BisocMOrg/Keel/chassis/renders/assets/keel_mask_apertures.png

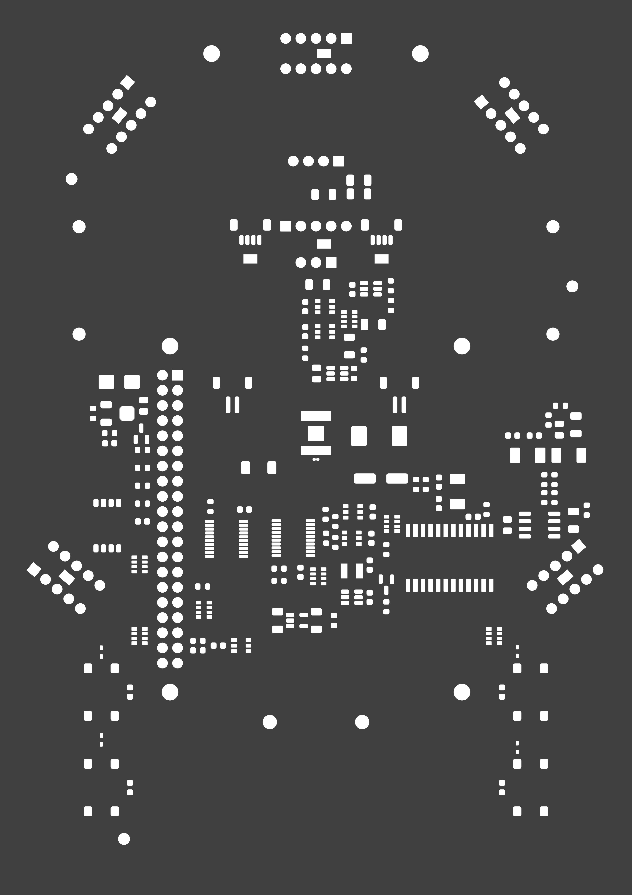
chassis/renders/assets/keel_mask_apertures.png
