BisocMOrg/Keel/chassis/renders/assets/keel_silkscreen_white.png

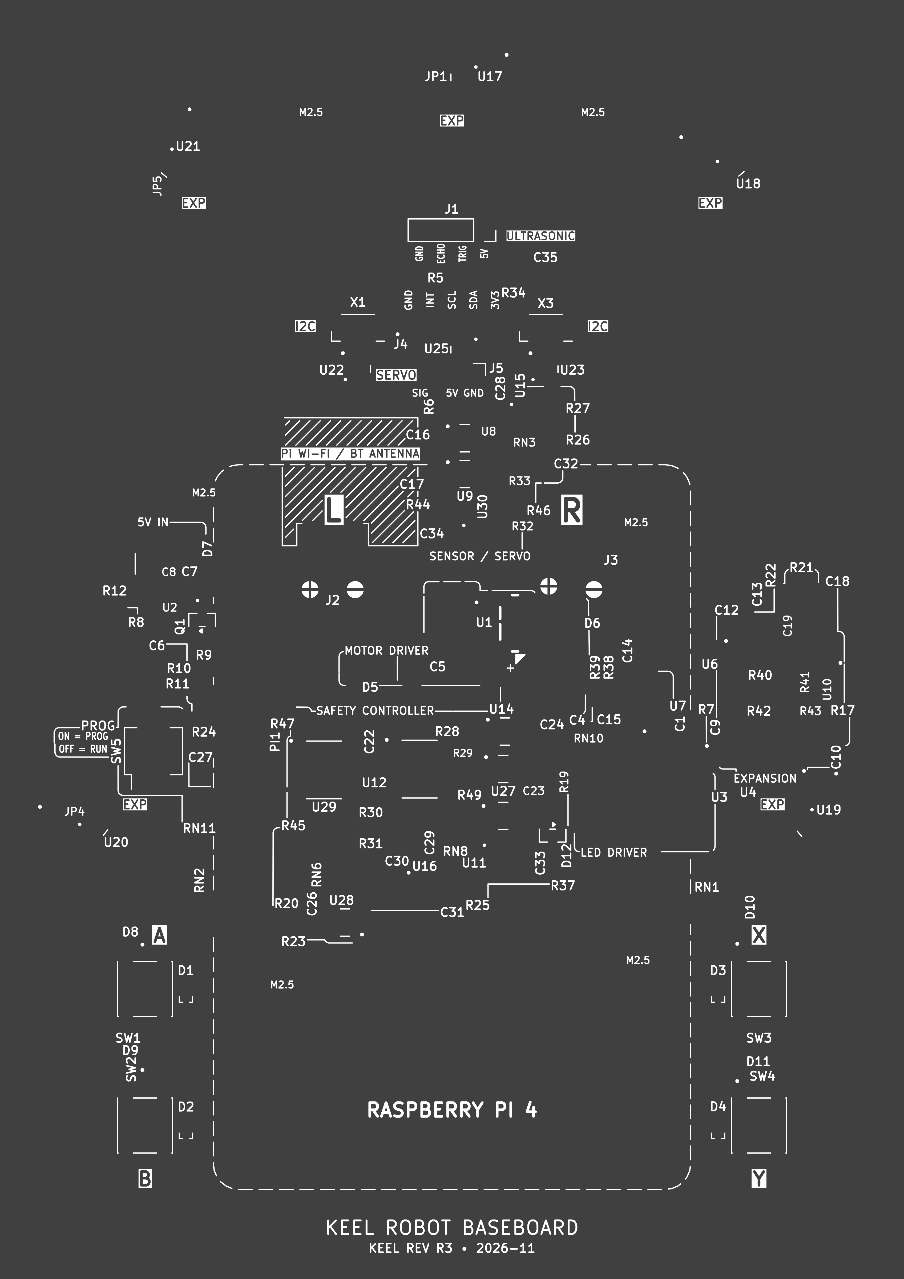
chassis/renders/assets/keel_silkscreen_white.png
