BisocMOrg/Keel/hardware/physical/1_IMG_20261031_002630.jpg

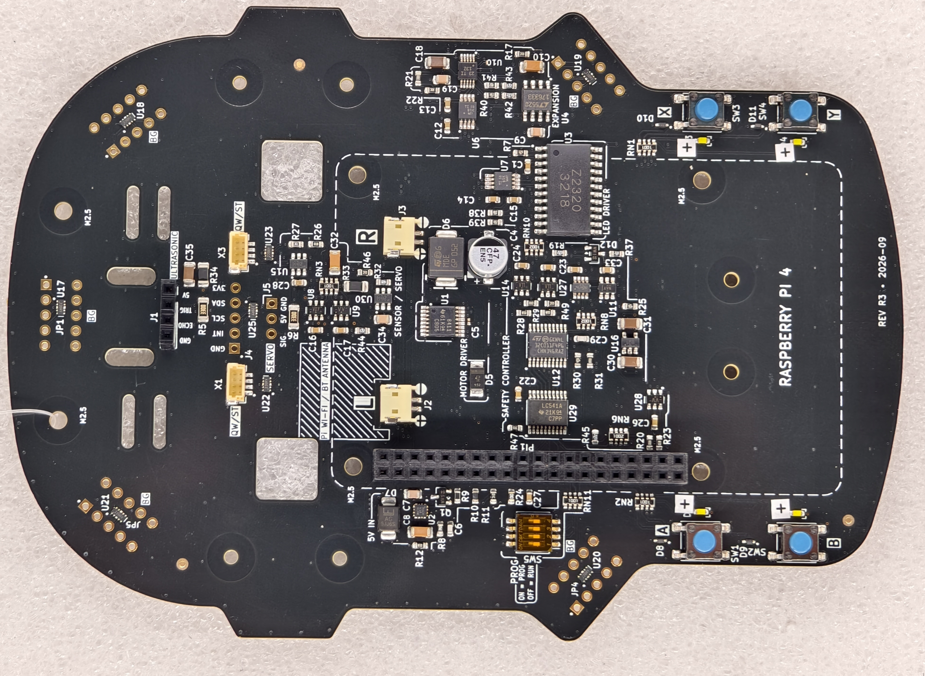
hardware/physical/1_IMG_20261031_002630.jpg
