BisocMOrg/Keel/hardware/physical/2_IMG_20261031_002616.jpg

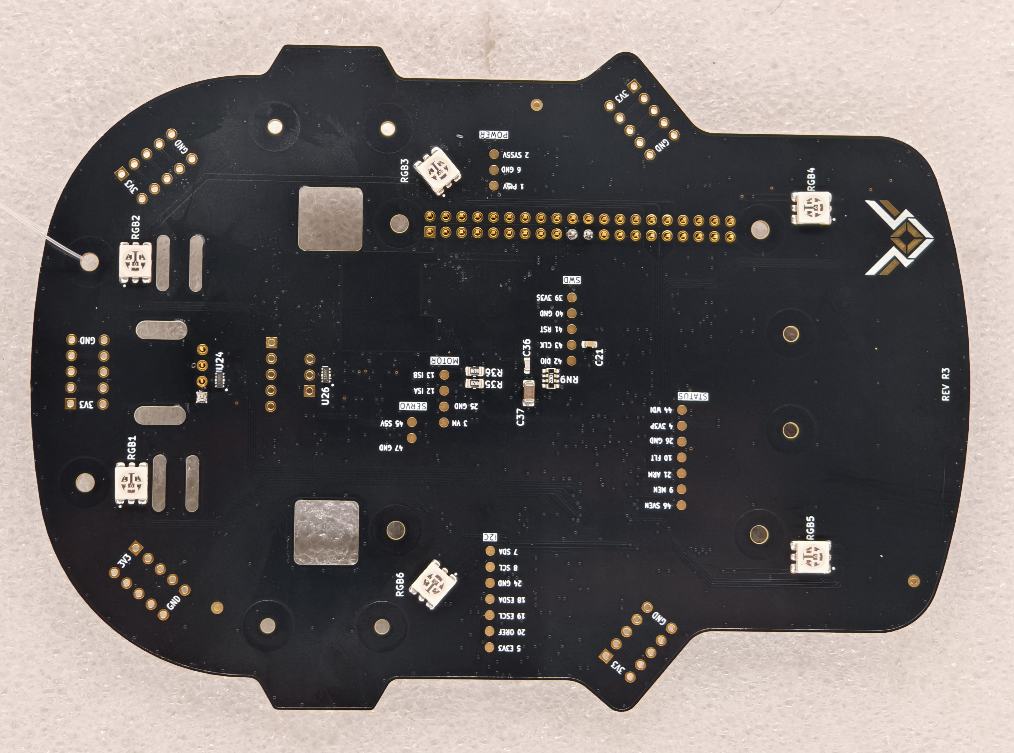
hardware/physical/2_IMG_20261031_002616.jpg
