BisocMOrg/Keel/hardware/renders/Keel_R3_bottom.png

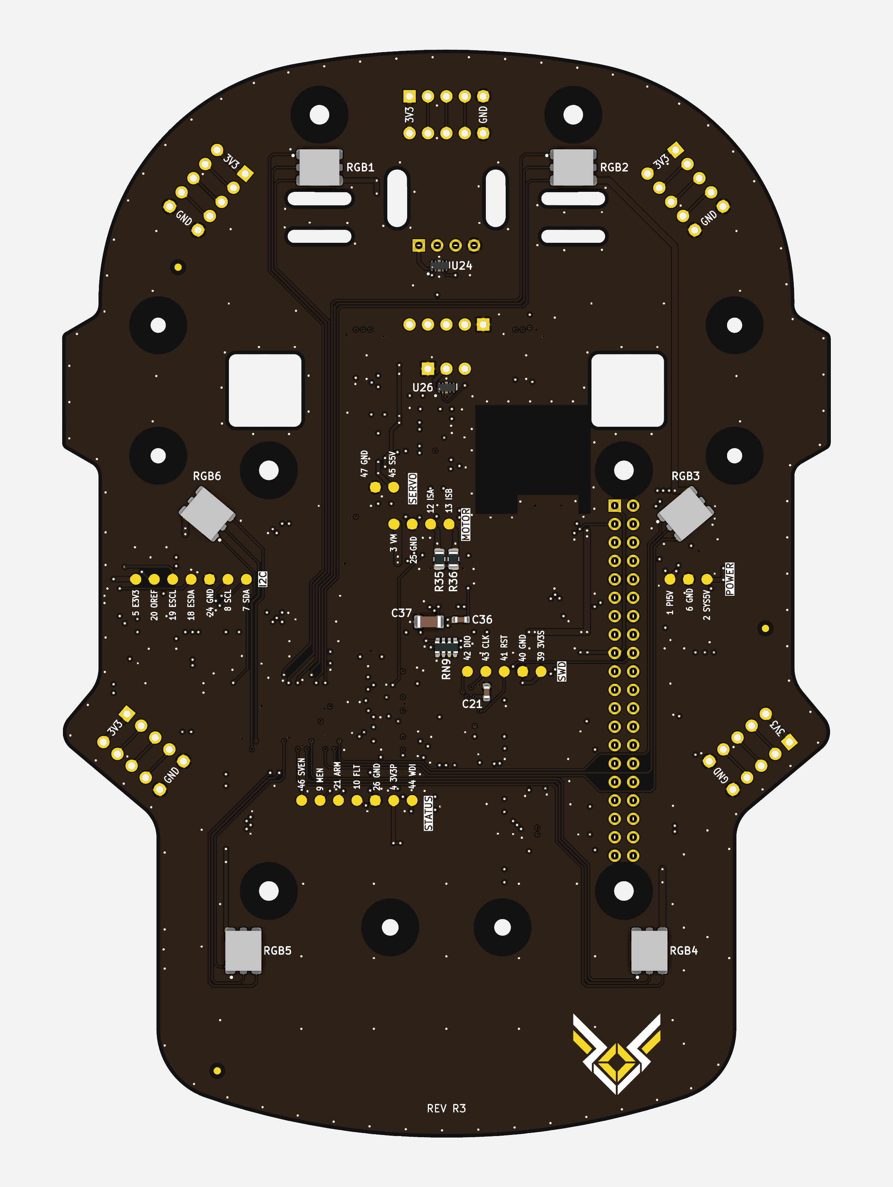
hardware/renders/Keel_R3_bottom.png
