BisocMOrg/Keel/hardware/renders/Keel_R3_three_quarter.png

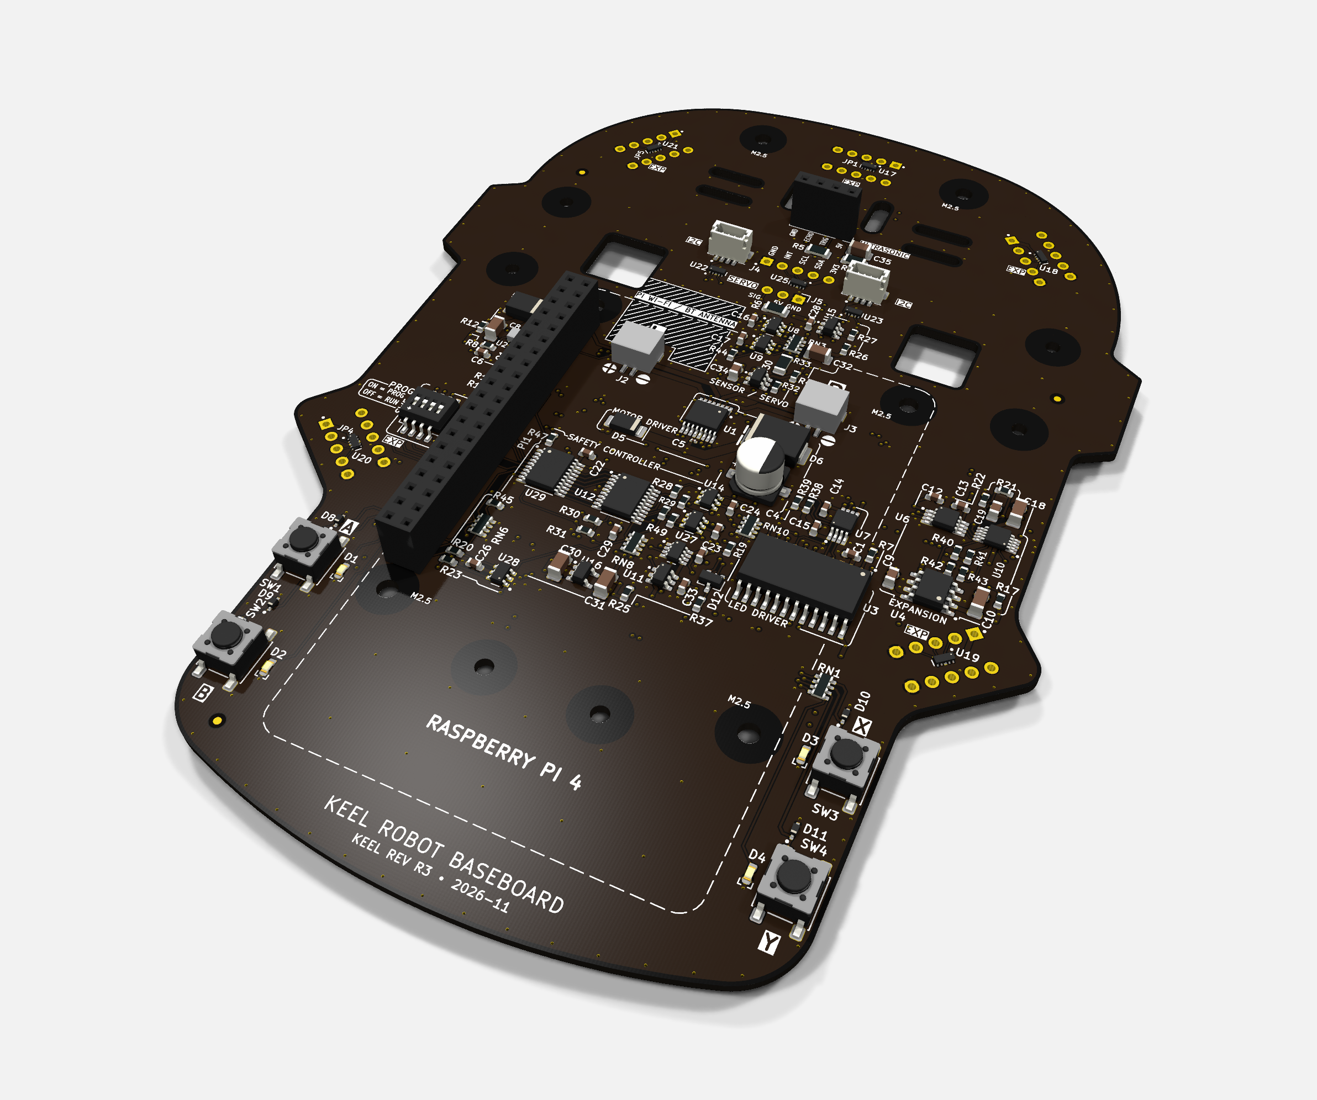
hardware/renders/Keel_R3_three_quarter.png
