BisocMOrg/Keel/hardware/renders/Keel_R3_top.png

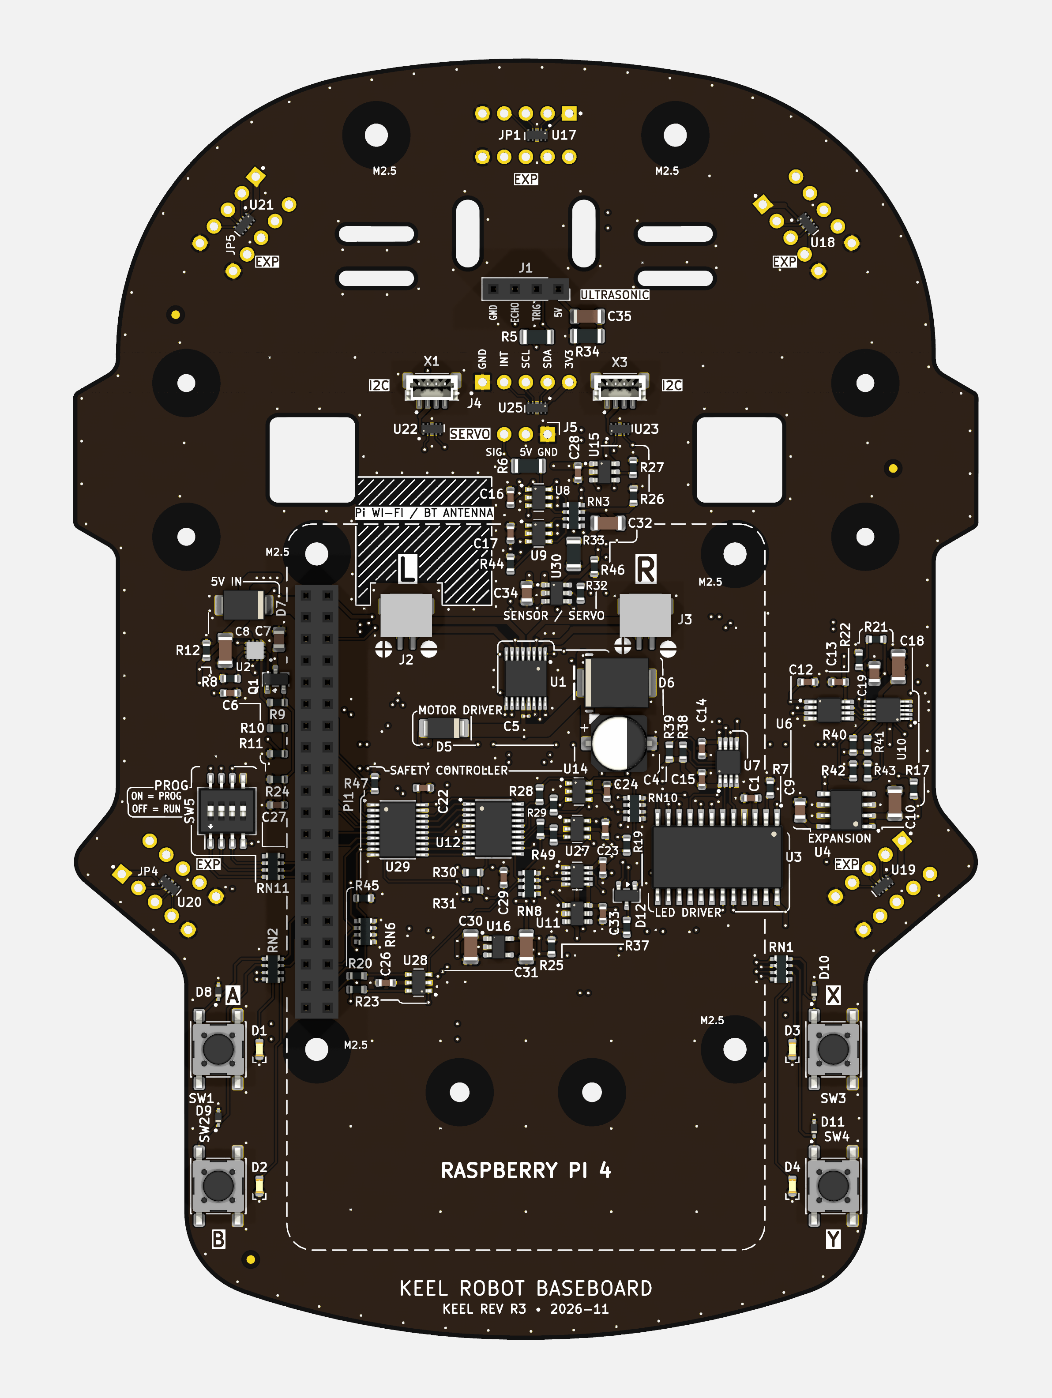
hardware/renders/Keel_R3_top.png
