BisocMOrg/Keel/software/demonstrator/python/mock-camera.jpg

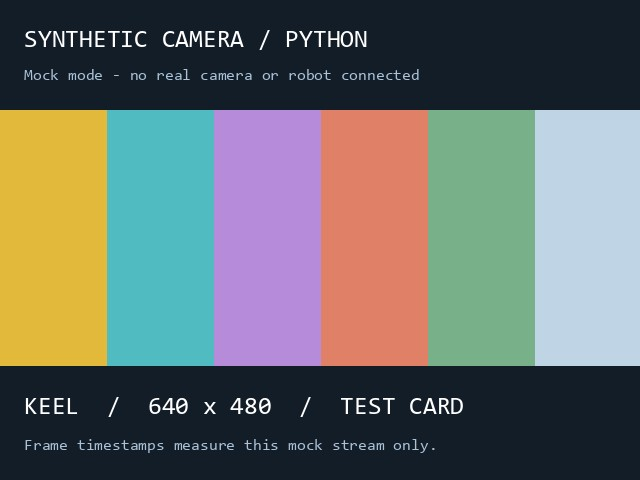
software/demonstrator/python/mock-camera.jpg
