BisocMOrg/Keel/hardware/assembly/Keel_R3_BOM.csv

Item | Qty per board | Designators | Manufacturer | Manufacturer Part Number | Description | Value | Package | Mounting | Side | Approved alternates | Notes | Footprint (CPL)
1 | 1 | PI1 | Samtec | SSW-120-01-G-D | Socket strip, female, 2x20, 2.54 mm pitch, vertical, through-hole, gold, lead style -01 (Raspberry Pi 40-pin) | 2x20 female socket | THT 2x20, 2.54 mm | THT | Top |  | exact part only - no substitution; THT, not in the CPL: hand-solder after reflow, no wave soldering (selective soldering only by prior agreement); seat flush and square; lead style -01 (tail length) required | PinSocket_2x20_P2.54mm_Vertical
2 | 1 | U1 | Texas Instruments | DRV8411PWPR | Dual H-bridge motor driver, 1.65-11 V, current regulation on external sense resistors | DRV8411PWPR | HTSSOP-16 PowerPAD (PWP) | SMD | Top | DRV8833PWPR (TI) - the ONLY accepted alternate; C36/C37 are fitted for it. NOT DRV8411APWPR, NOT any DRV8833 "-HX" clone | exact part only - no substitution (the listed alternate / packaging variant is approved); exposed PowerPAD must be soldered; X-ray first boards | DRV8411A_PWP0016_C01_ExternalVias
3 | 1 | C4 | Panasonic | EEE-FP1C470AP | Aluminium electrolytic capacitor, 47 uF, 16 V, low ESR, SMD (FP series) | 47uF 16V | SMD Al-electrolytic 6.3 x 5.8 mm | SMD | Top |  | POLARIZED: + terminal on pad 1 (VM_MOTOR); 5.8 mm tall | CP_Elec_6.3x5.8
4 | 2 | J2,J3 | JST | S2B-ZR-SM4A-TF(LF)(SN) | Connector header, JST ZH, 2-pos, 1.5 mm pitch, side entry, SMD, tin | JST ZH 2-pin | SMD, 1x02 + 2 MP | SMD | Top |  | engineering BOM code S2B-ZR-SM4A-TF | JST_ZH_S2B-ZR-SM4A-TF_1x02-1MP_P1.50mm_Horizontal
5 | 1 | U3 | Lumissil | IS31FL3218-GRLS2 | 18-channel constant-current LED driver, I2C | IS31FL3218-GRLS2 | SOP-24 | SMD | Top | IS31FL3218-GRLS2-TR (same part, tape and reel) | exact part only - no substitution (the listed alternate / packaging variant is approved) | IS31FL3218_SOP24
6 | 16 | C1,C12,C13,C14,C15,C16,C17,C21,C22,C23,C24,C25,C26,C27,C28,C33 | Murata | GRM188R72A104KA35D | MLCC 100 nF, 100 V, X7R, +/-10% | 100nF 100V X7R | 0603 (1608 metric) | SMD | Both | packaging suffix only (Murata D<->J paper reel, L<->K embossed reel) | top: C1,C12,C13,C14,C15,C16,C17,C22,C23,C24,C25,C26,C27,C28,C33; bottom: C21 | C_0603_1608Metric
7 | 1 | R7 | YAGEO | RC0603FR-0712KL | Thick-film resistor 12 kohm, 1%, 0.1 W | 12k 1% | 0603 (1608 metric) | SMD | Top |  |  | R_0603_1608Metric
8 | 6 | RGB1,RGB2,RGB3,RGB4,RGB5,RGB6 | Inolux | IN-P55TATRGB | RGB LED, top-view, 3 chips (R/G/B), PLCC-6 | RGB LED | PLCC-6 5.0 x 5.5 mm | SMD | Bottom |  | BOTTOM side (top-view LED mounted on B, emits away from the board); pin 1 = silk dot / chamfered corner on sheet 2 of Keel_R3_assembly_drawing.pdf (pad 1 = blue cathode, pads 4-6 common anode); bottom CPL angles are KiCad-native (X not mirrored), so orient by that sheet | LED_Inolux_IN-P55TATRGB_PLCC6_5.0x5.5mm_P1.8mm
9 | 2 | X1,X3 | JST | BM04B-SRSS-TB(LF)(SN) | Connector header, JST SH, 4-pos, 1.0 mm pitch, vertical (top entry), SMD, tin | I2C JST-SH 4P | SMD, 1x04 + 2 MP | SMD | Top |  | engineering BOM code BM04B-SRSS-TB | JST_SH_BM04B-SRSS-TB_1x04-1MP_P1.00mm_Vertical
10 | 1 | J1 | Samtec | SSW-104-01-G-S | Socket strip, female, 1x4, 2.54 mm pitch, vertical, through-hole, gold, lead style -01 (HC-SR04) | 1x4 female socket | THT 1x4, 2.54 mm | THT | Top |  | exact part only - no substitution; THT, not in the CPL: hand-solder after reflow, no wave soldering (selective soldering only by prior agreement); seat flush and square | PinSocket_1x04_P2.54mm_Vertical
11 | 2 | R5,R6 | YAGEO | RC1206FR-07330RL | Thick-film resistor 330 ohm, 1%, 0.25 W | 330R 1% | 1206 (3216 metric) | SMD | Top |  |  | R_1206_3216Metric
12 | 4 | RN1,RN2,RN3,RN11 | YAGEO | YC164-FR-071KL | Resistor array, 4 x 1 kohm, 1%, isolated, convex terminals | 4x 1k 1% | YC164 array 3.2 x 1.6 mm (4x0603) | SMD | Top |  |  | YC164_4x0603
13 | 4 | D1,D2,D3,D4 | Wurth Elektronik | 150060WS75000 | LED, white, 0603, water-clear, max. height 0.5 mm | LED white | 0603 (1608 metric) | SMD | Top |  | POLARITY: the body mark is the ANODE -> PCB pad 2 (LED_x_A), away from the silk cathode bracket; CPL angle already includes +180 deg | LED_0603_1608Metric
14 | 4 | SW1,SW2,SW3,SW4 | C&K | PTS645SM43SMTR92 LFS | Tactile switch, SPST-NO, 6 x 6 mm, 4.3 mm height, SMD gull-wing | Tactile switch | SMD 6 x 6 mm | SMD | Top |  | engineering BOM code PTS645SM43SMTR92 | SW_SPST_PTS645Sx43SMTR92
15 | 1 | C5 | Murata | GRM033R61E104KE14D | MLCC 100 nF, 25 V, X5R, +/-10% | 100nF 25V X5R | 0201 (0603 metric) | SMD | Top | packaging suffix only (Murata D<->J paper reel, L<->K embossed reel) | 0201 placed beside U1 | C_0201_0603Metric
16 | 1 | D5 | Nexperia | PMEG6030ELPX | Schottky rectifier, 60 V, 3 A | PMEG6030ELPX | SOD-128 | SMD | Top |  | engineering BOM code PMEG6030ELP,115; POLARIZED: cathode band on pad 1 (VM_MOTOR) | D_SOD-128
17 | 1 | D6 | STMicroelectronics | SM15T6V8A | TVS diode, UNIDIRECTIONAL, 1500 W, 5.8 V stand-off / 6.8 V breakdown | SM15T6V8A | SMC (DO-214AB) | SMD | Top |  | engineering BOM code SM15T6V8A-TR; UNIDIRECTIONAL (not SM15T6V8CA); cathode band on pad 1 (VM_MOTOR) | D_SMC
18 | 7 | R12,R20,R23,R26,R28,R29,R31 | YAGEO | RC0603FR-071KL | Thick-film resistor 1 kohm, 1%, 0.1 W | 1k 1% | 0603 (1608 metric) | SMD | Top |  |  | R_0603_1608Metric
19 | 1 | U2 | Texas Instruments | TPS259474LRPWR | eFuse / protected load switch, 2.7-23 V, 5.5 A, adjustable UV/OV/ILIM | TPS259474LRPWR | VQFN-HR-10 (RPW) 2 x 2 mm | SMD | Top |  | exact part only - no substitution; leadless VQFN-HR; X-ray first boards | TPS25947_RPW0010A
20 | 1 | U4 | Analog Devices | LT1763IS8-3.3#PBF | LDO regulator, 3.3 V fixed, 500 mA, low noise | LT1763-3.3 | SOIC-8 | SMD | Top | LT1763IS8-3.3#TRPBF (same part, tape and reel) |  | SOIC-8_3.9x4.9mm_P1.27mm
21 | 1 | R8 | YAGEO | RC0603FR-072K21L | Thick-film resistor 2.21 kohm, 1%, 0.1 W | 2.21k 1% | 0603 (1608 metric) | SMD | Top |  |  | R_0603_1608Metric
22 | 1 | R9 | Panasonic | ERA-3ARB3162V | Thin-film resistor 31.6 kohm, 0.1%, 10 ppm/C, 0.1 W | 31.6k 0.1% | 0603 (1608 metric) | SMD | Top |  |  | R_0603_1608Metric
23 | 1 | R10 | Panasonic | ERA-3ARB3091V | Thin-film resistor 3.09 kohm, 0.1%, 10 ppm/C, 0.1 W | 3.09k 0.1% | 0603 (1608 metric) | SMD | Top |  |  | R_0603_1608Metric
24 | 1 | R11 | YAGEO | RT0603BRB0710KL | Thin-film resistor 10 kohm, 0.1%, 10 ppm/C, 0.1 W | 10k 0.1% | 0603 (1608 metric) | SMD | Top |  |  | R_0603_1608Metric
25 | 1 | C6 | Murata | GRM1885C1H472JA01D | MLCC 4.7 nF, 50 V, C0G, +/-5% | 4.7nF 50V C0G | 0603 (1608 metric) | SMD | Top | packaging suffix only (Murata D<->J paper reel, L<->K embossed reel) |  | C_0603_1608Metric
26 | 4 | C7,C9,C19,C34 | Murata | GRM219R71E105KA88D | MLCC 1 uF, 25 V, X7R, +/-10% | 1uF 25V X7R | 0805 (2012 metric) | SMD | Top | packaging suffix only (Murata D<->J paper reel, L<->K embossed reel) |  | C_0805_2012Metric
27 | 3 | C8,C10,C32 | Murata | GRM31CR71E106KA12L | MLCC 10 uF, 25 V, X7R, +/-10% | 10uF 25V X7R | 1206 (3216 metric) | SMD | Top | packaging suffix only (Murata D<->J paper reel, L<->K embossed reel) |  | C_1206_3216Metric
28 | 1 | U11 | Texas Instruments | TPS3808G50DBVT | Voltage supervisor, 4.65 V threshold, adjustable delay | TPS3808G50DBVT | SOT-23-6 | SMD | Top |  | exact part only - no substitution | SOT-23-6
29 | 4 | RN6,RN8,RN9,RN10 | YAGEO | YC164-FR-0710KL | Resistor array, 4 x 10 kohm, 1%, isolated, convex terminals | 4x 10k 1% | YC164 array 3.2 x 1.6 mm (4x0603) | SMD | Both |  | top: RN6,RN8,RN10; bottom: RN9 | YC164_4x0603
30 | 2 | U6,U7 | Texas Instruments | TCA9517ADGKR | Level-translating I2C bus repeater | TCA9517ADGKR | VSSOP-8 (DGK) | SMD | Top |  | exact part only - no substitution | VSSOP-8_3x3mm_P0.65mm
31 | 1 | U8 | Nexperia | 74LVC2G07GV,125 | Dual buffer, open-drain outputs, 5.5 V tolerant | 74LVC2G07GV | SOT457 (SC-74, 6-pin) | SMD | Top | 74LVC2G07GV-Q100H (Nexperia, same pinout). NOT non-Nexperia "74LVC2G07GV" listings |  | Nexperia_SOT457_SC74_1.5x2.9mm_P0.95mm
32 | 2 | U9,U28 | Nexperia | 74LVC2G17GV,125 | Dual non-inverting Schmitt-trigger buffer | 74LVC2G17GV | SOT457 (SC-74, 6-pin) | SMD | Top |  |  | Nexperia_SOT457_SC74_1.5x2.9mm_P0.95mm
33 | 5 | R17,R46,R47,R48,R49 | YAGEO | RC0603FR-0710KL | Thick-film resistor 10 kohm, 1%, 0.1 W | 10k 1% | 0603 (1608 metric) | SMD | Top |  |  | R_0603_1608Metric
34 | 5 | R19,R42,R43,R44,R45 | YAGEO | RC0603FR-0722KL | Thick-film resistor 22 kohm, 1%, 0.1 W | 22k 1% | 0603 (1608 metric) | SMD | Top |  |  | R_0603_1608Metric
35 | 1 | U10 | Texas Instruments | TPD2S703QDGSRQ1 | 2-channel data-line short-to-battery protection with ESD, automotive | TPD2S703-Q1 | VSSOP-10 (DGS), 0.5 mm pitch | SMD | Top |  | exact part only - no substitution; 0.5 mm pitch | MSOP-10_3x3mm_P0.5mm
36 | 5 | C18,C30,C31,C35,C37 | Murata | GRM31CR71H475KA12L | MLCC 4.7 uF, 50 V, X7R, +/-10% | 4.7uF 50V X7R | 1206 (3216 metric) | SMD | Both | packaging suffix only (Murata D<->J paper reel, L<->K embossed reel) | top: C18,C30,C31,C35; bottom: C37 | C_1206_3216Metric
37 | 1 | R21 | YAGEO | RC0603FR-07118KL | Thick-film resistor 118 kohm, 1%, 0.1 W | 118k 1% | 0603 (1608 metric) | SMD | Top |  |  | R_0603_1608Metric
38 | 1 | R22 | YAGEO | RC0603FR-0720KL | Thick-film resistor 20 kohm, 1%, 0.1 W | 20k 1% | 0603 (1608 metric) | SMD | Top |  |  | R_0603_1608Metric
39 | 10 | U17,U18,U19,U20,U21,U22,U23,U24,U25,U26 | Texas Instruments | TPD4E05U06DQAR | 4-channel ESD protection array, low capacitance | TPD4E05U06 | USON-10 (DQA) 2.5 x 1.0 mm, 0.5 mm pitch | SMD | Both |  | exact part only - no substitution; 0.5 mm pitch leadless; ganged mask windows are intentional; X-ray first boards; PIN 1 = the silk DOT end (chamfered corner on the assembly drawing) - the short silk bar at the opposite end is NOT a pin-1 mark; rotated 180 deg it still solders but loses ESD protection, so check pin 1; U17-U21 sit inside the crossed-out (DNP) JP1-JP5 outlines on the assembly drawing - FIT them, only the JP headers are DNP; top: U17,U18,U19,U20,U21,U22,U23,U25; bottom: U24,U26 | TI_DQA0010A_TPD4E05U06_AB_Compatible_CommonMask
40 | 4 | D8,D9,D10,D11 | Texas Instruments | TPD1E05U06DYAR | 1-channel ESD protection diode, low capacitance | TPD1E05U06 | SOD-523 (DYA) | SMD | Top |  | exact part only - no substitution; orientation: pad 1 = IO, pad 2 = GND (TI DYA0002A pin 1) | TI_DYA0002A_TPD1E05U06_SOD523
41 | 1 | U12 | STMicroelectronics | STM32C011F4P6 | MCU, Arm Cortex-M0+, 16 KB flash (supplied BLANK - not programmed) | STM32C011F4P6 | TSSOP-20 | SMD | Top | STM32C011F4P6TR (same part, tape and reel) | exact part only - no substitution (the listed alternate / packaging variant is approved); place BLANK - no programming service; it is programmed in circuit after assembly (hardware/docs/bringup.md) | TSSOP-20_4.4x6.5mm_P0.65mm
42 | 1 | U13 | Texas Instruments | TPS3436CABFDDDFRQ1 | Window watchdog timer, automotive, pinout C, fixed timing code | TPS3436CABFDDDFRQ1 | SOT-23-8 (DDF) | SMD | Top |  | exact part only - no substitution; no alternate (watchdog timing / pinout code is fixed) | TI_DDF0008A_1.6x2.9mm_P0.65mm_CommonMask
43 | 2 | U14,U27 | Nexperia | 74LVC1G11GV,125 | Single 3-input AND gate | 74LVC1G11GV | SOT457 (SC-74, 6-pin) | SMD | Top |  | exact part only - no substitution | Nexperia_SOT457_SC74_1.5x2.9mm_P0.95mm
44 | 2 | U15,U30 | Texas Instruments | TPS2553DBVR-1 | Current-limited power-distribution switch, adjustable limit, active-high enable | TPS2553-1 | SOT-23-6 | SMD | Top |  | exact part only - no substitution | SOT-23-6
45 | 1 | U16 | Texas Instruments | TPS70933DBVT | LDO regulator, 3.3 V fixed, 150 mA, 30 V input, low Iq | TPS70933 | SOT-23-5 | SMD | Top | TPS70933DBVR (TI, same part, larger reel) | exact part only - no substitution (the listed alternate / packaging variant is approved) | SOT-23-5
46 | 1 | R25 | YAGEO | RC0603FR-07470RL | Thick-film resistor 470 ohm, 1%, 0.1 W | 470R 1% | 0603 (1608 metric) | SMD | Top |  |  | R_0603_1608Metric
47 | 1 | R27 | YAGEO | RC0603FR-0752K3L | Thick-film resistor 52.3 kohm, 1%, 0.1 W | 52.3k 1% | 0603 (1608 metric) | SMD | Top |  |  | R_0603_1608Metric
48 | 1 | R30 | YAGEO | RC0603FR-0747KL | Thick-film resistor 47 kohm, 1%, 0.1 W | 47k 1% | 0603 (1608 metric) | SMD | Top |  |  | R_0603_1608Metric
49 | 1 | C29 | Murata | GRM1885C1H102JA01D | MLCC 1 nF, 50 V, C0G, +/-5% | 1nF 50V C0G | 0603 (1608 metric) | SMD | Top | packaging suffix only (Murata D<->J paper reel, L<->K embossed reel) |  | C_0603_1608Metric
50 | 1 | U29 | Texas Instruments | SN74LVC541APWR | Octal buffer/line driver, 3-state, 5.5 V tolerant inputs | SN74LVC541A | TSSOP-20 | SMD | Top | SN74LVC541APWRG4 or SN74LVC541APWRE4 (TI, same part) | exact part only - no substitution (the listed alternate / packaging variant is approved) | TSSOP-20_4.4x6.5mm_P0.65mm
51 | 1 | D7 | Littelfuse | SMBJ6.0CA | TVS diode, BIDIRECTIONAL, 600 W, 6.0 V stand-off | SMBJ6.0CA | SMB (DO-214AA) | SMD | Top |  | bidirectional, no polarity | D_SMB
52 | 1 | Q1 | Nexperia | BSS84AK,215 | P-channel MOSFET, 50 V, small-signal | BSS84AK | SOT-23 | SMD | Top |  |  | SOT-23
53 | 1 | R24 | YAGEO | RC0603FR-07100KL | Thick-film resistor 100 kohm, 1%, 0.1 W | 100k 1% | 0603 (1608 metric) | SMD | Top |  |  | R_0603_1608Metric
54 | 1 | R32 | YAGEO | RC0603FR-07210KL | Thick-film resistor 210 kohm, 1%, 0.1 W | 210k 1% | 0603 (1608 metric) | SMD | Top |  |  | R_0603_1608Metric
55 | 2 | R33,R34 | Vishay | CRCW12062R20FKEAHP | Thick-film resistor 2.2 ohm, 1%, 0.75 W, pulse-proof (HP) | 2.2R 1% | 1206 (3216 metric) | SMD | Top |  |  | R_1206_3216Metric
56 | 2 | R35,R36 | YAGEO | RL0805FR-070R82L | Current-sense resistor 0.82 ohm, 1%, 0.125 W | 0.82R 1% | 0805 (2012 metric) | SMD | Bottom | ERJ-6BQFR82V (Panasonic, 0.82 ohm 1% 0805) | motor current-sense shunts (BOTTOM side, under U1) | R_0805_2012Metric
57 | 1 | C36 | Murata | GRM1885C1H103JA01D | MLCC 10 nF, 50 V, C0G, +/-5% | 10nF 50V C0G | 0603 (1608 metric) | SMD | Bottom | packaging suffix only (Murata D<->J paper reel, L<->K embossed reel) |  | C_0603_1608Metric
58 | 1 | SW5 | C&K | TDA04H0SB1R | DIP switch, 4-position SPST, 1.27 mm half pitch, tape-sealed, SMD, 2.3 mm tall | 4-pos DIP switch | SMD 8-pad, 1.27 mm | SMD | Top |  | exact part only - no substitution; tape-sealed DIP switch: keep the seal tape on through reflow and washing; deliver with all 4 poles OFF (= RUN); do not operate or test the actuators; pin 1 per the chamfered corner on the assembly drawing | SW_DIP_SPSTx04_Slide_KingTek_DSHP04TS_W7.62mm_P1.27mm
59 | 1 | R37 | YAGEO | RC0603FR-072K2L | Thick-film resistor 2.2 kohm, 1%, 0.1 W | 2.2k 1% | 0603 (1608 metric) | SMD | Top |  |  | R_0603_1608Metric
60 | 1 | D12 | Nexperia | BAT54C,215 | Dual Schottky diode, common cathode, 30 V, 200 mA | BAT54C | SOT-23 | SMD | Top | BAT54CLT1G (onsemi, same pinout 1=A1 2=A2 3=K) | exact part only - no substitution (the listed alternate / packaging variant is approved) | SOT-23
61 | 4 | R38,R39,R40,R41 | YAGEO | RC0603FR-071K8L | Thick-film resistor 1.8 kohm, 1%, 0.1 W | 1.8k 1% | 0603 (1608 metric) | SMD | Top |  |  | R_0603_1608Metric
