BisocMOrg/Keel/hardware/docs/test_points.csv

ref | number | net | legend | cluster | side | pad | x_board_mm | y_board_mm | x_gerber_mm | y_gerber_mm | legend_x_mm | legend_y_mm | legend_distance_mm | function | expected
TP1 | 1 | PI_5V | 1 PI5V | POWER | bottom | 1.5 mm round, bare ENIG, no paste | 72.166 | 113.034 | 72.166 | -113.034 | 72.166 | 116.264 | 3.23 | board 5 V input (Pi header pins 2/4) | 5.0-5.1 V from the Pi supply or bench (keep <= 5.2 V; U2 over-voltage trip 5.28-5.47 V)
TP2 | 2 | SYS_5V | 2 SYS5V | POWER | bottom | 1.5 mm round, bare ENIG, no paste | 67.086 | 113.034 | 67.086 | -113.034 | 67.086 | 116.594 | 3.56 | switched 5 V after eFuse U2 | within about 60 mV of TP1 when U2 is on; 0 V after a U2 trip; reads about 1 kOhm to GND unpowered (R12 bleed)
TP3 | 3 | VM_MOTOR | 3 VM | MOTOR | bottom | 1.5 mm round, bare ENIG, no paste | 110.266 | 105.414 | 110.266 | -105.414 | 110.266 | 107.984 | 2.57 | motor supply (DRV8411 VM, C4 47 uF) | TP2 minus the D5 Schottky drop: close to TP2 at rest, 0.3-0.4 V below it with the motors running
TP4 | 4 | PI_3V3 | 4 3V3P | STATUS | bottom | 1.5 mm round, bare ENIG, no paste | 110.266 | 143.514 | 110.266 | -143.514 | 110.266 | 140.284 | 3.23 | Pi 3.3 V rail | 3.3 V with the Pi running; about 0 V with no Pi (no phantom rail)
TP5 | 5 | EXP_3V3 | 5 E3V3 | I2C | bottom | 1.5 mm round, bare ENIG, no paste | 145.826 | 113.034 | 145.826 | -113.034 | 145.826 | 116.264 | 3.23 | expansion 3.3 V (I2C connectors and expansion header positions) | 3.3 V (LT1763-3.3, U4) whenever SYS_5V is up
TP6 | 6 | GND | 6 GND | POWER | bottom | 1.5 mm round, bare ENIG, no paste | 69.626 | 113.034 | 69.626 | -113.034 | 69.453 | 115.834 | 2.81 | ground | 0 V reference for the cluster
TP7 | 7 | I2C_SDA | 7 SDA | I2C | bottom | 1.5 mm round, bare ENIG, no paste | 130.586 | 113.034 | 130.586 | -113.034 | 130.586 | 115.934 | 2.90 | host I2C data | Pi I2C1 SDA (GPIO2): 3.3 V idle with the Pi running (Pi pull-up); floats without the Pi
TP8 | 8 | I2C_SCL | 8 SCL | I2C | bottom | 1.5 mm round, bare ENIG, no paste | 133.126 | 113.034 | 133.126 | -113.034 | 133.126 | 115.934 | 2.90 | host I2C clock | Pi I2C1 SCL (GPIO3): 3.3 V idle with the Pi running (Pi pull-up); floats without the Pi
TP9 | 9 | MOTOR_EN | 9 MEN | STATUS | bottom | 1.5 mm round, bare ENIG, no paste | 120.426 | 143.514 | 120.426 | -143.514 | 120.426 | 140.614 | 2.90 | raw motor enable from the Pi | Pi GPIO26: 0 V (R45 22k pull-down) unless the host drives it; HIGH 3.3 V while armed or during the ACK
TP10 | 10 | MOTOR_FAULT | 10 FLT | STATUS | bottom | 1.5 mm round, bare ENIG, no paste | 115.346 | 143.514 | 115.346 | -143.514 | 115.346 | 140.284 | 3.23 | common open-drain fault bus (also resets U12 through R31) | HIGH about 3.3 V when healthy (R19 22k to SAFE_3V3); LOW = fault (U11 SYS_5V < 4.65 V, U13 WDO 22.5-27.5 ms, U15/U30 FAULT). U1 (DRV8411) nFAULT is not connected and is not a source. Blank U12 with SW5 at RUN: 22.5-27.5 ms LOW pulses every ~125-181 ms
TP12 | 12 | MOTOR_ISEN_A | 12 ISA | MOTOR | bottom | 1.5 mm round, bare ENIG, no paste | 105.186 | 105.414 | 105.186 | -105.414 | 105.186 | 102.284 | 3.13 | right motor (bridge A) shunt R35 | 0 V at rest; while driving I x 0.82 Ohm, chopping at VTRIP 180-230 mV (ITRIP 0.22-0.28 A)
TP13 | 13 | MOTOR_ISEN_B | 13 ISB | MOTOR | bottom | 1.5 mm round, bare ENIG, no paste | 102.646 | 105.414 | 102.646 | -105.414 | 102.646 | 102.184 | 3.23 | left motor (bridge B) shunt R36 | 0 V at rest; while driving I x 0.82 Ohm, chopping at VTRIP 180-230 mV (ITRIP 0.22-0.28 A)
TP18 | 18 | EXP_I2C_SDA | 18 ESDA | I2C | bottom | 1.5 mm round, bare ENIG, no paste | 138.206 | 113.034 | 138.206 | -113.034 | 138.206 | 116.594 | 3.56 | expansion I2C data (X1/X3/J4/JP1-JP5 side of U10) | idle about 3.0-3.1 V (R40 1.8k to SAFE_3V3 against R42 22k, through U10; higher with accessory pull-ups); driven LOW < 0.45 V
TP19 | 19 | EXP_I2C_SCL | 19 ESCL | I2C | bottom | 1.5 mm round, bare ENIG, no paste | 140.746 | 113.034 | 140.746 | -113.034 | 140.746 | 116.594 | 3.56 | expansion I2C clock | idle about 3.0-3.1 V (R41 1.8k to SAFE_3V3 against R43 22k, through U10; higher with accessory pull-ups); driven LOW < 0.45 V
TP20 | 20 | I2C_OVP_REF | 20 OREF | I2C | bottom | 1.5 mm round, bare ENIG, no paste | 143.286 | 113.034 | 143.286 | -113.034 | 143.286 | 116.594 | 3.56 | expansion I2C over-voltage reference | 3.45 V +/- 0.2 V (U10 TPD2S703-Q1 mode 1, R21 118k / R22 20k)
TP21 | 21 | HOST_ARMED | 21 ARM | STATUS | bottom | 1.5 mm round, bare ENIG, no paste | 117.886 | 143.514 | 117.886 | -143.514 | 118.036 | 140.024 | 3.49 | armed status to the Pi | 0 V disarmed or without the Pi (RN6 10k pull-down); HIGH 3.3 V = motors armed (buffered MOTOR_EN_SAFE, Pi GPIO21)
TP24 | 24 | GND | 24 GND | I2C | bottom | 1.5 mm round, bare ENIG, no paste | 135.666 | 113.034 | 135.666 | -113.034 | 135.579 | 116.214 | 3.18 | ground | 0 V reference for the cluster
TP25 | 25 | GND | 25 GND | MOTOR | bottom | 1.5 mm round, bare ENIG, no paste | 107.726 | 105.414 | 107.726 | -105.414 | 107.526 | 108.990 | 3.58 | ground | 0 V reference for the cluster
TP26 | 26 | GND | 26 GND | STATUS | bottom | 1.5 mm round, bare ENIG, no paste | 112.806 | 143.514 | 112.806 | -143.514 | 112.600 | 140.284 | 3.24 | ground | 0 V reference for the cluster
TP39 | 39 | SAFE_3V3 | 39 3V3S | SWD | bottom | 1.5 mm round, bare ENIG, no paste | 89.946 | 125.734 | 89.946 | -125.734 | 89.946 | 122.174 | 3.56 | safety-domain 3.3 V (U12, U13, gates) | 3.234-3.366 V (TPS70933, U16); reads about 470 Ohm to GND unpowered (R25 bleed). Probe VTref only: never feed it
TP40 | 40 | GND | 40 GND | SWD | bottom | 1.5 mm round, bare ENIG, no paste | 92.486 | 125.734 | 92.486 | -125.734 | 92.486 | 122.504 | 3.23 | ground | 0 V reference for the cluster
TP41 | 41 | SAFETY_NRST | 41 RST | SWD | bottom | 1.5 mm round, bare ENIG, no paste | 95.026 | 125.734 | 95.026 | -125.734 | 95.026 | 122.504 | 3.23 | U12 NRST (SWD reset) | about 3.3 V running (R30 47k pull-up, C29 1 nF); pulses LOW with every fault-bus LOW (via R31 1k) and while the Pi PROG path resets U12
TP42 | 42 | SAFETY_SWDIO | 42 DIO | SWD | bottom | 1.5 mm round, bare ENIG, no paste | 100.106 | 125.734 | 100.106 | -125.734 | 100.106 | 122.504 | 3.23 | SWD data | SWD data, U12 PA13 (idle pulled up inside U12)
TP43 | 43 | SAFETY_SWCLK | 43 CLK | SWD | bottom | 1.5 mm round, bare ENIG, no paste | 97.566 | 125.734 | 97.566 | -125.734 | 97.566 | 122.504 | 3.23 | SWD clock | SWD clock, U12 PA14-BOOT0 (idle pulled down inside U12)
TP44 | 44 | MCU_WD_SERVICE | 44 WDI | STATUS | bottom | 1.5 mm round, bare ENIG, no paste | 107.726 | 143.514 | 107.726 | -143.514 | 107.676 | 140.197 | 3.32 | U12 PA5 -> U13 WDI (watchdog kick) | programmed, healthy U12: 1 ms HIGH pulse, falling edge every 50 ms; blank U12: no pulses (RN8 10k holds it LOW); failed health checks: static, no falling edge
TP45 | 45 | SERVO_5V | 45 S5V | SERVO | bottom | 1.5 mm round, bare ENIG, no paste | 110.266 | 100.334 | 110.266 | -100.334 | 110.439 | 97.204 | 3.13 | servo supply (J5 pin 2) | 0 V except during a servo burst (U15 on, 5 V, <= 500 ms lease); reads about 1 kOhm to GND unpowered (R26)
TP46 | 46 | SERVO_POWER_EN | 46 SVEN | STATUS | bottom | 1.5 mm round, bare ENIG, no paste | 122.966 | 143.514 | 122.966 | -143.514 | 122.966 | 139.754 | 3.76 | servo switch enable | 0 V except during a servo burst (U27 output, RN10 10k pull-down)
TP47 | 47 | GND | 47 GND | SERVO | bottom | 1.5 mm round, bare ENIG, no paste | 112.806 | 100.334 | 112.806 | -100.334 | 114.306 | 97.104 | 3.56 | ground | 0 V reference for the cluster
