BisocMOrg/Keel/chassis/Keel_R3_robot_assembly.3mf

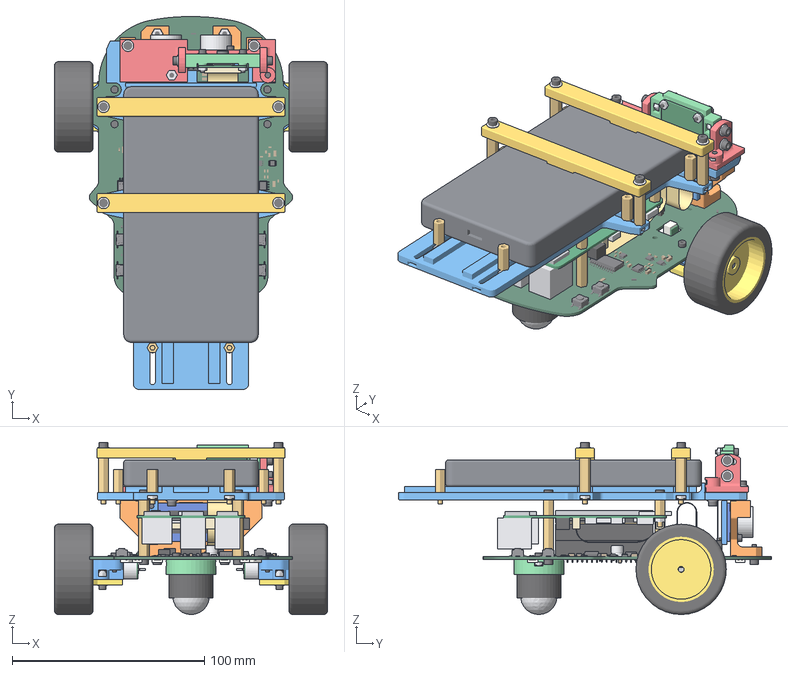
[picture p14: CAD file, 2026-11-09]
chassis/Keel_R3_robot_assembly.3mf
142.0 x 194.0 x 89.5 mm
Keel R3 board
Raspberry Pi 4
2x20 riser header
Gearmotor, left
Gearmotor, right
Wheel, left
Wheel, right
Ball caster
HC-SR04 ultrasonic sensor
Camera Module 3
Camera cable, 150 mm
Power bank (reference size 133 x 70 x 14 mm)
P01 front tower
P02 sensor frame, left
P02 sensor frame, right
P04 tower shim 0.2 mm, left
P04 tower shim 0.2 mm, right
P05 camera mast
P06 camera carrier
P07 motor bracket, left
P07 motor bracket, right
P08 motor cap, left
P08 motor cap, right
P09 caster spacer
P10 top plate
P11 bank bridge, front
P11 bank bridge, rear
Fasteners, front tower foot, left: M2.5 lock nut + M2.5x8 socket head screw
Fasteners, front tower foot, right: M2.5 lock nut + M2.5x8 socket head screw
Fasteners, HC-SR04 clamp, lower right: M2 thin nut + M2x8 socket head screw + M2 washer
Fasteners, HC-SR04 clamp, lower left: M2 thin nut + M2x8 socket head screw + M2 washer
Fasteners, HC-SR04 clamp, upper right: M2 thin nut + M2x8 socket head screw + M2 washer
Fasteners, HC-SR04 clamp, upper left: M2 thin nut + M2x8 socket head screw + M2 washer
Fasteners, camera mast rear, left: M2.5 hex nut + M2.5x12 socket head screw + M2.5 washer
Fasteners, camera mast rear, right: M2.5 hex nut + M2.5x12 socket head screw + M2.5 washer
Fasteners, camera mast tie-in, left: M2.5 lock nut + M2.5x16 socket head screw + M2.5 washer
Fasteners, camera mast tie-in, right: M2.5 lock nut + M2.5x16 socket head screw + M2.5 washer
Fasteners, camera on carrier, lower left: M2 hex nut + M2x10 socket head screw + M2 washer
Fasteners, camera on carrier, upper left: M2 hex nut + M2x10 socket head screw + M2 washer
Fasteners, camera on carrier, lower right: M2 hex nut + M2x10 socket head screw + M2 washer
Fasteners, camera on carrier, upper right: M2 hex nut + M2x10 socket head screw + M2 washer
Fasteners, camera tilt lock, left: M2.5 lock nut + M2.5x10 socket head screw + 3 x 6 x 0.1 steel shim washer + M2.5 washer
Fasteners, camera tilt lock, right: M2.5 lock nut + M2.5x10 socket head screw + 3 x 6 x 0.1 steel shim washer + M2.5 washer
Fasteners, camera pivot, left: M2.5 lock nut + M2.5x10 socket head screw + M2.5 washer
Fasteners, camera pivot, right: M2.5 lock nut + M2.5x10 socket head screw + M2.5 washer
Fasteners, motor bracket, front right: M2 lock nut + M2x8 socket head screw
Fasteners, motor bracket, rear left: M2 lock nut + M2x8 socket head screw
Fasteners, motor bracket, rear right: M2 lock nut + M2x8 socket head screw
Fasteners, motor bracket, front left: M2 lock nut + M2x8 socket head screw
Fasteners, motor cap, front left: M2 lock nut + M2x10 socket head screw + M2 washer
Fasteners, motor cap, rear left: M2 lock nut + M2x10 socket head screw + M2 washer
Fasteners, motor cap, rear right: M2 lock nut + M2x10 socket head screw + M2 washer
Fasteners, motor cap, front right: M2 lock nut + M2x10 socket head screw + M2 washer
Fasteners, caster spacer to board, left: M2 hex nut + M2x6 socket head screw
Fasteners, caster spacer to board, right: M2 hex nut + M2x6 socket head screw
Fasteners, caster to spacer, rear: M2 thin nut + M2x8 socket head screw + M2 washer
Fasteners, caster to spacer, front: M2 thin nut + M2x8 socket head screw + M2 washer
Fasteners, top plate, rear left: M2.5x6 socket head screw + M2.5 washer
Fasteners, top plate, rear right: M2.5x6 socket head screw + M2.5 washer
Fasteners, top plate, front left: M2.5x6 socket head screw + M2.5 washer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
