BisocMOrg/Keel/chassis/print/parts/P04_tower_shim_0.2mm_x2.3mf

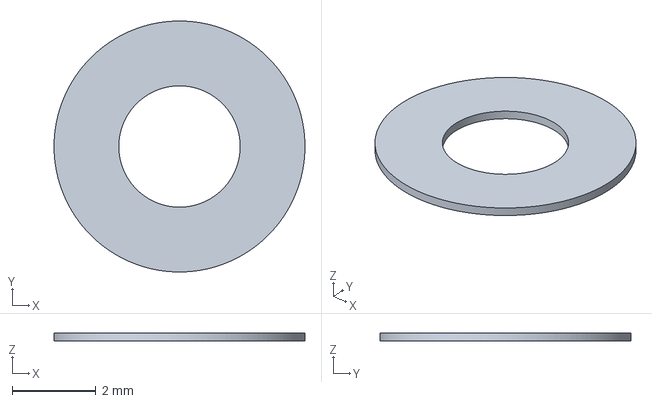
[picture p15: CAD file, 2026-11-09]
chassis/print/parts/P04_tower_shim_0.2mm_x2.3mf
6.00 x 6.00 x 0.2 mm
