BisocMOrg/Keel/chassis/print/plates/plate1_top_plate_front_camera.3mf

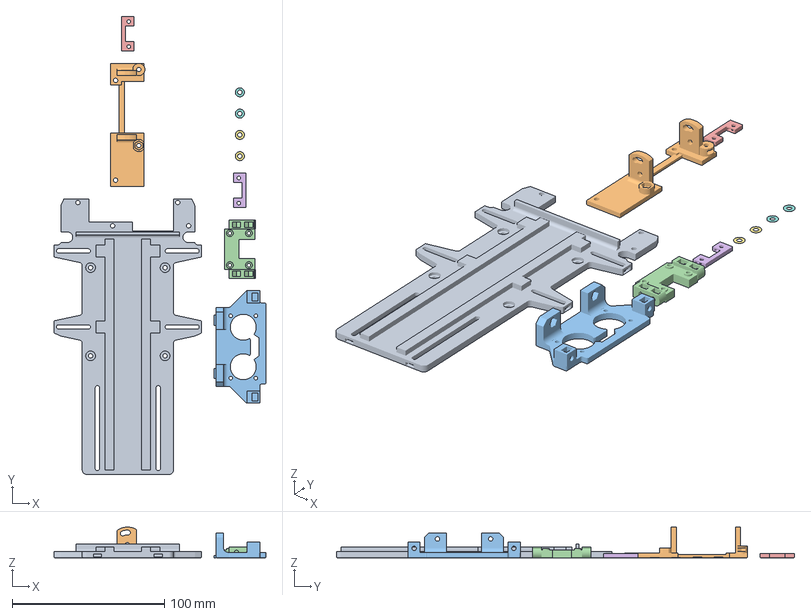
[picture p16: CAD file, 2026-11-09]
chassis/print/plates/plate1_top_plate_front_camera.3mf
139.3 x 301.1 x 20.1 mm
P10_top_plate
P05_camera_mast
P01_front_tower
P06_camera_carrier
P02_sensor_frame_left
P02_sensor_frame_right
P04_tower_shim_0.2mm x 2
P04_tower_shim_0.4mm x 2
