BisocMOrg/Keel/chassis/print/plates/plate2_brackets_spacer_bridges.3mf

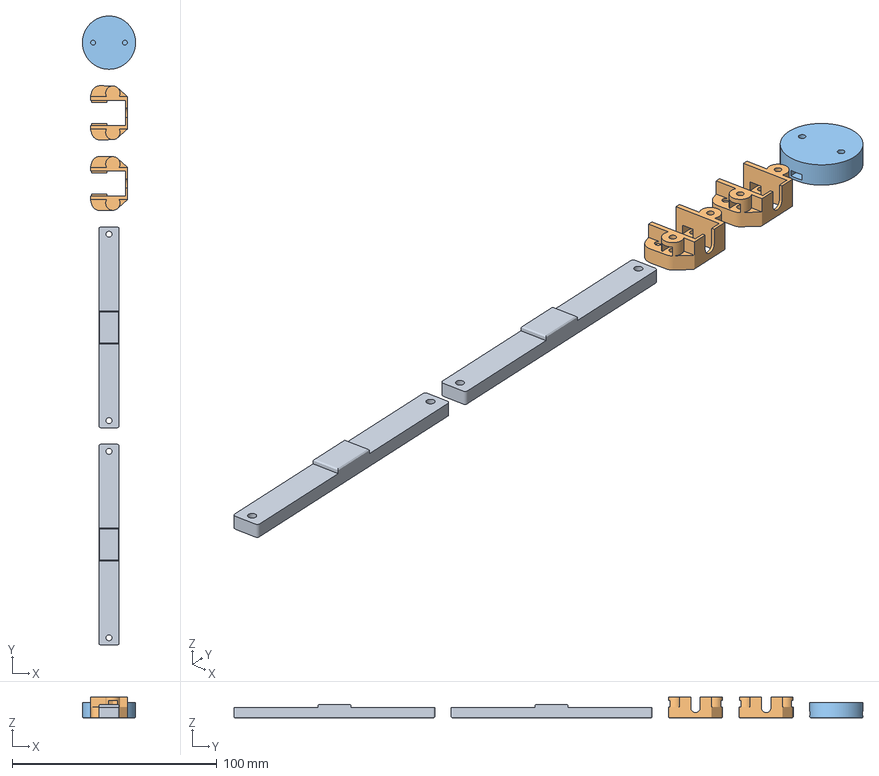
[picture p18: CAD file, 2026-11-09]
chassis/print/plates/plate2_brackets_spacer_bridges.3mf
26.0 x 307.0 x 10.2 mm
P11_bank_bridge x 2
P07_motor_bracket x 2
P09_caster_spacer
