BisocMOrg/Keel/chassis/print/plates/plate4_fit_coupon.3mf

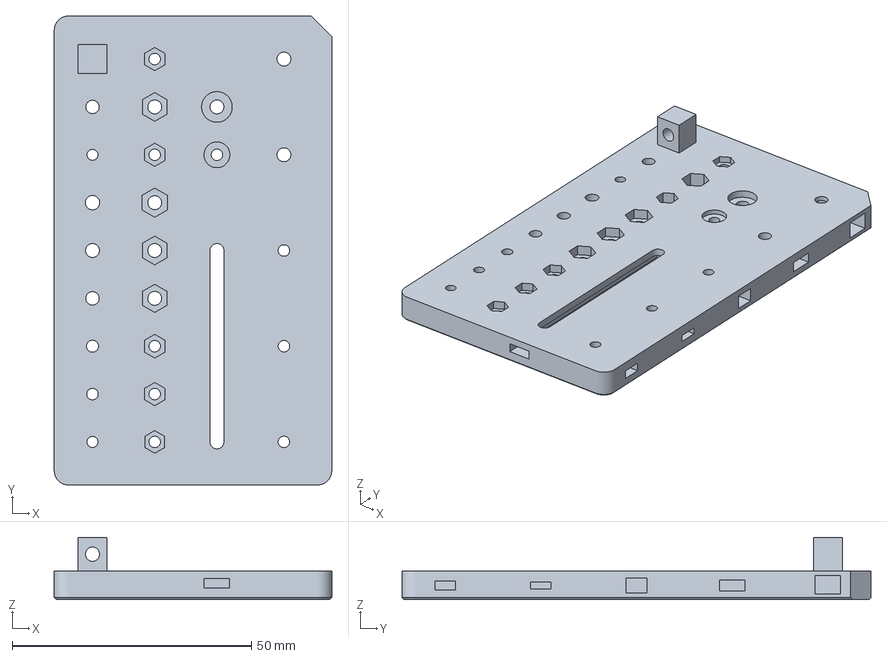
[picture p20: CAD file, 2026-11-09]
chassis/print/plates/plate4_fit_coupon.3mf
58.0 x 98.0 x 13.0 mm
