BisocMOrg/Keel/chassis/print/parts/P03_sensor_shim_0.4mm_x4.3mf

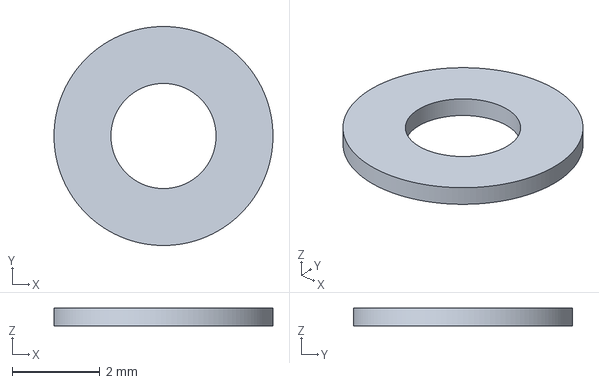
[picture p21: CAD file, 2026-11-09]
chassis/print/parts/P03_sensor_shim_0.4mm_x4.3mf
5.00 x 5.00 x 0.4 mm
