BisocMOrg/Keel/chassis/print/plates/plate3_motor_caps.3mf

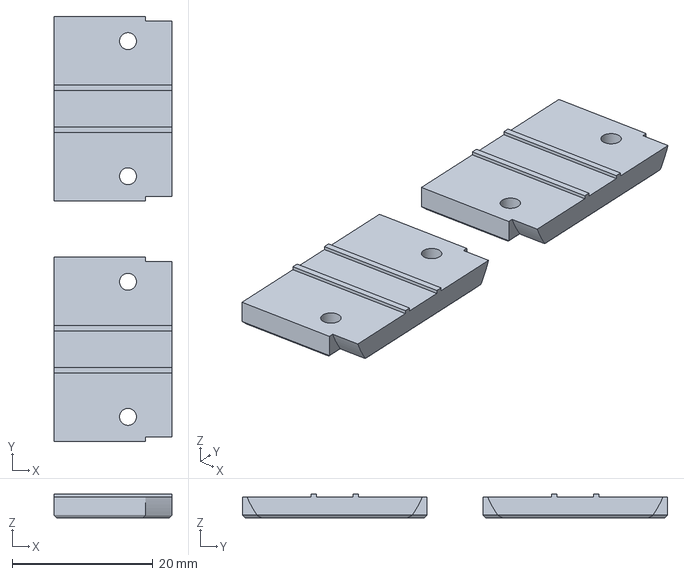
[picture p22: CAD file, 2026-11-09]
chassis/print/plates/plate3_motor_caps.3mf
16.7 x 60.4 x 3.40 mm
P08_motor_cap x 2
