BisocMOrg/Keel/chassis/print/parts/P01_front_tower_x1.3mf

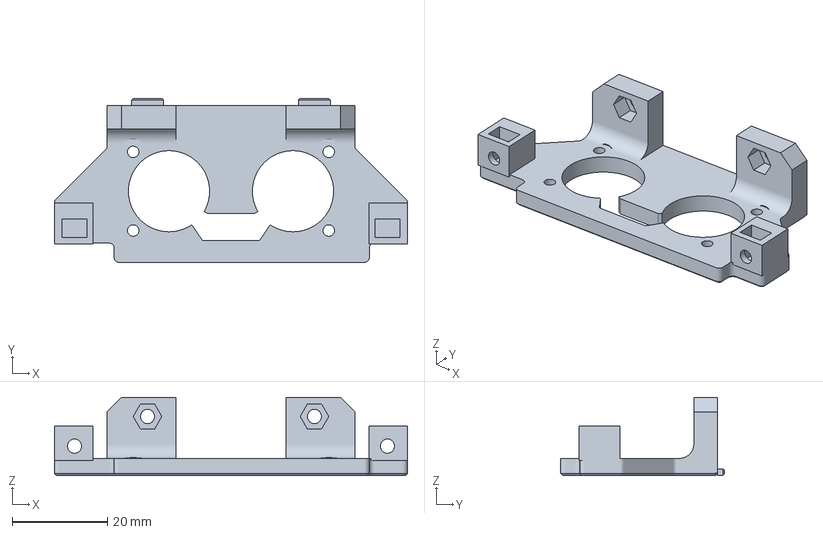
[picture p23: CAD file, 2026-11-09]
chassis/print/parts/P01_front_tower_x1.3mf
74.0 x 34.3 x 16.4 mm
