BisocMOrg/Keel/chassis/print/parts/P06_camera_carrier_x1.3mf

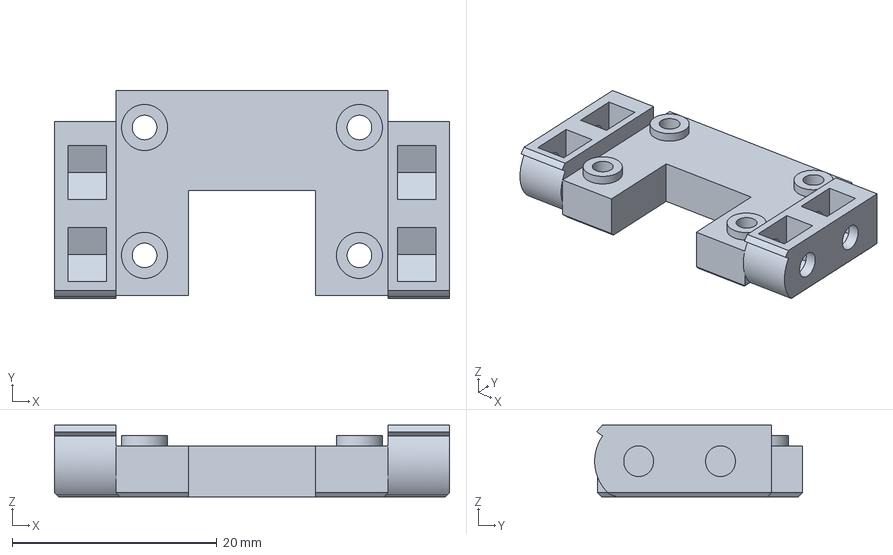
[picture p24: CAD file, 2026-11-09]
chassis/print/parts/P06_camera_carrier_x1.3mf
38.6 x 20.3 x 7.00 mm
