BisocMOrg/Keel/chassis/print/parts/P05_camera_mast_x1.3mf

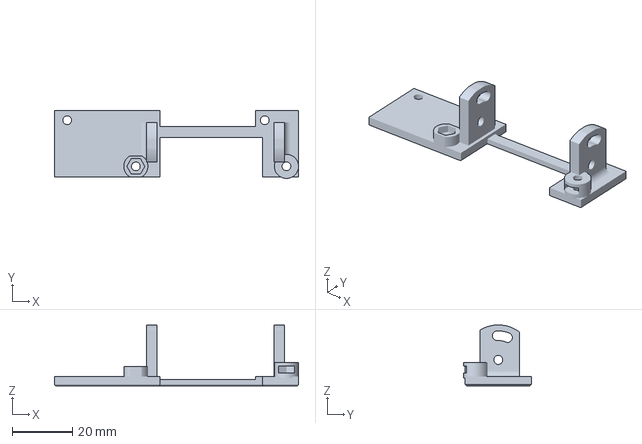
[picture p25: CAD file, 2026-11-09]
chassis/print/parts/P05_camera_mast_x1.3mf
81.0 x 22.5 x 20.1 mm
