BisocMOrg/Keel/chassis/print/parts/P11_bank_bridge_x2.3mf

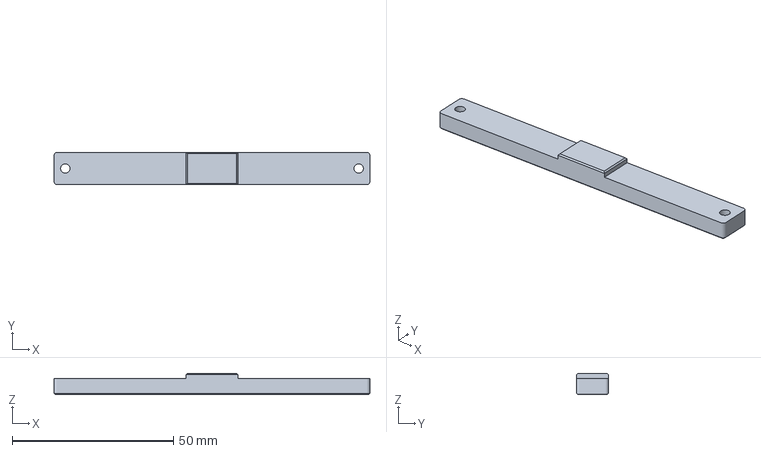
[picture p26: CAD file, 2026-11-09]
chassis/print/parts/P11_bank_bridge_x2.3mf
98.0 x 10.0 x 6.60 mm
