BisocMOrg/Keel/chassis/print/parts/P10_top_plate_x1.3mf

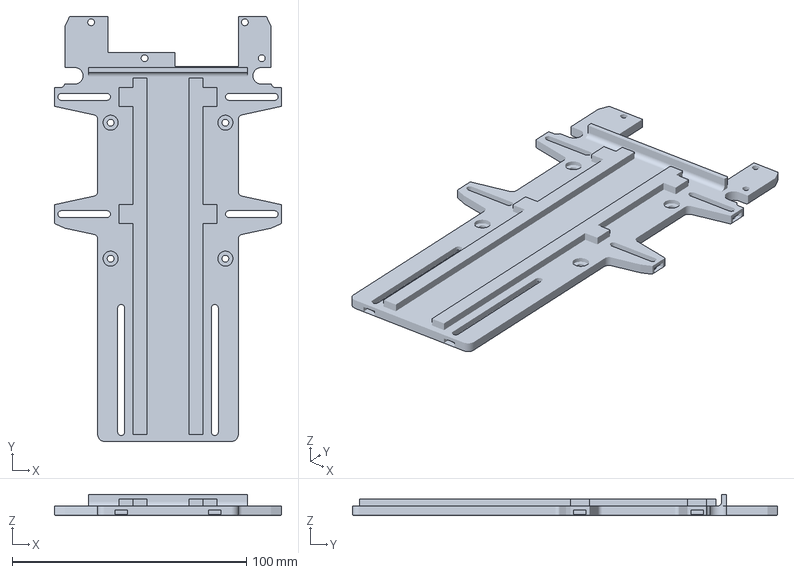
[picture p27: CAD file, 2026-11-09]
chassis/print/parts/P10_top_plate_x1.3mf
97.0 x 181.3 x 9.00 mm
