BisocMOrg/Keel/chassis/print/parts/P08_motor_cap_x2.3mf

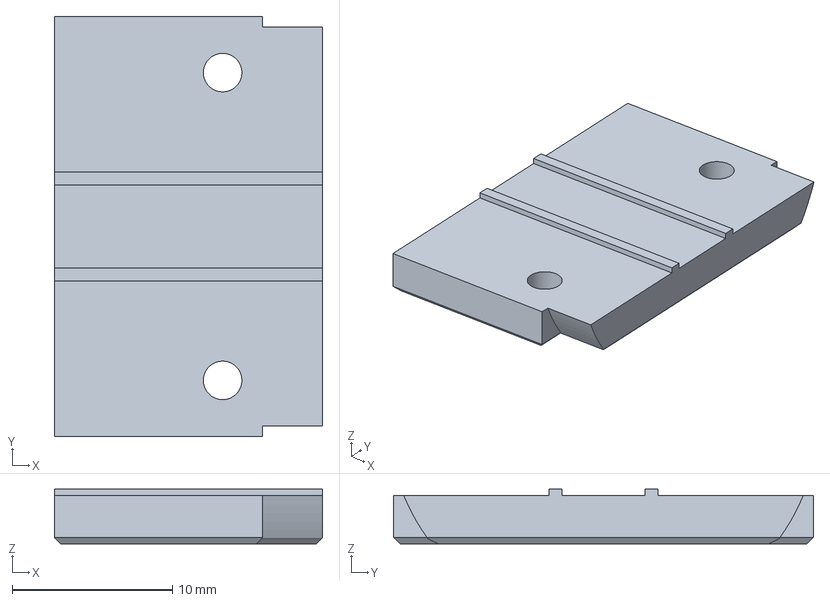
[picture p28: CAD file, 2026-11-09]
chassis/print/parts/P08_motor_cap_x2.3mf
16.7 x 26.2 x 3.40 mm
