BisocMOrg/Keel/chassis/print/parts/P04_tower_shim_0.4mm_x2.3mf

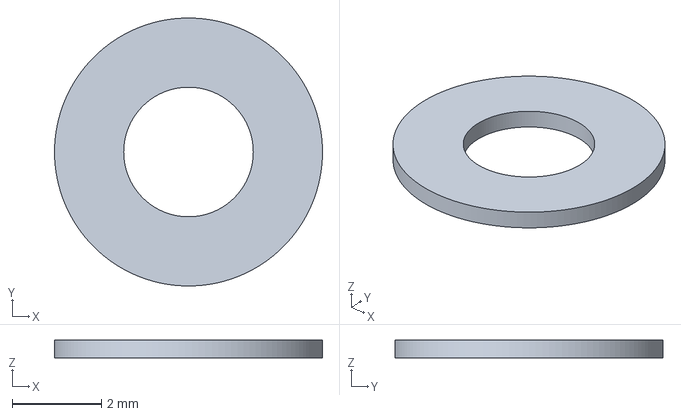
[picture p29: CAD file, 2026-11-09]
chassis/print/parts/P04_tower_shim_0.4mm_x2.3mf
6.00 x 6.00 x 0.4 mm
