BisocMOrg/Keel/chassis/print/parts/P03_sensor_shim_1.0mm_x4.3mf

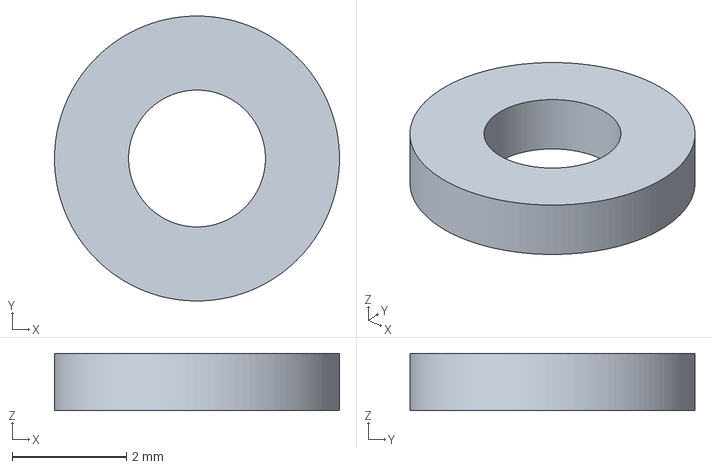
[picture p30: CAD file, 2026-11-09]
chassis/print/parts/P03_sensor_shim_1.0mm_x4.3mf
5.00 x 5.00 x 1.00 mm
