BisocMOrg/Keel/chassis/print/parts/P07_motor_bracket_x2.3mf

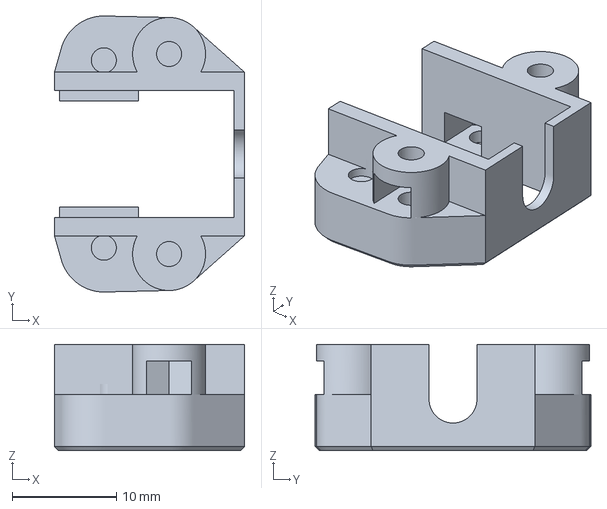
[picture p31: CAD file, 2026-11-09]
chassis/print/parts/P07_motor_bracket_x2.3mf
18.2 x 26.5 x 10.2 mm
