BisocMOrg/Keel/chassis/print/parts/P02_sensor_frame_left_x1.3mf

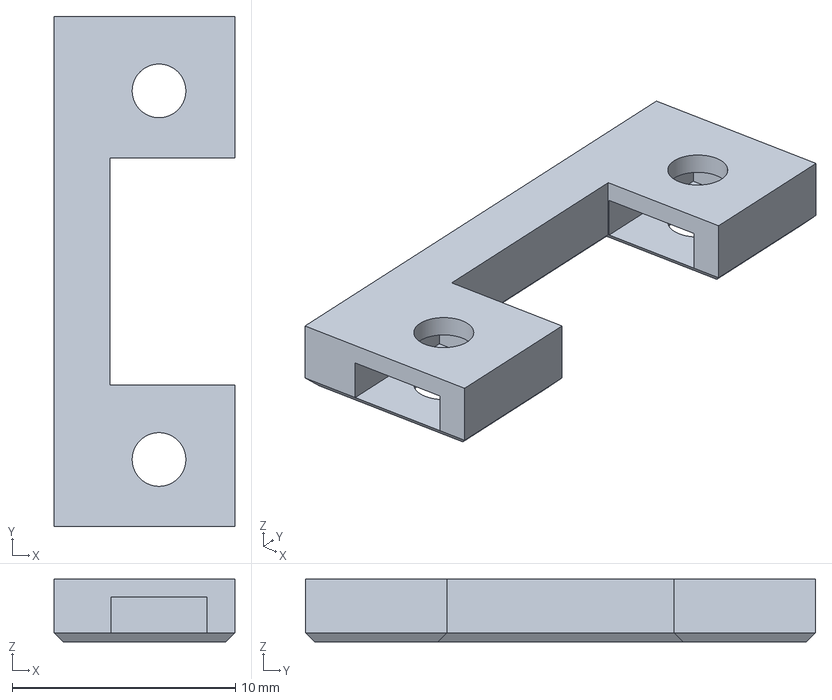
[picture p32: CAD file, 2026-11-09]
chassis/print/parts/P02_sensor_frame_left_x1.3mf
8.10 x 22.8 x 2.80 mm
