BisocMOrg/Keel/chassis/print/parts/P09_caster_spacer_x1.3mf

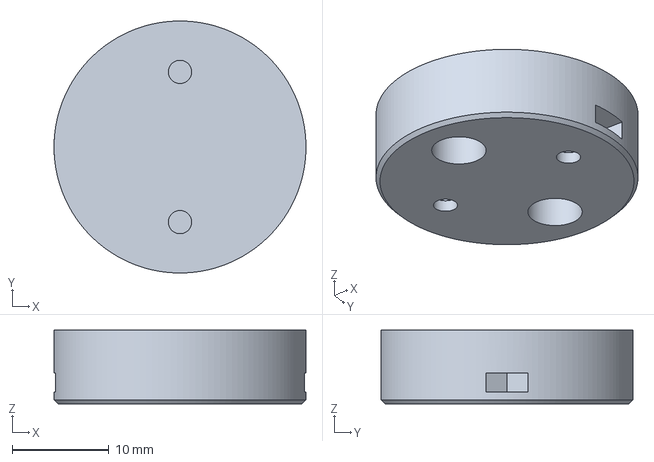
[picture p33: CAD file, 2026-11-09]
chassis/print/parts/P09_caster_spacer_x1.3mf
26.0 x 26.0 x 7.60 mm
