BisocMOrg/Keel/(list of files, cad)

Other CAD files:
hardware/3d/Keel_R3.step
chassis/print/parts/T01_fit_coupon_x1.3mf
chassis/print/parts/P02_sensor_frame_right_x1.3mf
chassis/renders/Keel_R3_studio.blend
