BisocMOrg/Keel/hardware/schematic/Keel_R3_schematic.pdf

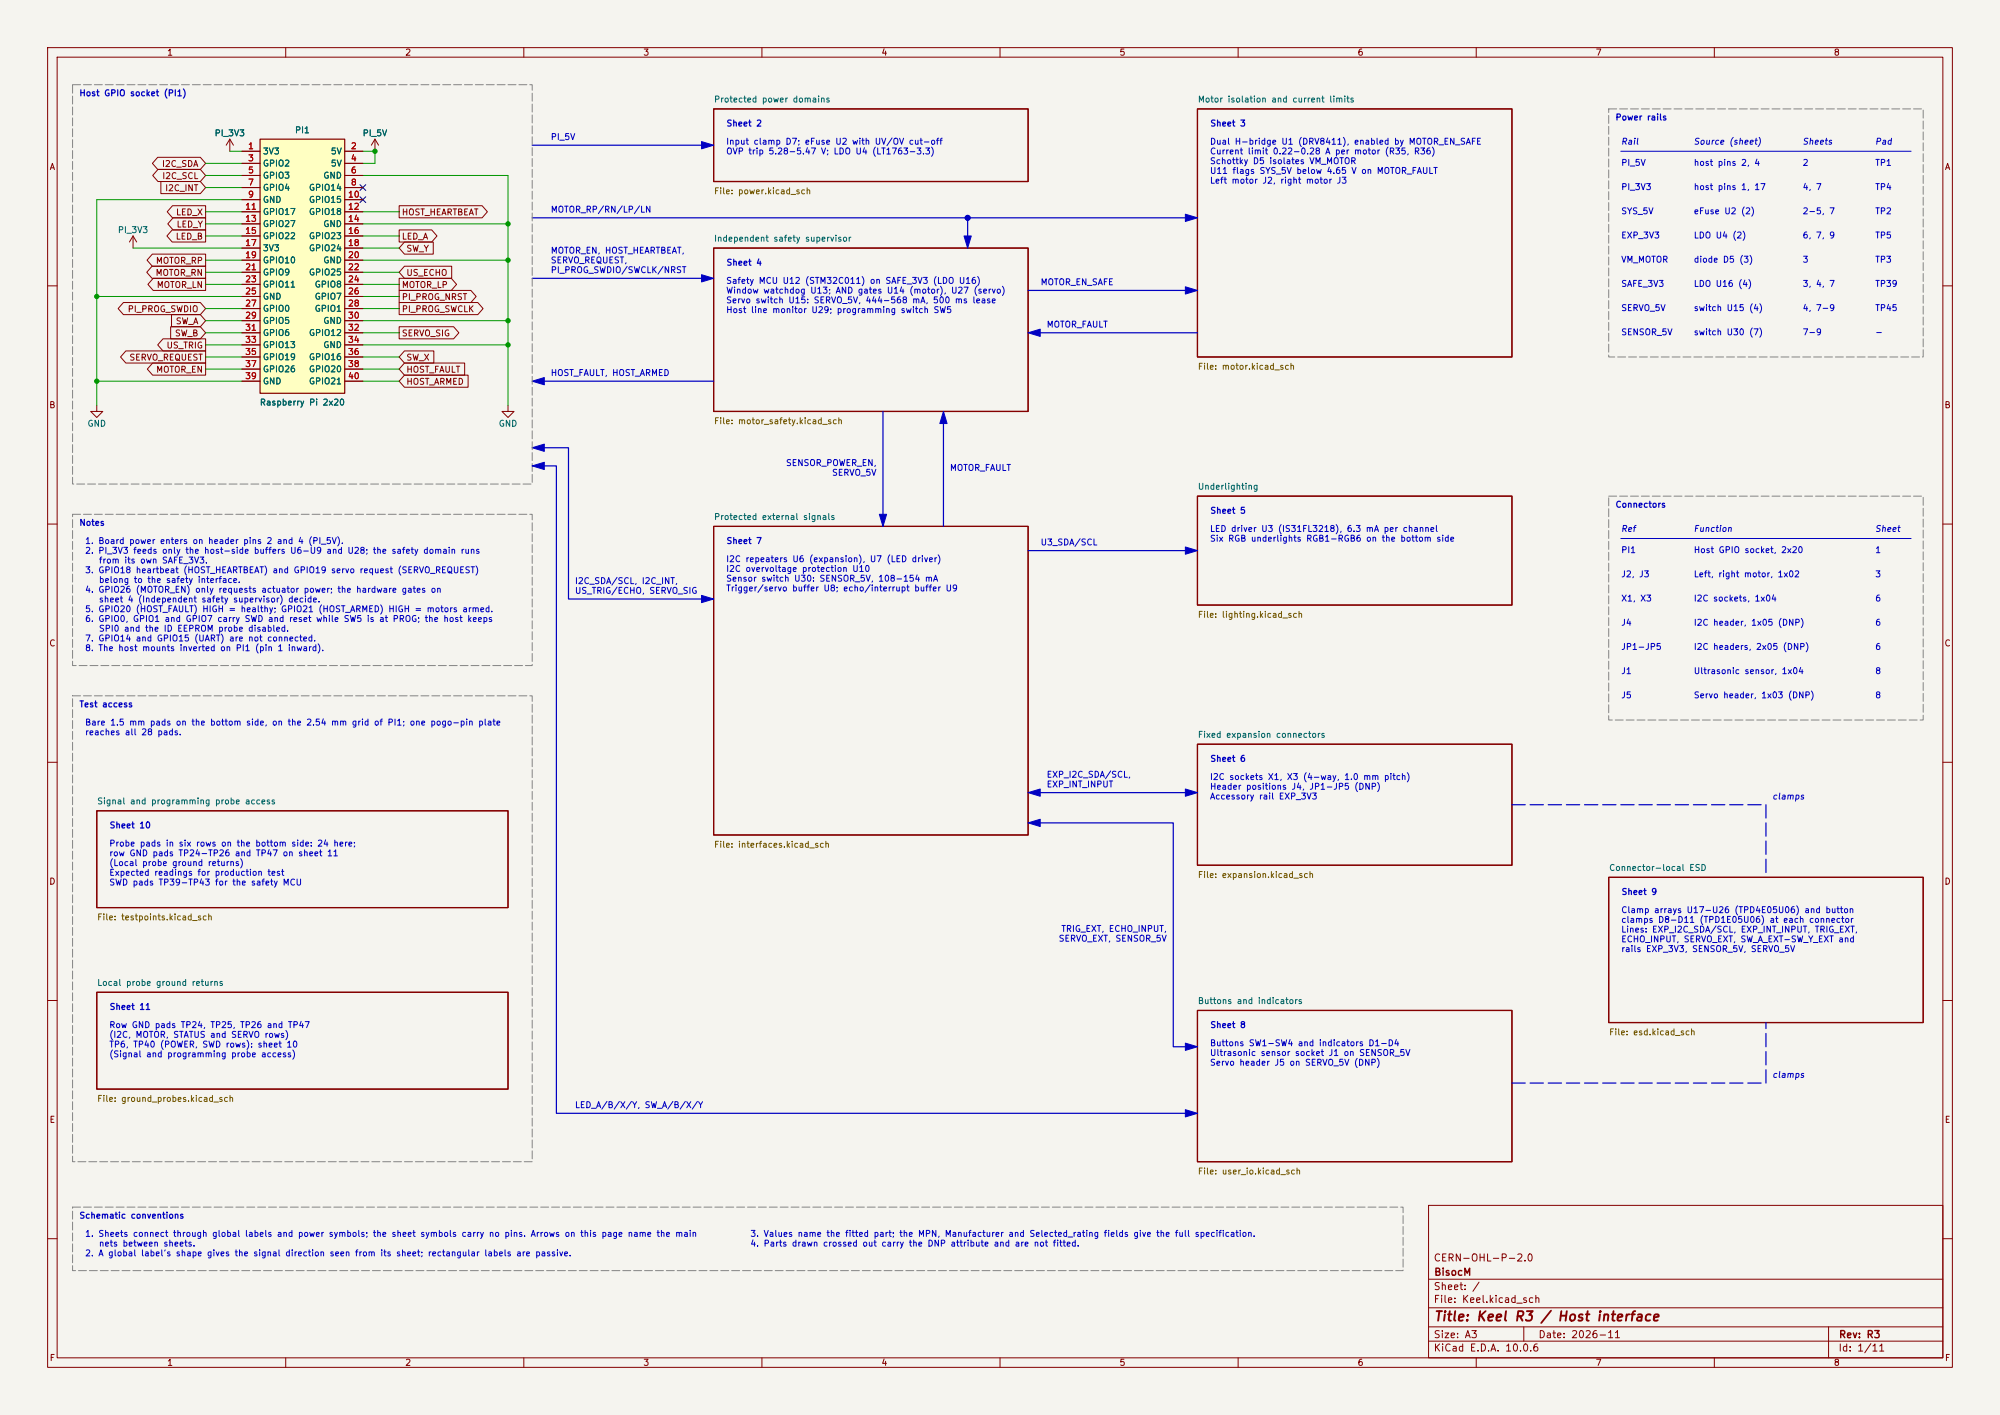
[picture p54: page 1]

Protected power domains File: power.kicad_sch Protected external signals File: interfaces.kicad_sch

Motor isolation and current limits File: motor.kicad_sch

PI_5V MOTOR_RP/RN/LP/LN
Input clamp D7; eFuse U2 with UV/OV cut-off OVP trip 5.28-5.47 V; LDO U4 (LT1763-3.3) Sheet 4 MOTOR_EN, HOST_HEARTBEAT,

Schottky D5 isolates VM_MOTOR U11 flags SYS_5V below 4.65 V on MOTOR_FAULT Left motor J2, right motor J3

Independent safety supervisor File: motor_safety.kicad_sch

Sheet 5
LED driver U3 (IS31FL3218), 6.3 mA per channel Six RGB underlights RGB1-RGB6 on the bottom side
Fixed expansion connectors File: expansion.kicad_sch Buttons and indicators File: user_io.kicad_sch

US_TRIG/ECHO, SERVO_SIG Notes 1. Board power enters on header pins 2 and 4 (PI_5V). 2. PI_3V3 feeds only the host-side buffers U6-U9 and U28; the safety domain runs

Sheet 7
I2C repeaters U6 (expansion), U7 (LED driver)
I2C overvoltage protection U10
Sensor switch U30: SENSOR_5V, 108-154 mA
Trigger/servo buffer U8; echo/interrupt buffer U9

from its own SAFE_3V3. 3. GPIO18 heartbeat (HOST_HEARTBEAT) and GPIO19 servo request (SERVO_REQUEST)

belong to the safety interface. 4. GPIO26 (MOTOR_EN) only requests actuator power; the hardware gates on

sheet 4 (Independent safety supervisor) decide. 5. GPIO20 (HOST_FAULT) HIGH = healthy; GPIO21 (HOST_ARMED) HIGH = motors armed. 6. GPIO0, GPIO1 and GPIO7 carry SWD and reset while SW5 is at PROG; the host keeps SPI0 and the ID EEPROM probe disabled. 7. GPIO14 and GPIO15 (UART) are not connected. 8. The host mounts inverted on PI1 (pin 1 inward).

6 Clamp arrays U17-U26 (TPD4E05U06) and button

Test access Bare 1.5 mm pads on the bottom side, on the 2.54 mm grid of PI1; one pogo-pin plate

Sheet 6
I2C sockets X1, X3 (4-way, 1.0 mm pitch) Header positions J4, JP1-JP5 (DNP)

SERVO_EXT, SENSOR_5V Sheet 10 Probe pads in six rows on the bottom side: 24 here; row GND pads TP24-TP26 and TP47 on sheet 11

(Local probe ground returns)
Expected readings for production test SWD pads TP39-TP43 for the safety MCU

clamps D8-D11 (TPD1E05U06) at each connector Lines: EXP_I2C_SDA/SCL, EXP_INT_INPUT, TRIG_EXT,

Local probe ground returns File: ground_probes.kicad_sch

Sheet 11 Row GND pads TP24, TP25, TP26 and TP47

(I2C, MOTOR, STATUS and SERVO rows)
TP6, TP40 (POWER, SWD rows): sheet 10
(Signal and programming probe access) Schematic conventions 1. Sheets connect through global labels and power symbols; the sheet symbols carry no pins. Arrows on this page name the main

CERN-OHL-P-2.0
BisocM
Sheet: /
File: Keel.kicad_sch
Title: Keel R3 / Host interface

Size: A3 | Rev: R3 | F Date: 2026-11
KiCad E.D.A. 10.0.6 | Id: 1/11

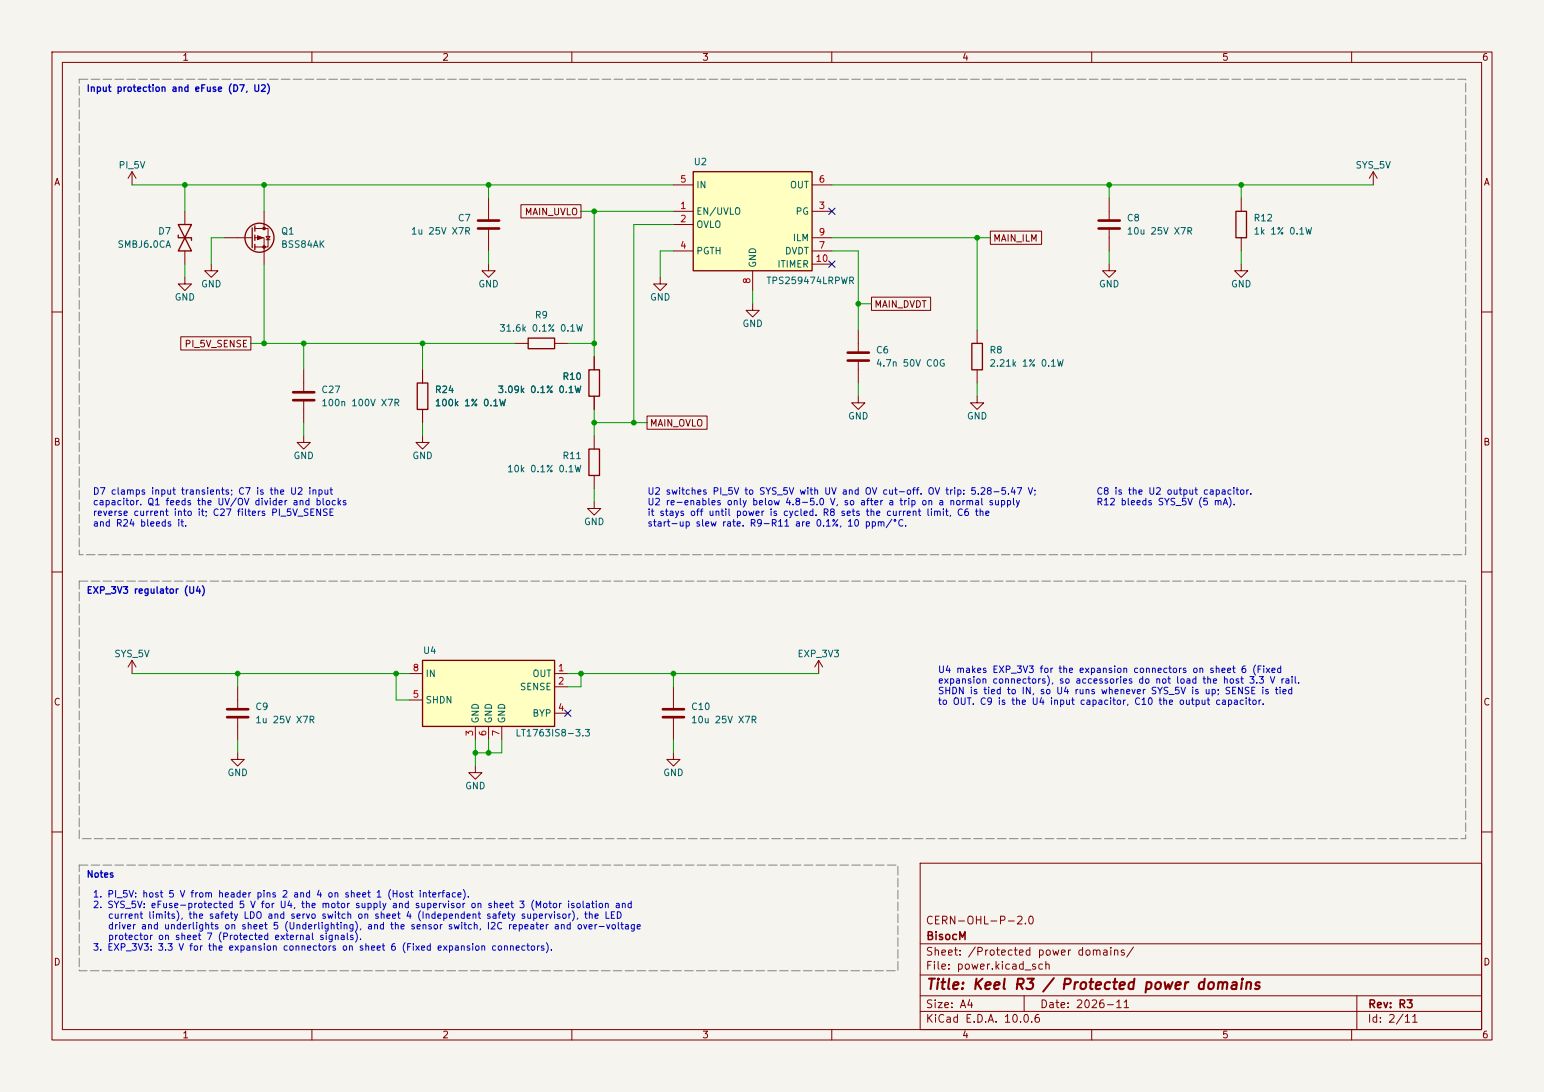
[picture p55: page 2]

Input protection and eFuse (D7, U2)

to OUT. C9 is the U4 input capacitor, C10 the output capacitor. C8 is the U2 output capacitor. R12 bleeds SYS_5V (5 mA). R24

capacitor. Q1 feeds the UV/OV divider and blocks
reverse current into it; C27 filters PI_5V_SENSE
and R24 bleeds it. 1. PI_5V: host 5 V from header pins 2 and 4 on sheet 1 (Host interface). 2. SYS_5V: eFuse-protected 5 V for U4, the motor supply and supervisor on sheet 3 (Motor isolation and

start-up slew rate. R9-R11 are 0.1%, 10 ppm/°C. D7 clamps input transients; C7 is the U2 input

it stays off until power is cycled. R8 sets the current limit, C6 the

expansion connectors), so accessories do not load the host 3.3 V rail. SHDN is tied to IN, so U4 runs whenever SYS_5V is up; SENSE is tied

current limits), the safety LDO and servo switch on sheet 4 (Independent safety supervisor), the LED
driver and underlights on sheet 5 (Underlighting), and the sensor switch, I2C repeater and over-voltage

CERN-OHL-P-2.0
BisocM
Sheet: /Protected power domains/
File: power.kicad_sch
Title: Keel R3 / Protected power domains

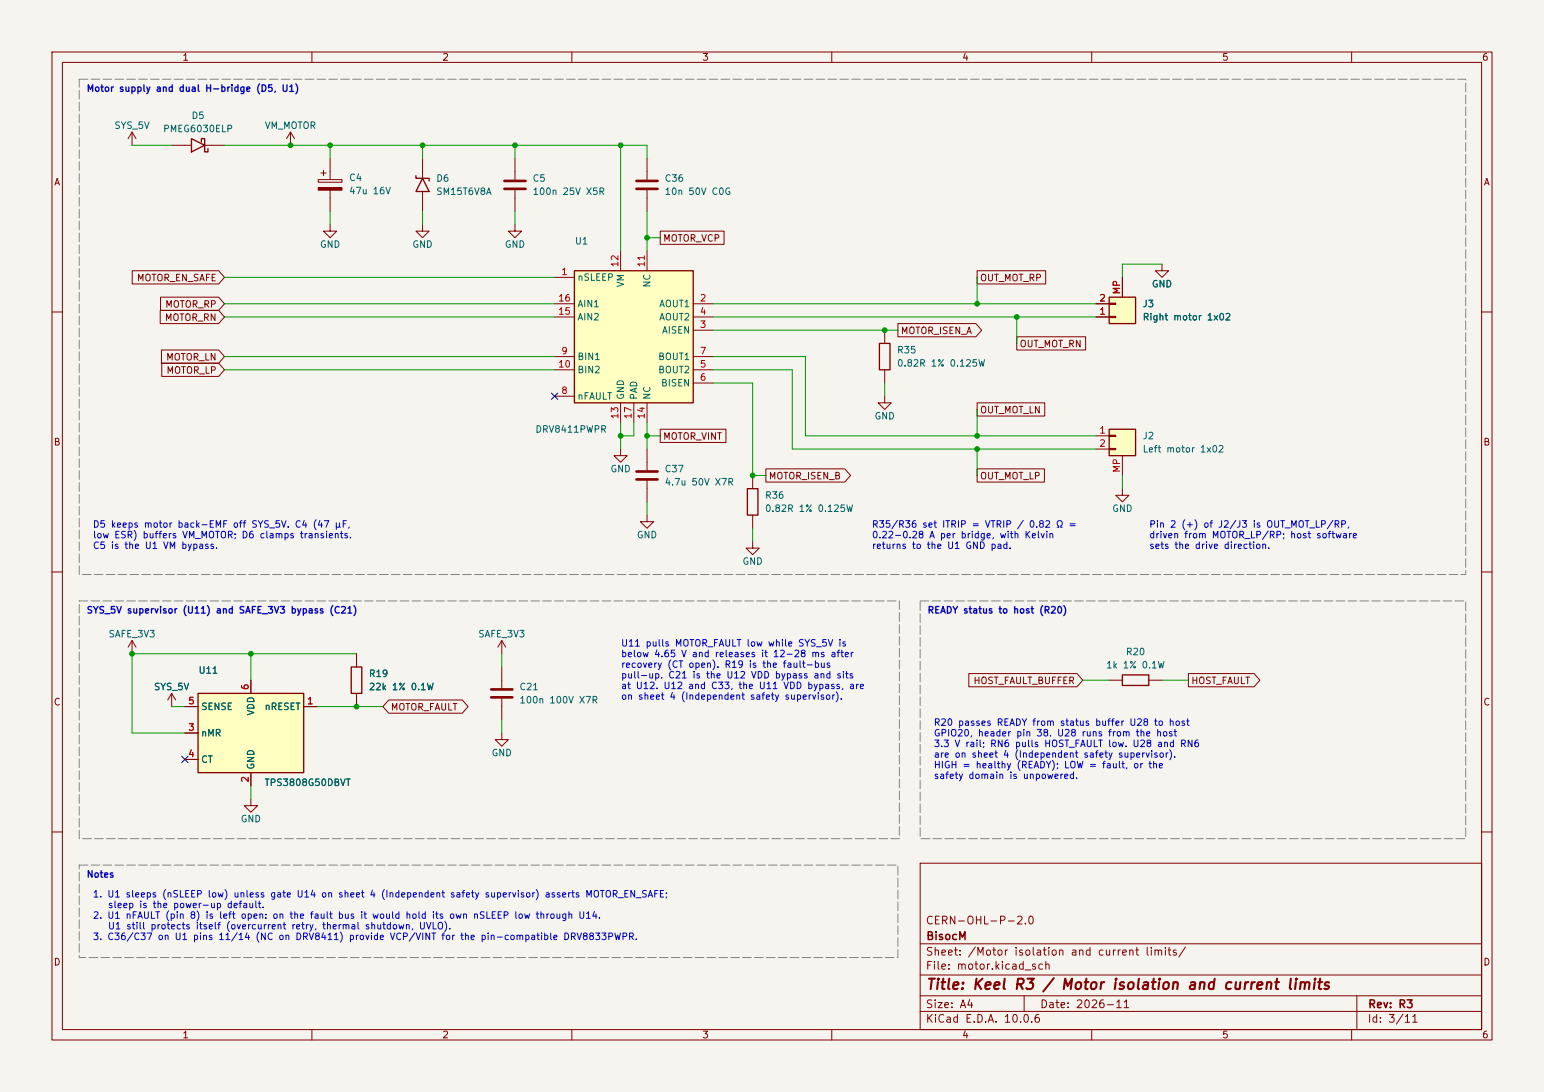
[picture p56: page 3]

sets the drive direction. R35/R36 set ITRIP = VTRIP / 0.82 Ω =
0.22-0.28 A per bridge, with Kelvin

safety domain is unpowered. U11 pulls MOTOR_FAULT low while SYS_5V is below 4.65 V and releases it 12-28 ms after

are on sheet 4 (Independent safety supervisor). HIGH = healthy (READY); LOW = fault, or the

CERN-OHL-P-2.0
BisocM
Sheet: /Motor isolation and current limits/
File: motor.kicad_sch
Title: Keel R3 / Motor isolation and current limits

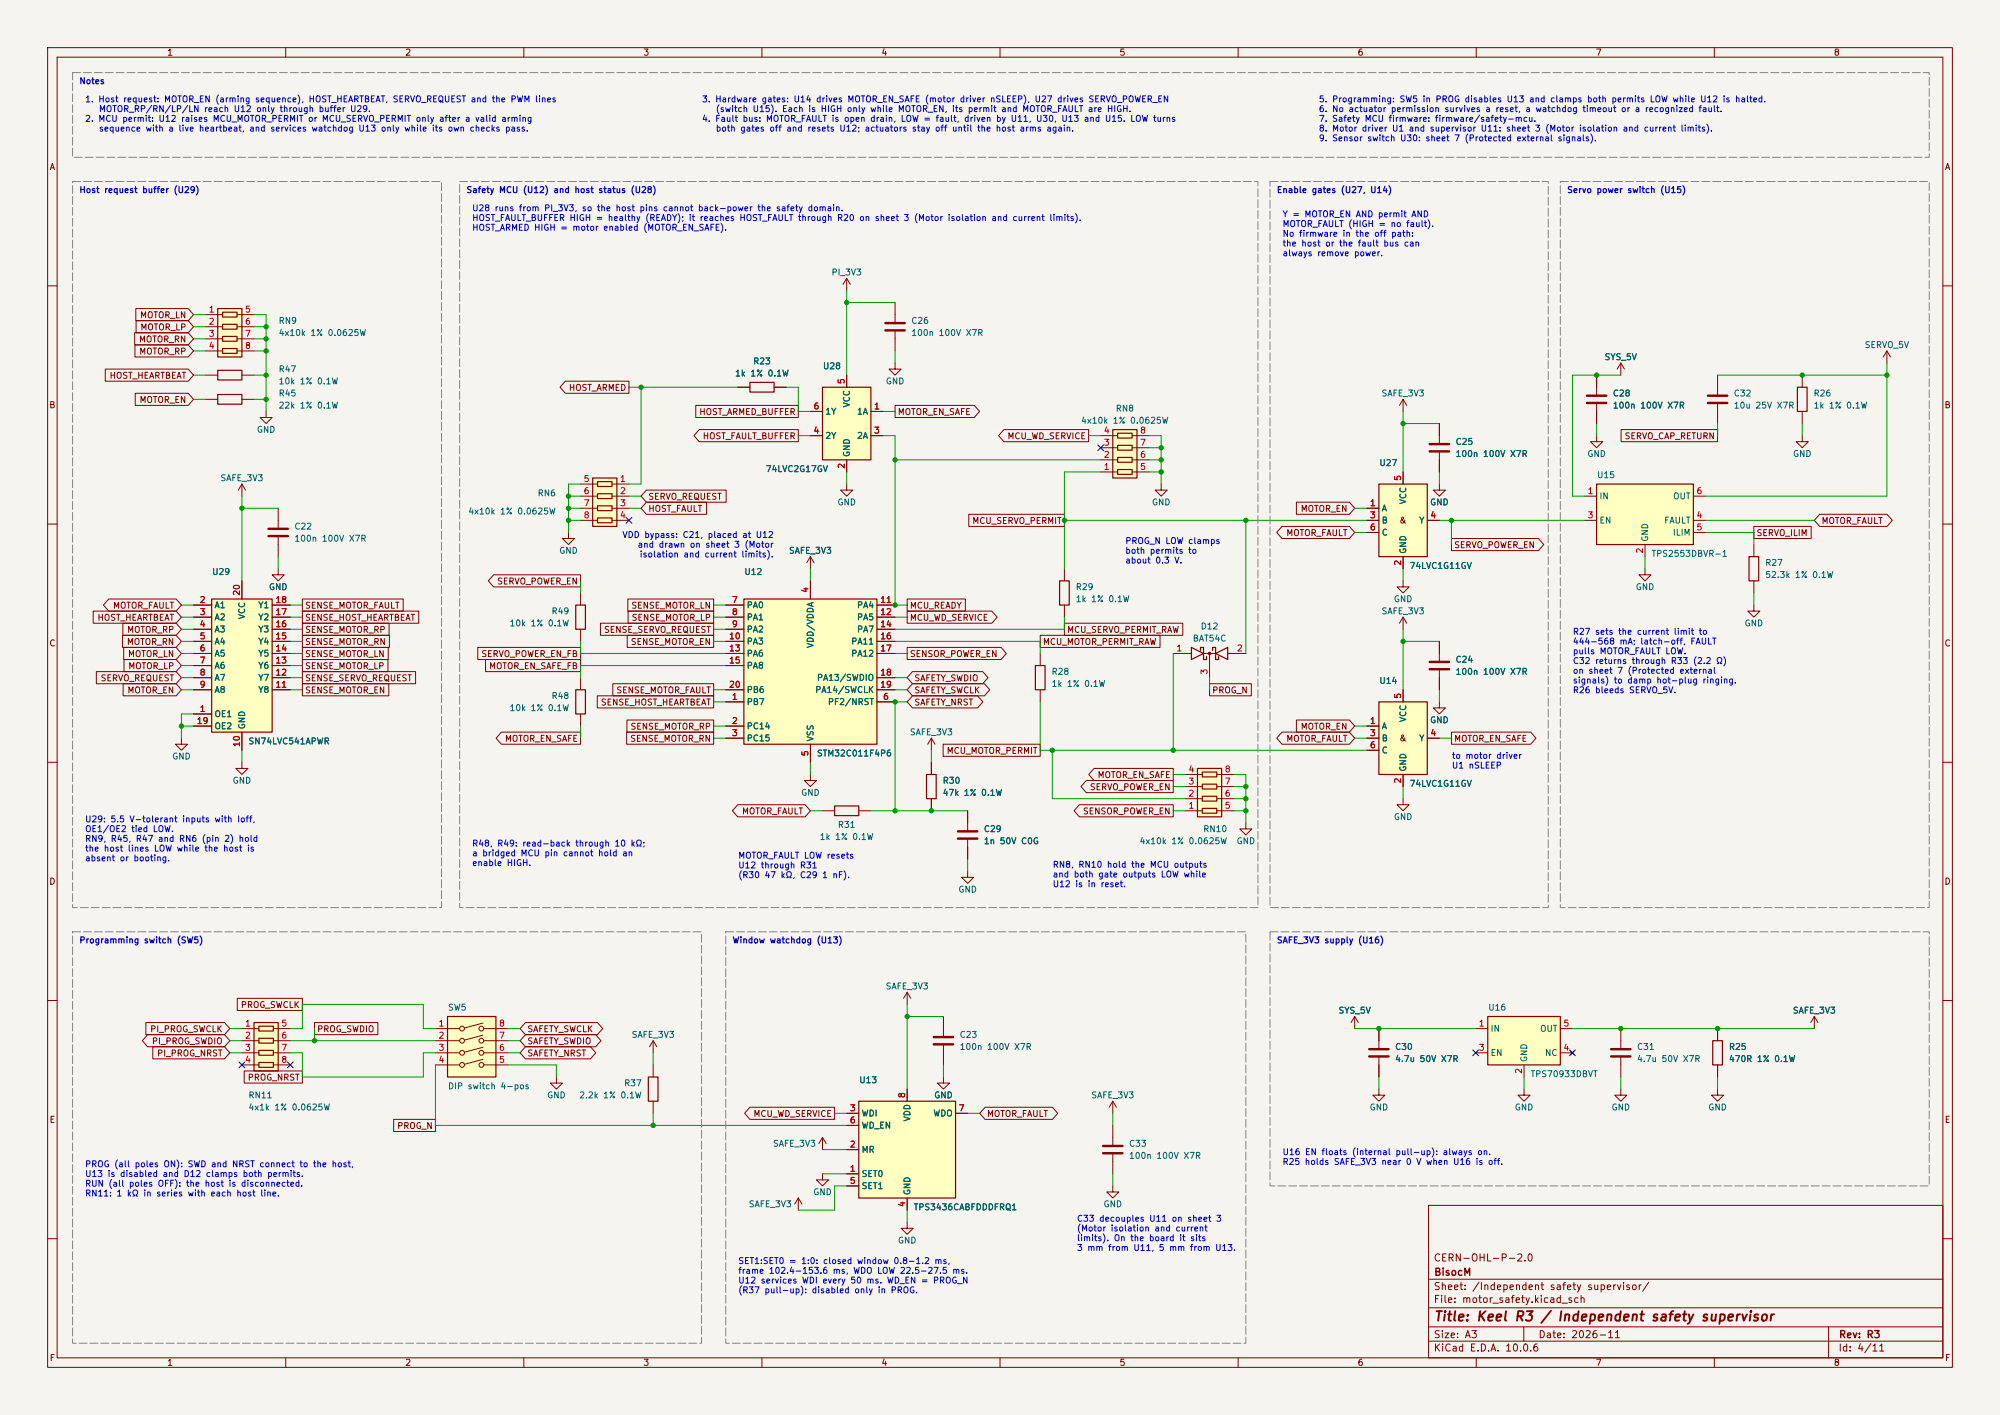
[picture p57: page 4]

sequence with a live heartbeat, and services watchdog U13 only while its own checks pass. Notes

Safety MCU (U12) and host status (U28) 1. Host request: MOTOR_EN (arming sequence), HOST_HEARTBEAT, SERVO_REQUEST and the PWM lines MOTOR_RP/RN/LP/LN reach U12 only through buffer U29. 2. MCU permit: U12 raises MCU_MOTOR_PERMIT or MCU_SERVO_PERMIT only after a valid arming

Servo power switch (U15) 5. Programming: SW5 in PROG disables U13 and clamps both permits LOW while U12 is halted. 6. No actuator permission survives a reset, a watchdog timeout or a recognized fault. 7. Safety MCU firmware: firmware/safety-mcu. 8. Motor driver U1 and supervisor U11: sheet 3 (Motor isolation and current limits). 9. Sensor switch U30: sheet 7 (Protected external signals). Y = MOTOR_EN AND permit AND MOTOR_FAULT (HIGH = no fault). No firmware in the off path: the host or the fault bus can

(switch U15). Each is HIGH only while MOTOR_EN, its permit and MOTOR_FAULT are HIGH. 4. Fault bus: MOTOR_FAULT is open drain, LOW = fault, driven by U11, U30, U13 and U15. LOW turns both gates off and resets U12; actuators stay off until the host arms again.

always remove power. Enable gates (U27, U14)

VDD bypass: C21, placed at U12
and drawn on sheet 3 (Motor

about 0.3 V. Window watchdog (U13) U29: 5.5 V-tolerant inputs with Ioff,

to motor driver U1 nSLEEP

OE1/OE2 tied LOW. RN9, R45, R47 and RN6 (pin 2) hold

R48, R49: read-back through 10 kΩ; a bridged MCU pin cannot hold an

C33 decouples U11 on sheet 3
(Motor isolation and current

limits). On the board it sits 3 mm from U11, 5 mm from U13. SET1:SET0 = 1:0: closed window 0.8-1.2 ms, frame 102.4-153.6 ms, WDO LOW 22.5-27.5 ms. U12 services WDI every 50 ms. WD_EN = PROG_N

CERN-OHL-P-2.0
BisocM
Sheet: /Independent safety supervisor/
File: motor_safety.kicad_sch
Title: Keel R3 / Independent safety supervisor

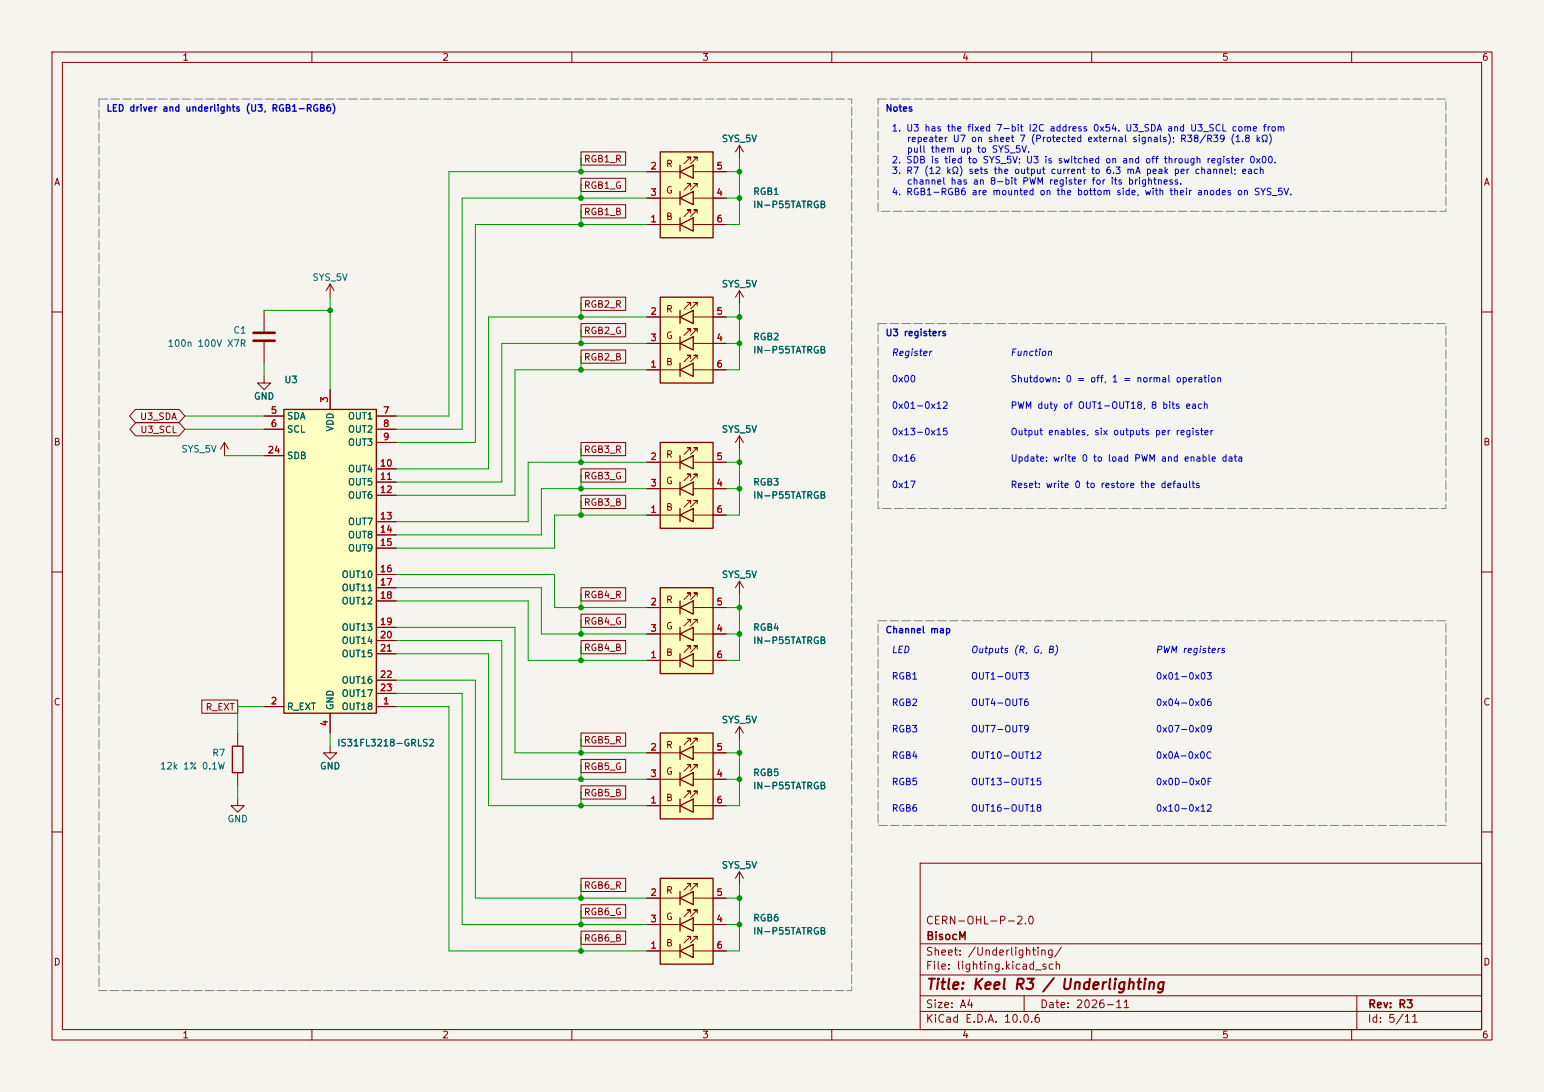
[picture p58: page 5]

LED driver and underlights (U3, RGB1-RGB6)

repeater U7 on sheet 7 (Protected external signals); R38/R39 (1.8 kΩ)
pull them up to SYS_5V. 2. SDB is tied to SYS_5V: U3 is switched on and off through register 0x00. 3. R7 (12 kΩ) sets the output current to 6.3 mA peak per channel; each

channel has an 8-bit PWM register for its brightness. 4. RGB1-RGB6 are mounted on the bottom side, with their anodes on SYS_5V. OUT10-OUT12 U3

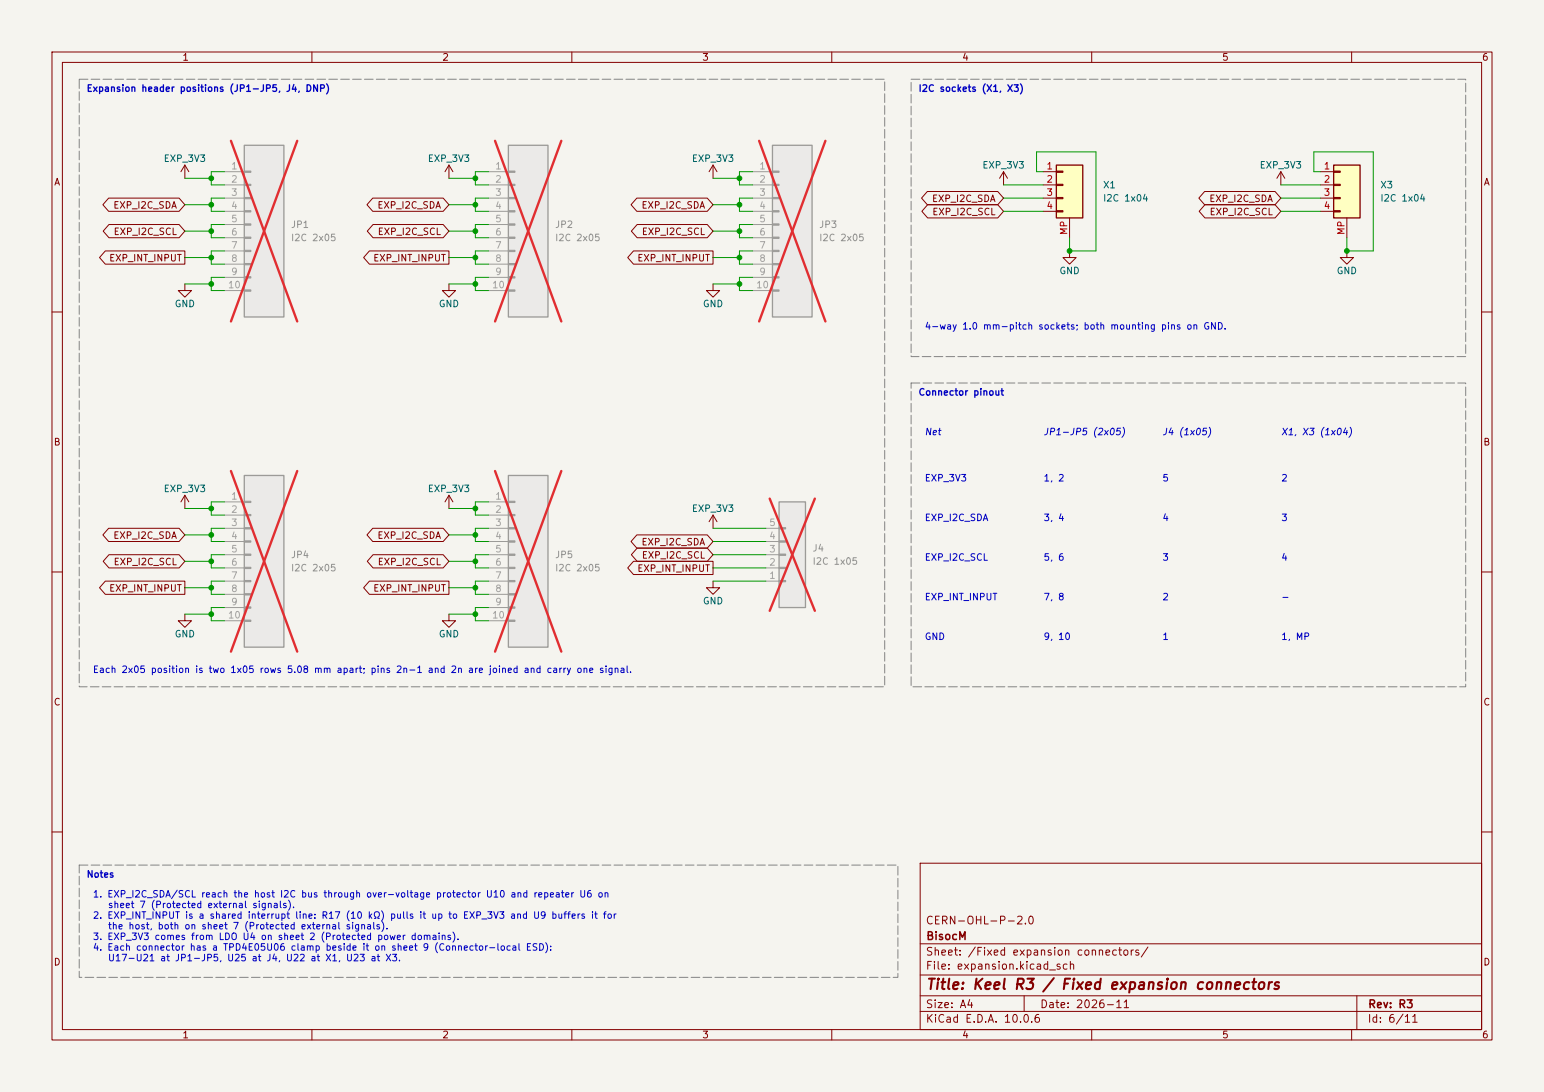
[picture p59: page 6]

4-way 1.0 mm-pitch sockets; both mounting pins on GND. Expansion header positions (JP1-JP5, J4, DNP)
EXP_3V3 GND

1. EXP_I2C_SDA/SCL reach the host I2C bus through over-voltage protector U10 and repeater U6 on
sheet 7 (Protected external signals). 2. EXP_INT_INPUT is a shared interrupt line: R17 (10 kΩ) pulls it up to EXP_3V3 and U9 buffers it for

CERN-OHL-P-2.0
BisocM
Sheet: /Fixed expansion connectors/
File: expansion.kicad_sch
Title: Keel R3 / Fixed expansion connectors

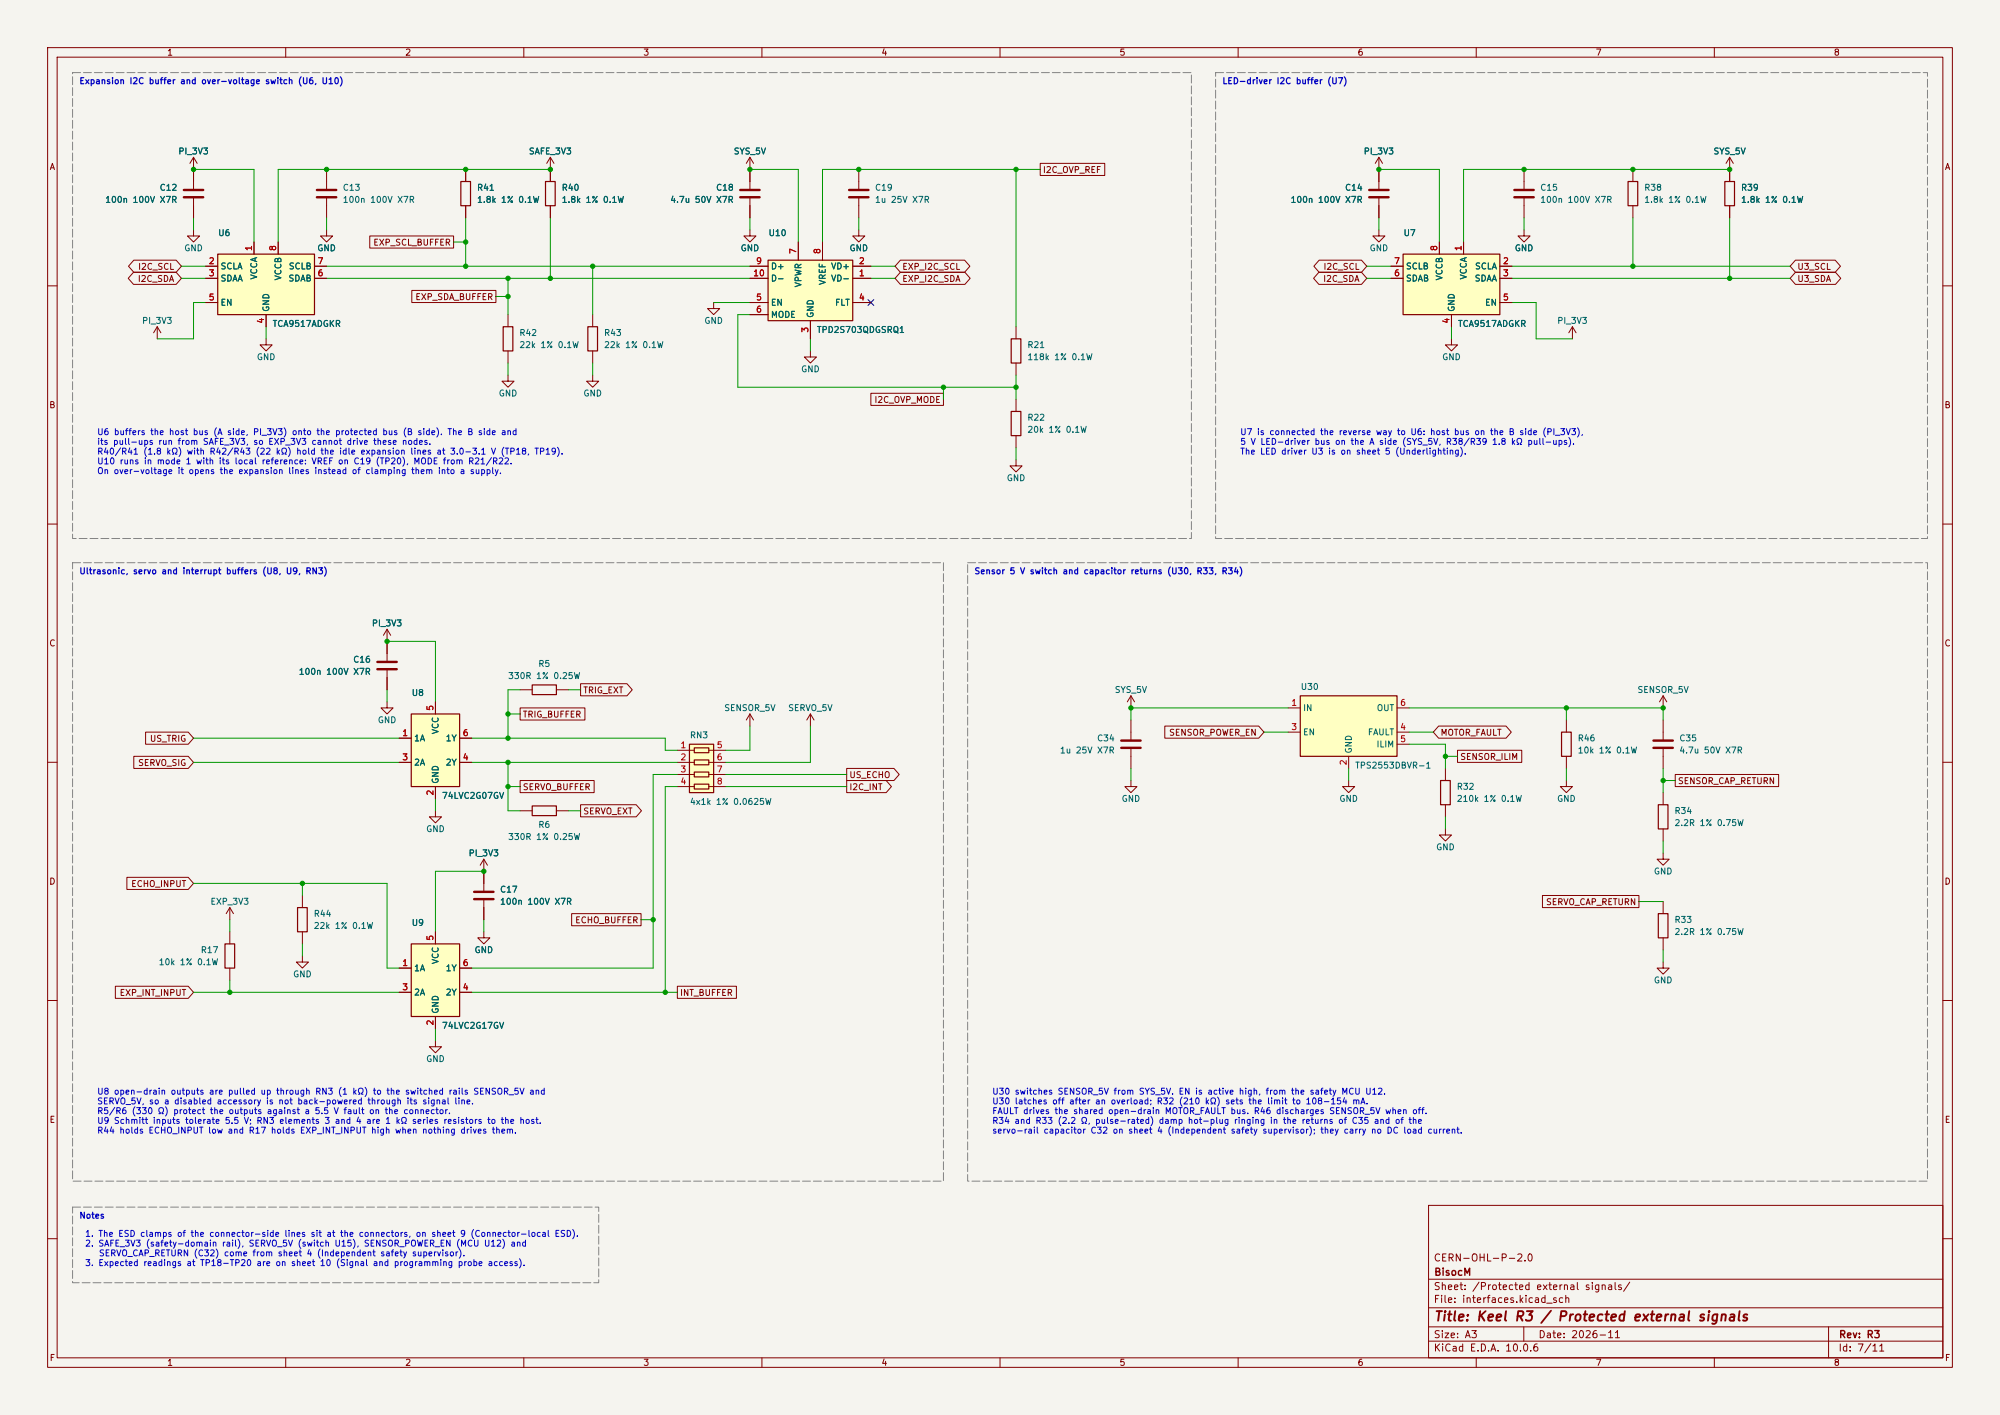
[picture p60: page 7]

Ultrasonic, servo and interrupt buffers (U8, U9, RN3) U6 buffers the host bus (A side, PI_3V3) onto the protected bus (B side). The B side and

servo-rail capacitor C32 on sheet 4 (Independent safety supervisor); they carry no DC load current. U8 open-drain outputs are pulled up through RN3 (1 kΩ) to the switched rails SENSOR_5V and SERVO_5V, so a disabled accessory is not back-powered through its signal line. R5/R6 (330 Ω) protect the outputs against a 5.5 V fault on the connector. U9 Schmitt inputs tolerate 5.5 V; RN3 elements 3 and 4 are 1 kΩ series resistors to the host. R44 holds ECHO_INPUT low and R17 holds EXP_INT_INPUT high when nothing drives them. Notes 1. The ESD clamps of the connector-side lines sit at the connectors, on sheet 9 (Connector-local ESD). 2. SAFE_3V3 (safety-domain rail), SERVO_5V (switch U15), SENSOR_POWER_EN (MCU U12) and SERVO_CAP_RETURN (C32) come from sheet 4 (Independent safety supervisor). 3. Expected readings at TP18-TP20 are on sheet 10 (Signal and programming probe access).

CERN-OHL-P-2.0
BisocM
Sheet: /Protected external signals/
File: interfaces.kicad_sch
Title: Keel R3 / Protected external signals

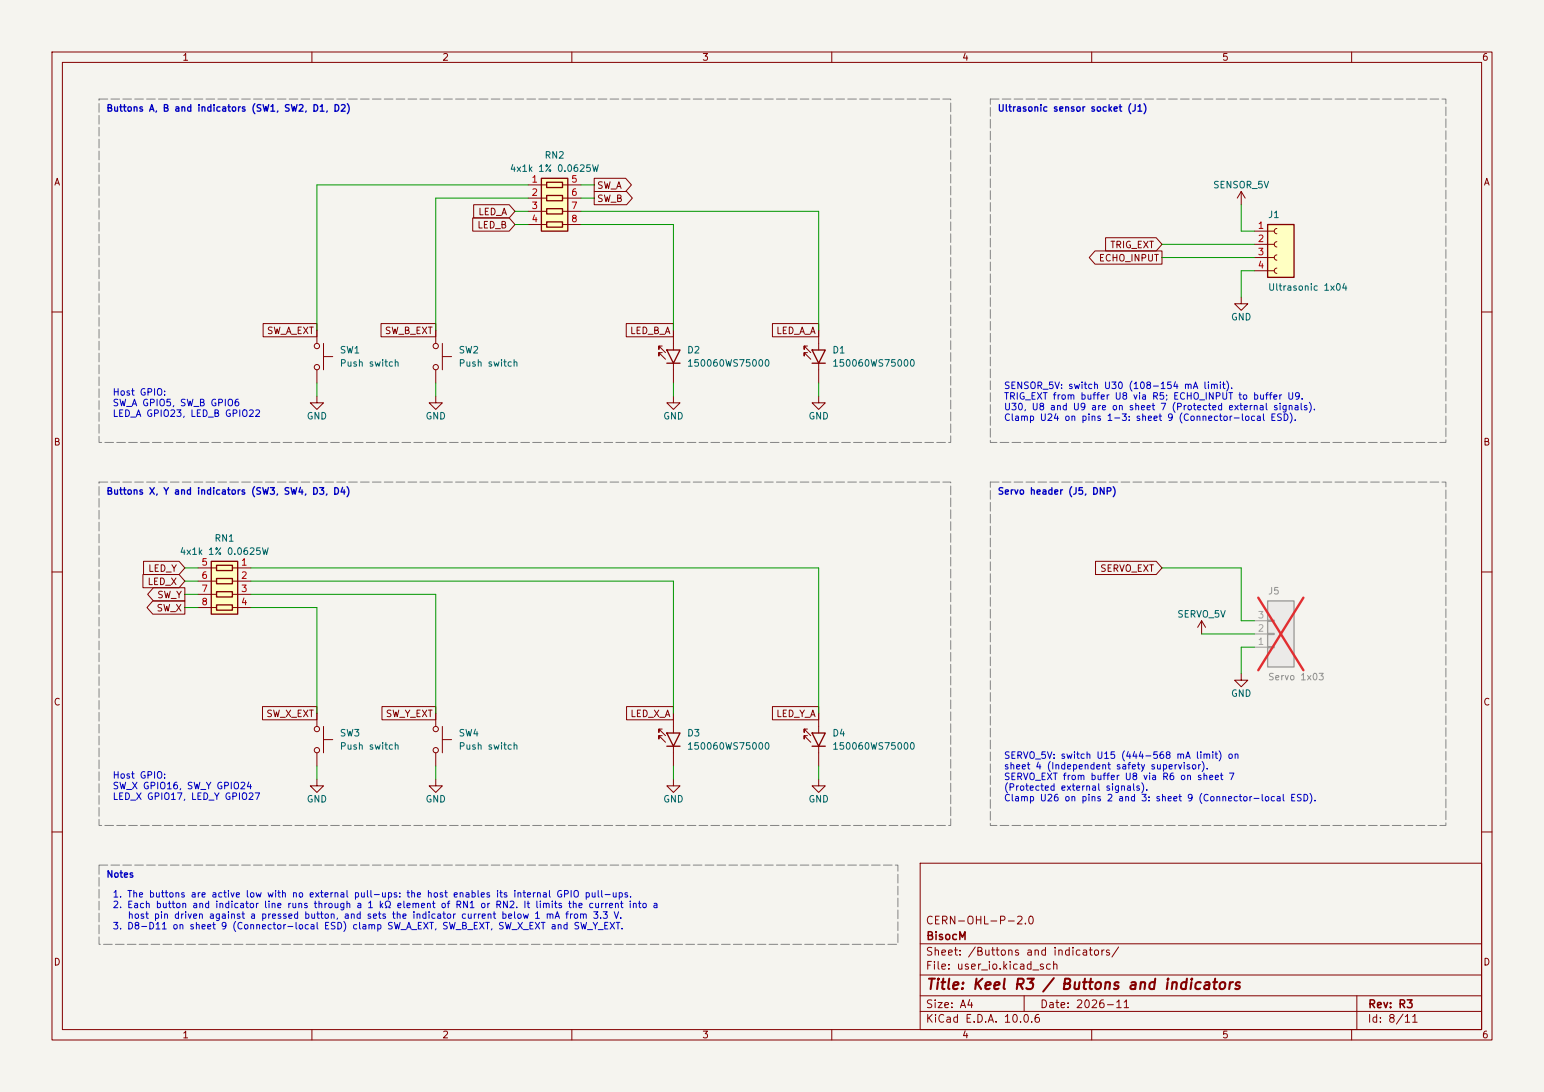
[picture p61: page 8]

LED_X GPIO17, LED_Y GPIO27 Buttons X, Y and indicators (SW3, SW4, D3, D4) Buttons A, B and indicators (SW1, SW2, D1, D2) Host GPIO: SW_A GPIO5, SW_B GPIO6

Ultrasonic sensor socket (J1) Host GPIO: SW_X GPIO16, SW_Y GPIO24

Clamp U26 on pins 2 and 3: sheet 9 (Connector-local ESD). SENSOR_5V: switch U30 (108-154 mA limit). TRIG_EXT from buffer U8 via R5; ECHO_INPUT to buffer U9. U30, U8 and U9 are on sheet 7 (Protected external signals).

LED_A GPIO23, LED_B GPIO22
Clamp U24 on pins 1-3: sheet 9 (Connector-local ESD). 1. The buttons are active low with no external pull-ups: the host enables its internal GPIO pull-ups. 2. Each button and indicator line runs through a 1 kΩ element of RN1 or RN2. It limits the current into a

Servo header (J5, DNP) SERVO_5V: switch U15 (444-568 mA limit) on

sheet 4 (Independent safety supervisor). SERVO_EXT from buffer U8 via R6 on sheet 7

host pin driven against a pressed button, and sets the indicator current below 1 mA from 3.3 V. 3. D8-D11 on sheet 9 (Connector-local ESD) clamp SW_A_EXT, SW_B_EXT, SW_X_EXT and SW_Y_EXT.

CERN-OHL-P-2.0
BisocM
Sheet: /Buttons and indicators/
File: user_io.kicad_sch
Title: Keel R3 / Buttons and indicators

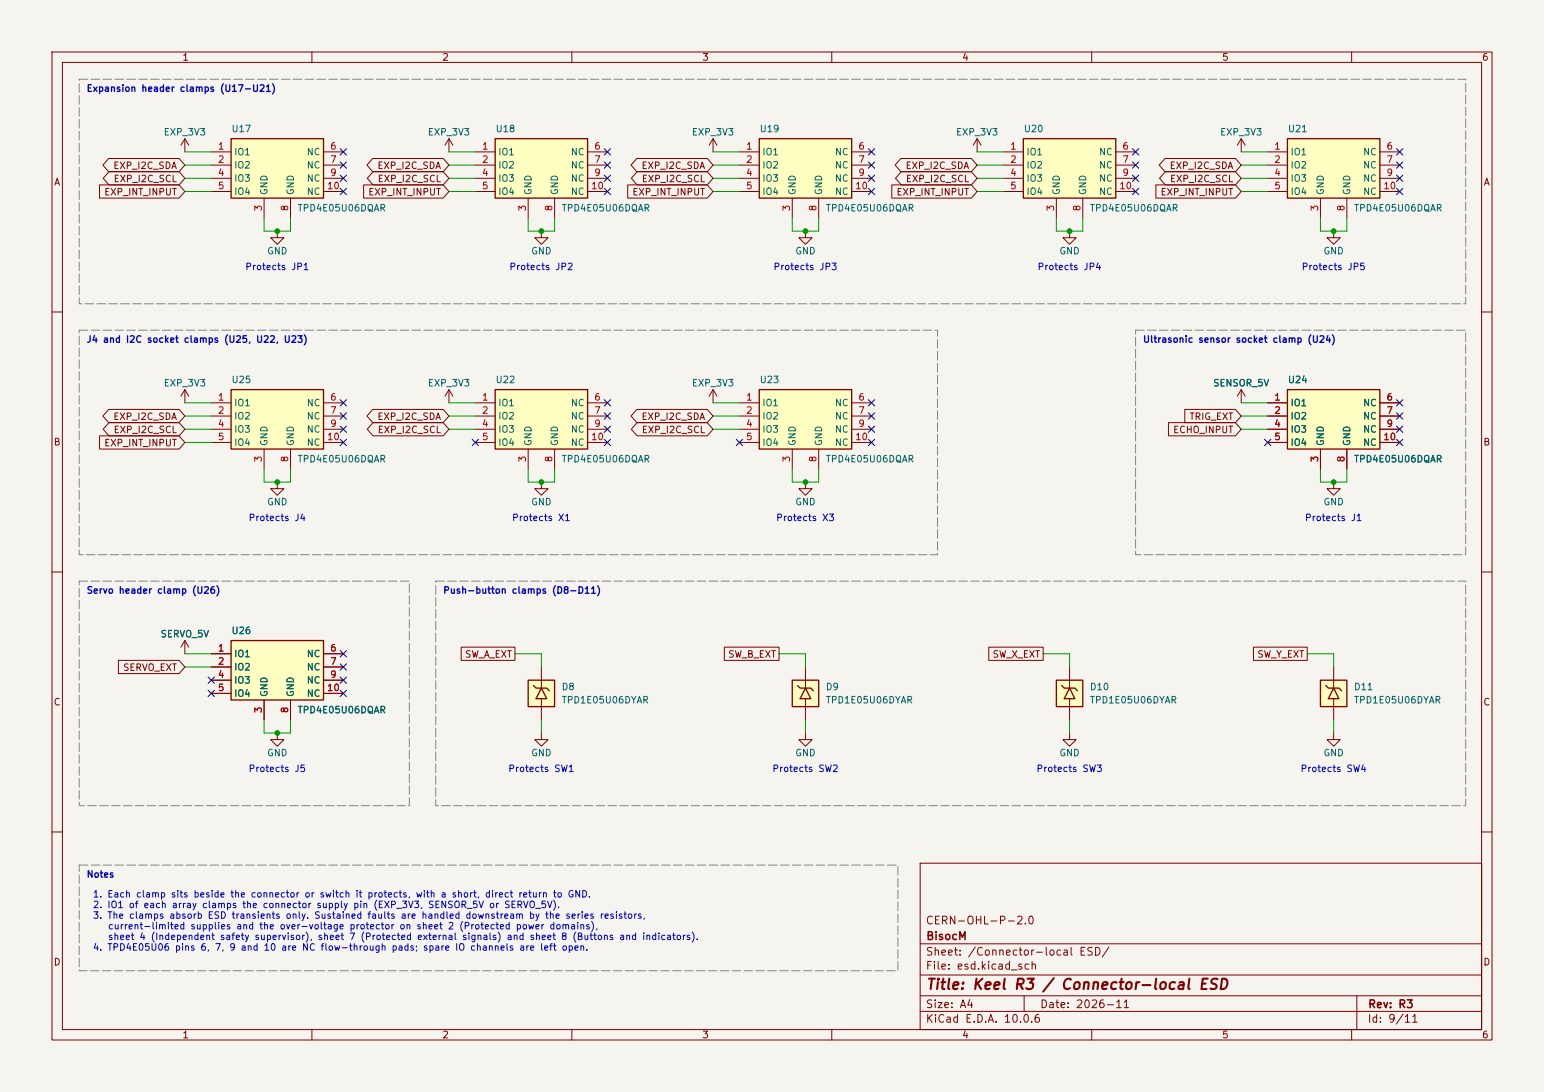
[picture p62: page 9]

1. Each clamp sits beside the connector or switch it protects, with a short, direct return to GND. 2. IO1 of each array clamps the connector supply pin (EXP_3V3, SENSOR_5V or SERVO_5V). 3. The clamps absorb ESD transients only. Sustained faults are handled downstream by the series resistors, current-limited supplies and the over-voltage protector on sheet 2 (Protected power domains), sheet 4 (Independent safety supervisor), sheet 7 (Protected external signals) and sheet 8 (Buttons and indicators). 4. TPD4E05U06 pins 6, 7, 9 and 10 are NC flow-through pads; spare IO channels are left open.

CERN-OHL-P-2.0
BisocM
Sheet: /Connector-local ESD/
File: esd.kicad_sch
Title: Keel R3 / Connector-local ESD

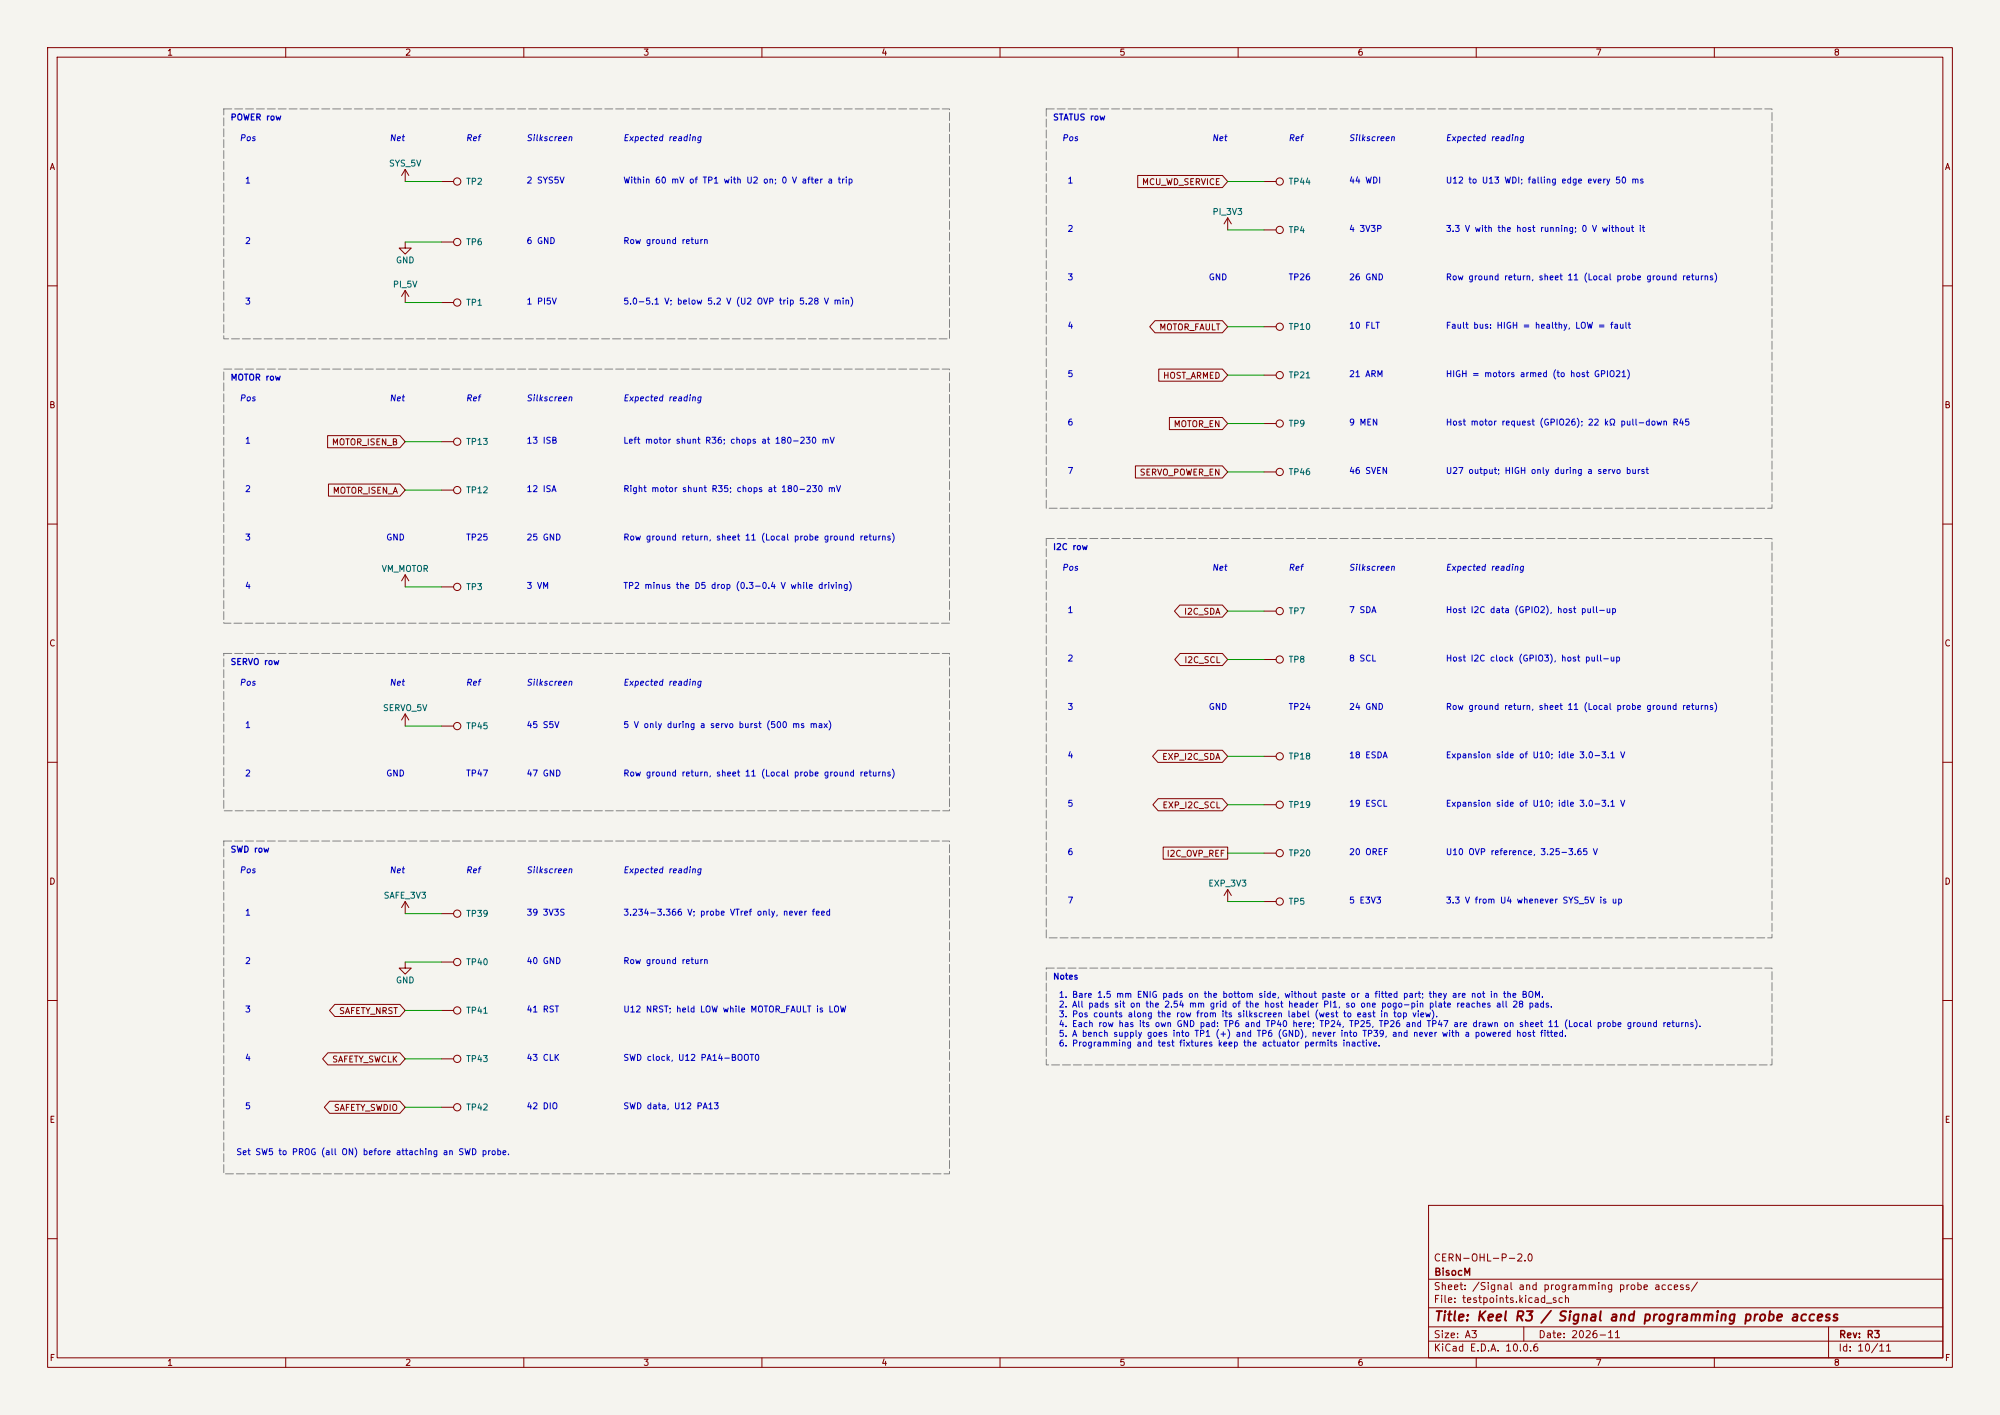
[picture p63: page 10]

SWD clock, U12 PA14-BOOT0 U12 NRST; held LOW while MOTOR_FAULT is LOW

Set SW5 to PROG (all ON) before attaching an SWD probe.

CERN-OHL-P-2.0
BisocM
Sheet: /Signal and programming probe access/
File: testpoints.kicad_sch
Title: Keel R3 / Signal and programming probe access

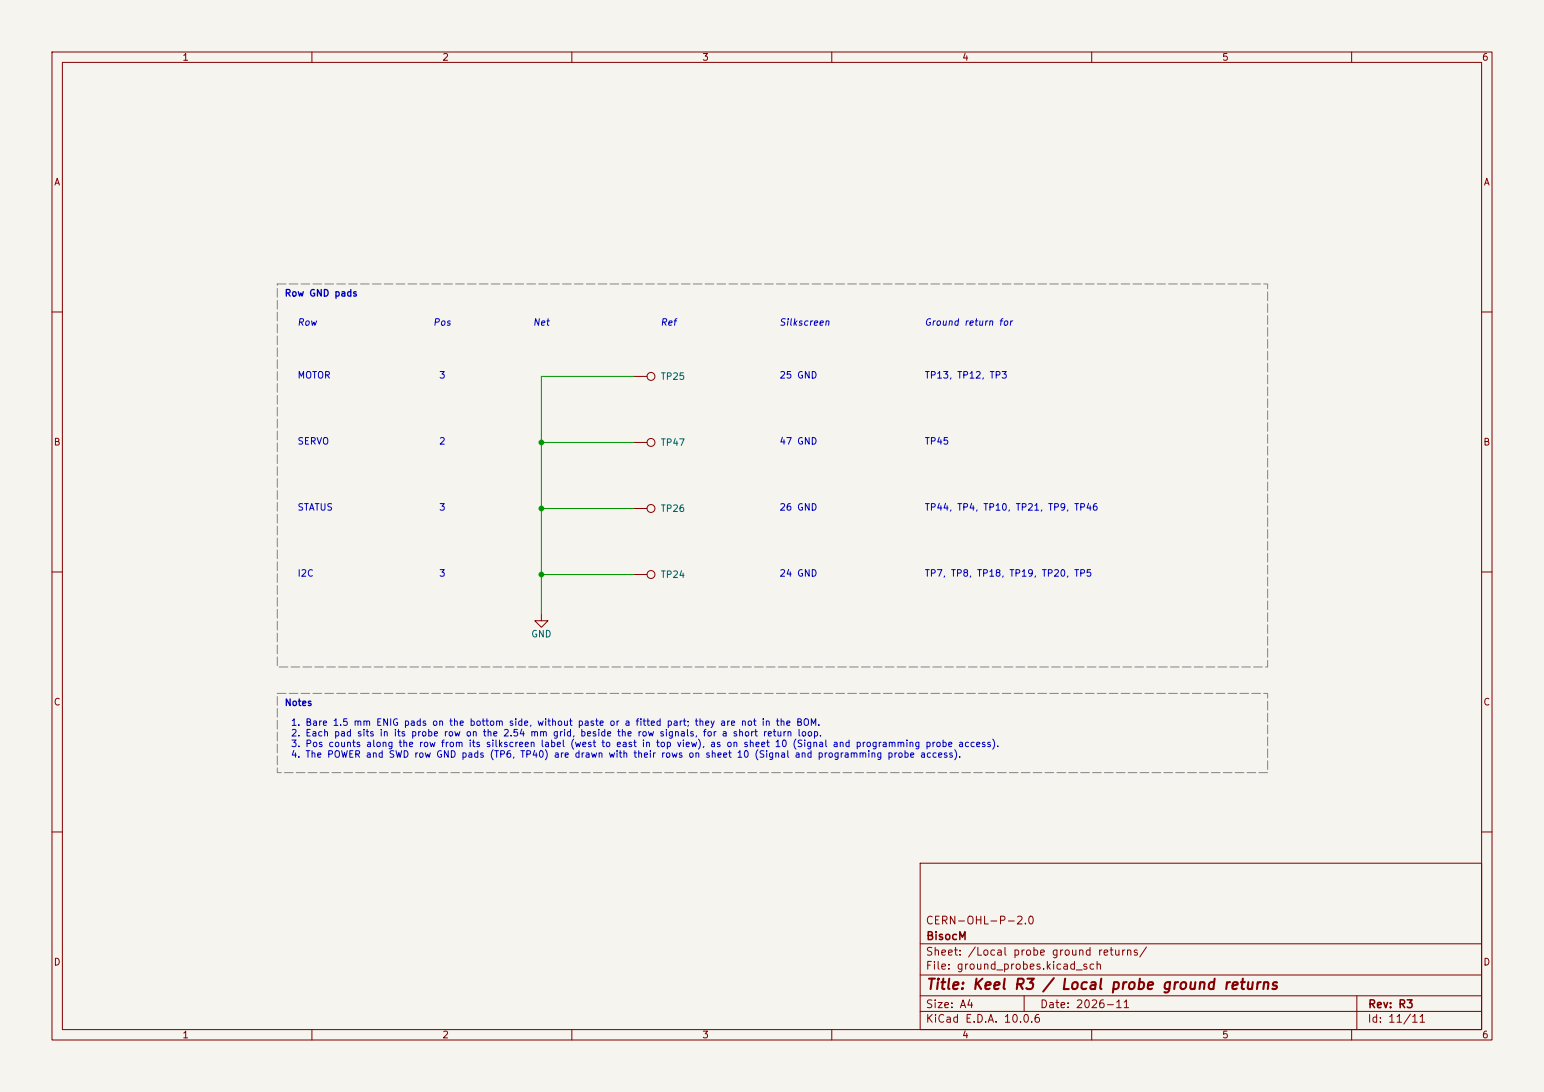
[picture p64: page 11]

CERN-OHL-P-2.0
BisocM
Sheet: /Local probe ground returns/
File: ground_probes.kicad_sch
Title: Keel R3 / Local probe ground returns
