BisocMOrg/Keel/hardware/kicad/Keel.kicad_pcb

## KiCad design hardware/kicad/Keel.kicad_pcb (2026-11-09)

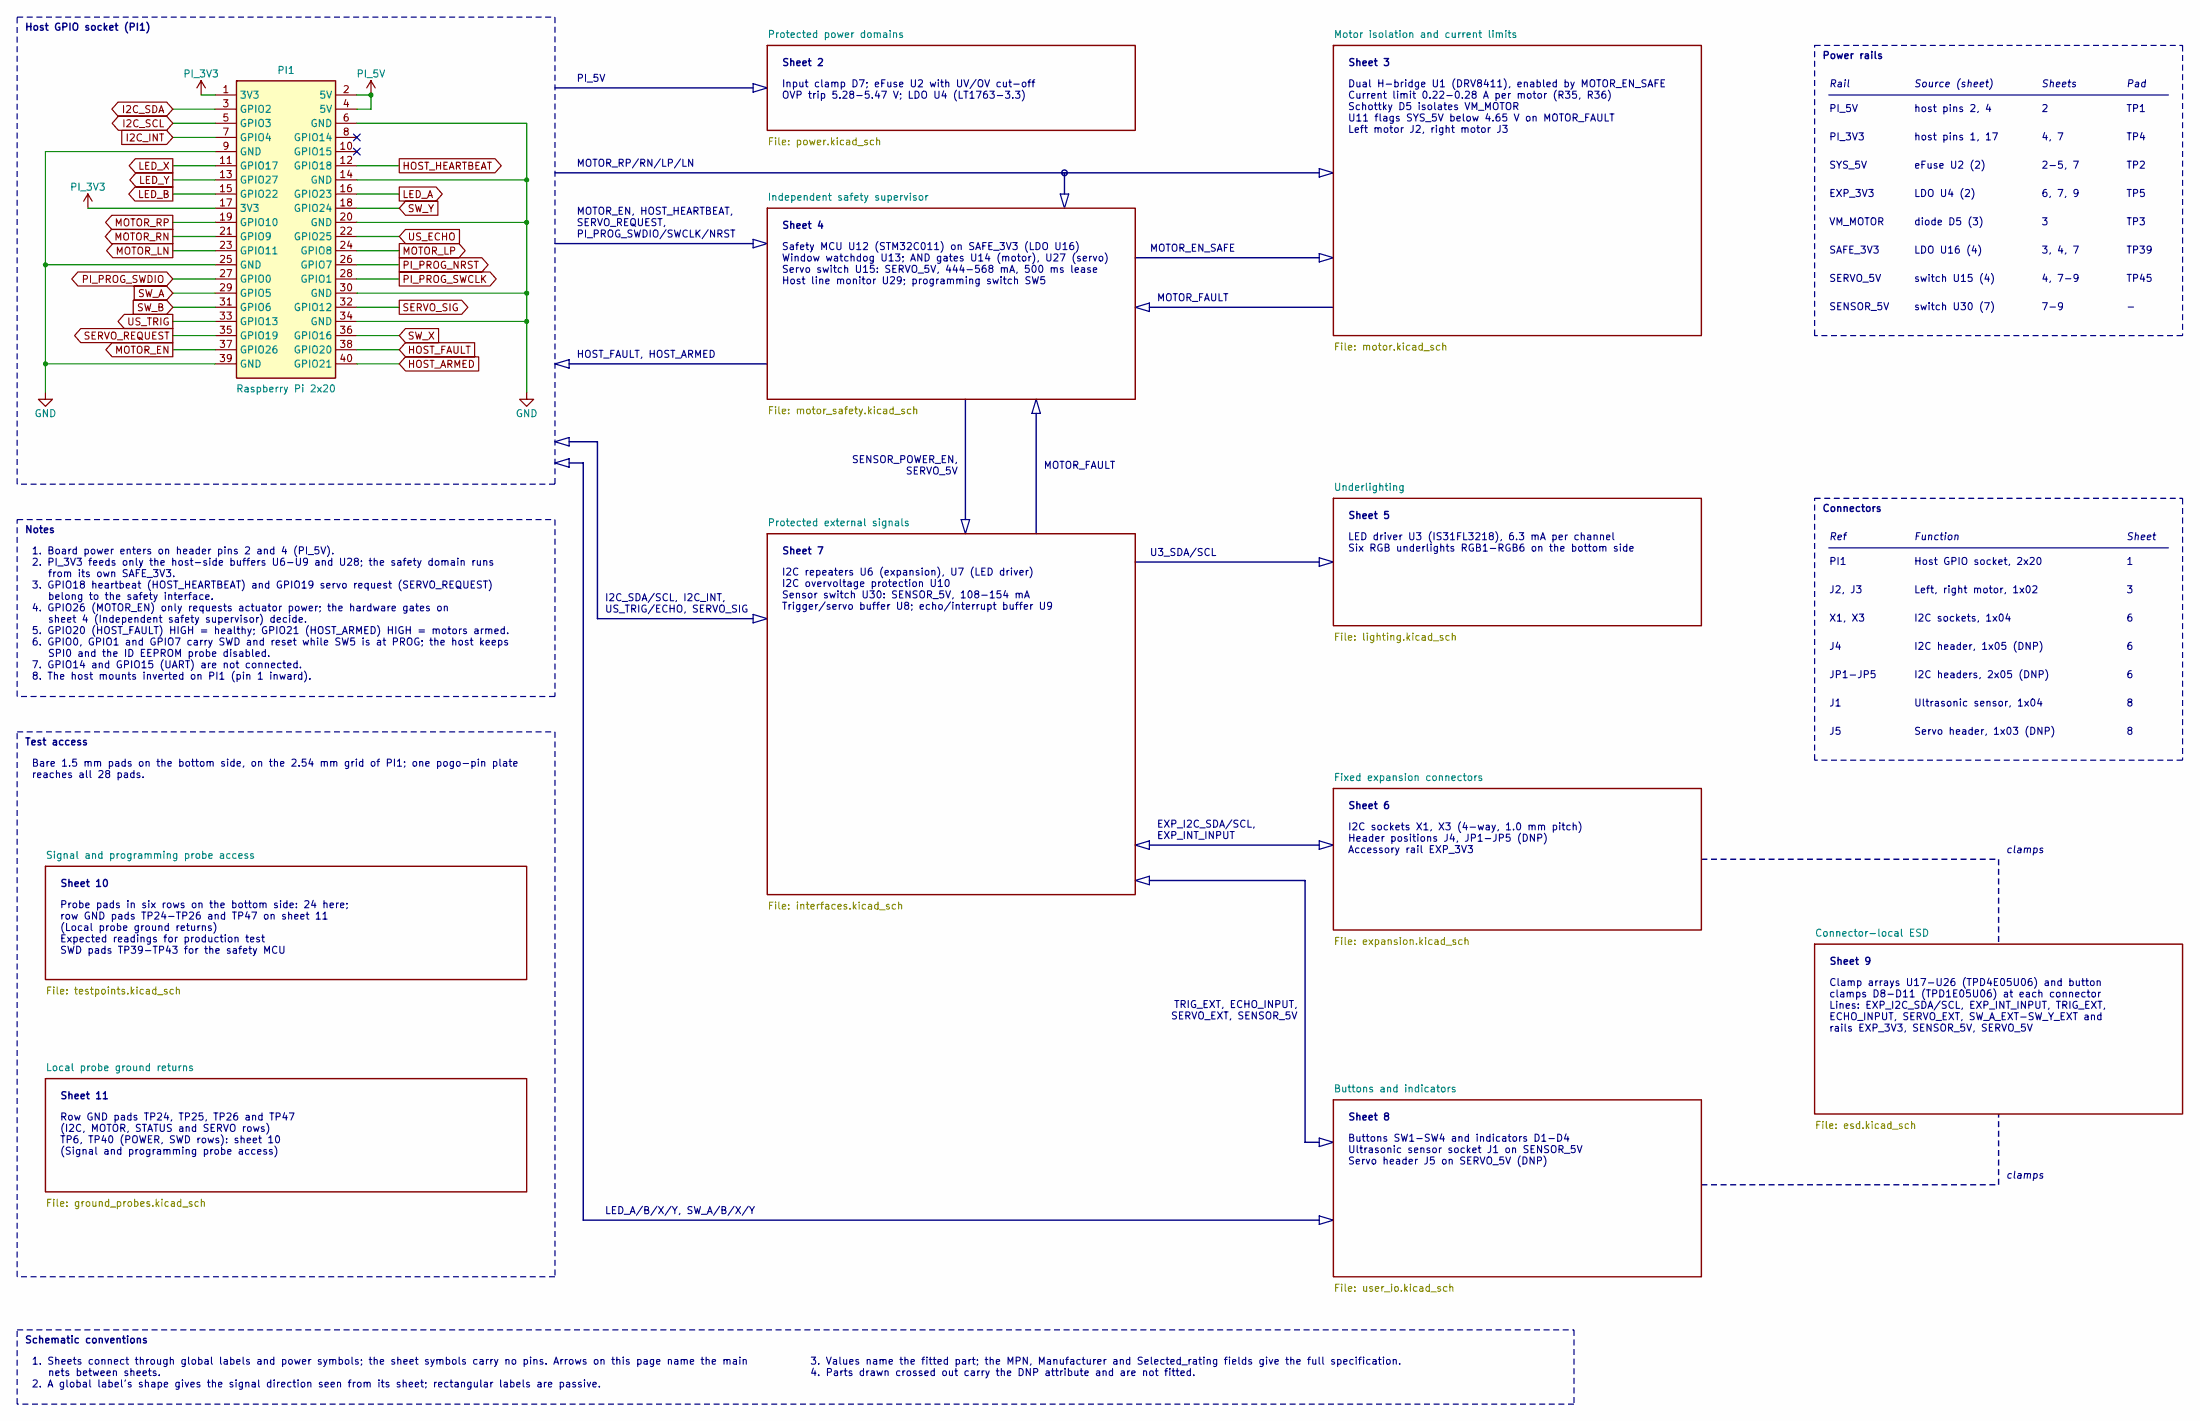
[picture p65: schematic Keel.kicad_sch, Keel R3 / Host interface]

Parts:
PI1: Raspberry Pi 2x20; PinSocket_2x20_P2.54mm_Vertical; MPN SSW-120-01-G-D

Connections:
GND: PI1.6 (GND), PI1.9 (GND), PI1.14 (GND), PI1.20 (GND), PI1.25 (GND), PI1.30 (GND), PI1.34 (GND), PI1.39 (GND); also elsewhere on the board
HOST_ARMED: PI1.40 (GPIO21); also elsewhere on the board
HOST_FAULT: PI1.38 (GPIO20); also elsewhere on the board
HOST_HEARTBEAT: PI1.12 (GPIO18); also elsewhere on the board
I2C_INT: PI1.7 (GPIO4); also elsewhere on the board
I2C_SCL: PI1.5 (GPIO3); also elsewhere on the board
I2C_SDA: PI1.3 (GPIO2); also elsewhere on the board
LED_A: PI1.16 (GPIO23); also elsewhere on the board
LED_B: PI1.15 (GPIO22); also elsewhere on the board
LED_X: PI1.11 (GPIO17); also elsewhere on the board
LED_Y: PI1.13 (GPIO27); also elsewhere on the board
MOTOR_EN: PI1.37 (GPIO26); also elsewhere on the board
MOTOR_LN: PI1.23 (GPIO11); also elsewhere on the board
MOTOR_LP: PI1.24 (GPIO8); also elsewhere on the board
MOTOR_RN: PI1.21 (GPIO9); also elsewhere on the board
MOTOR_RP: PI1.19 (GPIO10); also elsewhere on the board
PI_3V3: PI1.1 (3V3), PI1.17 (3V3); also elsewhere on the board
PI_5V: PI1.2 (5V), PI1.4 (5V); also elsewhere on the board
PI_PROG_NRST: PI1.26 (GPIO7); also elsewhere on the board
PI_PROG_SWCLK: PI1.28 (GPIO1); also elsewhere on the board
PI_PROG_SWDIO: PI1.27 (GPIO0); also elsewhere on the board
SERVO_REQUEST: PI1.35 (GPIO19); also elsewhere on the board
SERVO_SIG: PI1.32 (GPIO12); also elsewhere on the board
SW_A: PI1.29 (GPIO5); also elsewhere on the board
SW_B: PI1.31 (GPIO6); also elsewhere on the board
SW_X: PI1.36 (GPIO16); also elsewhere on the board
SW_Y: PI1.18 (GPIO24); also elsewhere on the board
US_ECHO: PI1.22 (GPIO25); also elsewhere on the board
US_TRIG: PI1.33 (GPIO13); also elsewhere on the board

Notes on the sheet:
Host GPIO socket (PI1)
Notes
1. Board power enters on header pins 2 and 4 (PI_5V). 2. PI_3V3 feeds only the host-side buffers U6-U9 and U28; the safety domain runs from its own SAFE_3V3. 3. GPIO18 heartbeat (HOST_HEARTBEAT) and GPIO19 servo request (SERVO_REQUEST) belong to the safety interface. 4. GPIO26 (MOTOR_EN) only reque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
Sheet 2
Input clamp D7; eFuse U2 with UV/OV cut-off OVP trip 5.28-5.47 V; LDO U4 (LT1763-3.3)
Sheet 4
Safety MCU U12 (STM32C011) on SAFE_3V3 (LDO U16) Window watchdog U13; AND gates U14 (motor), U27 (servo) Servo switch U15: SERVO_5V, 444-568 mA, 500 ms lease Host line monitor U29; programming switch SW5
Sheet 7
I2C repeaters U6 (expansion), U7 (LED driver) I2C overvoltage protection U10 Sensor switch U30: SENSOR_5V, 108-154 mA Trigger/servo buffer U8; echo/interrupt buffer U9
Sheet 3
Dual H-bridge U1 (DRV8411), enabled by MOTOR_EN_SAFE Current limit 0.22-0.28 A per motor (R35, R36) Schottky D5 isolates VM_MOTOR U11 flags SYS_5V below 4.65 V on MOTOR_FAULT Left motor J2, right motor J3
Sheet 5
LED driver U3 (IS31FL3218), 6.3 mA per channel Six RGB underlights RGB1-RGB6 on the bottom side
Sheet 6
I2C sockets X1, X3 (4-way, 1.0 mm pitch) Header positions J4, JP1-JP5 (DNP) Accessory rail EXP_3V3
Sheet 8
Buttons SW1-SW4 and indicators D1-D4 Ultrasonic sensor socket J1 on SENSOR_5V Servo header J5 on SERVO_5V (DNP)
Sheet 9
Clamp arrays U17-U26 (TPD4E05U06) and button clamps D8-D11 (TPD1E05U06) at each connector Lines: EXP_I2C_SDA/SCL, EXP_INT_INPUT, TRIG_EXT, ECHO_INPUT, SERVO_EXT, SW_A_EXT-SW_Y_EXT and rails EXP_3V3, SENSOR_5V, SERVO_5V
Sheet 10
Probe pads in six rows on the bottom side: 24 here; row GND pads TP24-TP26 and TP47 on sheet 11 (Local probe ground returns) Expected readings for production test SWD pads TP39-TP43 for the safety MCU
Sheet 11
Row GND pads TP24, TP25, TP26 and TP47 (I2C, MOTOR, STATUS and SERVO rows) TP6, TP40 (POWER, SWD rows): sheet 10 (Signal and programming probe access)
Test access
Bare 1.5 mm pads on the bottom side, on the 2.54 mm grid of PI1; one pogo-pin plate reaches all 28 pads.
Power rails
Rail
Source (sheet)
Sheets
Pad
PI_5V
host pins 2, 4
TP1
PI_3V3
host pins 1, 17
4, 7
TP4
SYS_5V
eFuse U2 (2)
2-5, 7
TP2
EXP_3V3
LDO U4 (2)
6, 7, 9
TP5
VM_MOTOR
diode D5 (3)
TP3
SAFE_3V3
LDO U16 (4)
3, 4, 7
TP39
SERVO_5V
switch U15 (4)
4, 7-9
TP45
SENSOR_5V
switch U30 (7)
7-9
Connectors
Ref
Function
Sheet
PI1
Host GPIO socket, 2x20
J2, J3
Left, right motor, 1x02
X1, X3
I2C sockets, 1x04
I2C header, 1x05 (DNP)
JP1-JP5
I2C headers, 2x05 (DNP)
Ultrasonic sensor, 1x04
Servo header, 1x03 (DNP)
MOTOR_RP/RN/LP/LN
MOTOR_EN, HOST_HEARTBEAT, SERVO_REQUEST, PI_PROG_SWDIO/SWCLK/NRST
HOST_FAULT, HOST_ARMED
I2C_SDA/SCL, I2C_INT, US_TRIG/ECHO, SERVO_SIG
LED_A/B/X/Y, SW_A/B/X/Y
MOTOR_EN_SAFE
MOTOR_FAULT
SENSOR_POWER_EN, SERVO_5V
U3_SDA/SCL
EXP_I2C_SDA/SCL, EXP_INT_INPUT
TRIG_EXT, ECHO_INPUT, SERVO_EXT, SENSOR_5V
clamps
Schematic conventions
1. Sheets connect through global labels and power symbols; the sheet symbols carry no pins. Arrows on this page name the main nets between sheets. 2. A global label's shape gives the signal direction seen from its sheet; rectangular labels are passive.
3. Values name the fitted part; the MPN, Manufacturer and Selected_rating fields give the full specification. 4. Parts drawn crossed out carry the DNP attribute and are not fitted.

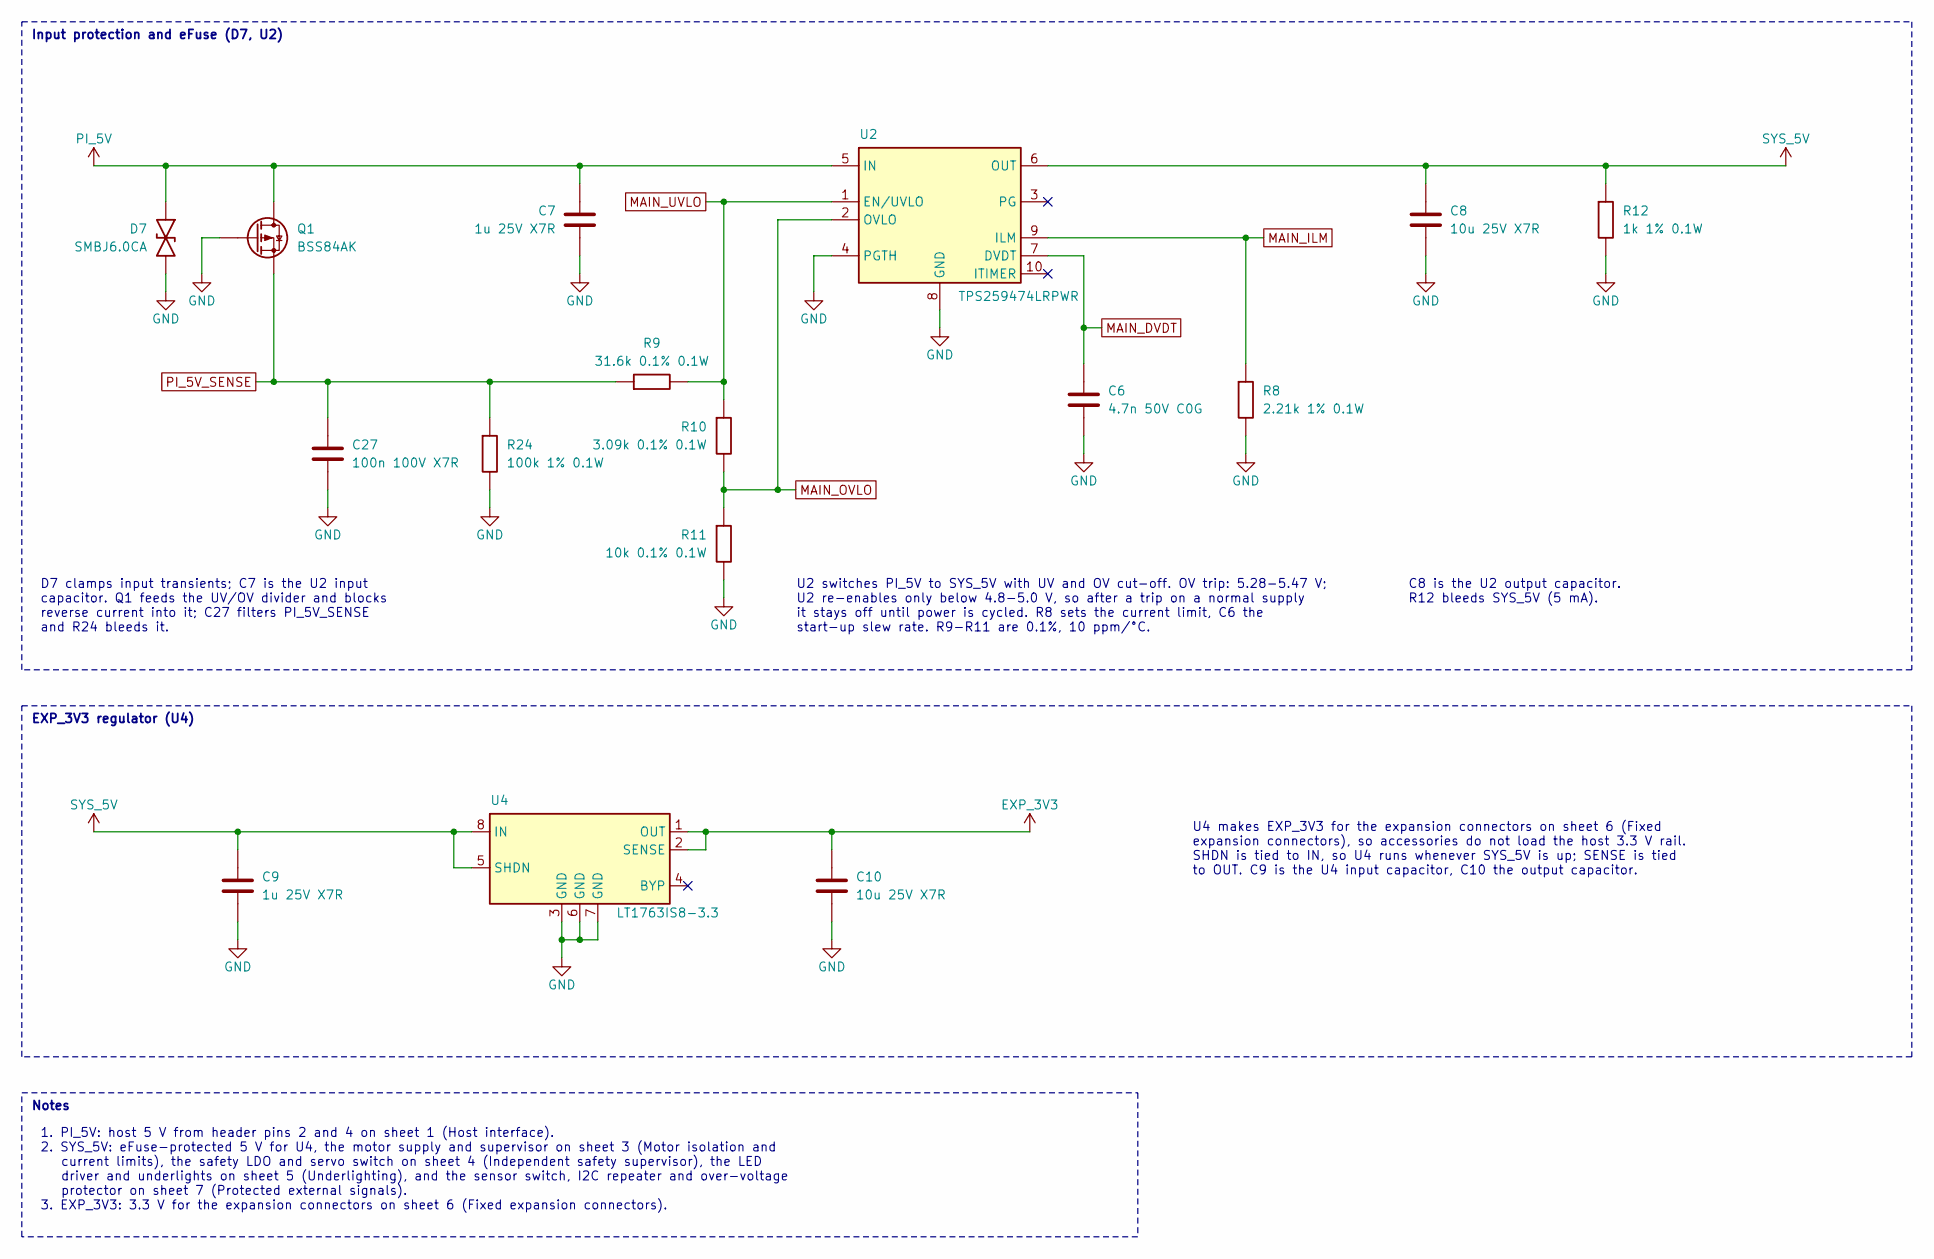
[picture p66: schematic power.kicad_sch, Keel R3 / Protected power domains]

Parts:
C6: 4.7n 50V C0G; C_0603_1608Metric; MPN GRM1885C1H472JA01D
C7, C9: 1u 25V X7R; C_0805_2012Metric; MPN GRM219R71E105KA88D
C8, C10: 10u 25V X7R; C_1206_3216Metric; MPN GRM31CR71E106KA12L
C27: 100n 100V X7R; C_0603_1608Metric; MPN GRM188R72A104KA35D
D7: SMBJ6.0CA; D_SMB; MPN SMBJ6.0CA
Q1: BSS84AK; SOT-23; MPN BSS84AK,215
R8: 2.21k 1% 0.1W; R_0603_1608Metric; MPN RC0603FR-072K21L
R9: 31.6k 0.1% 0.1W; R_0603_1608Metric; MPN ERA-3ARB3162V
R10: 3.09k 0.1% 0.1W; R_0603_1608Metric; MPN ERA-3ARB3091V
R11: 10k 0.1% 0.1W; R_0603_1608Metric; MPN RT0603BRB0710KL
R12: 1k 1% 0.1W; R_0603_1608Metric; MPN RC0603FR-071KL
R24: 100k 1% 0.1W; R_0603_1608Metric; MPN RC0603FR-07100KL
U2: TPS259474LRPWR; TPS25947_RPW0010A; MPN TPS259474LRPWR
U4: LT1763IS8-3.3; SOIC-8_3.9x4.9mm_P1.27mm; MPN LT1763IS8-3.3#PBF

Connections:
EXP_3V3: C10.1, U4.1 (OUT), U4.2 (SENSE); also elsewhere on the board
GND: C6.2, C7.2, C8.2, C9.2, C10.2, C27.2, D7.2, Q1.1, R8.2, R11.2, R12.2, R24.2, U2.4 (PGTH), U2.8 (GND), U4.3 (GND), U4.6 (GND), U4.7 (GND); also elsewhere on the board
MAIN_DVDT: C6.1, U2.7 (DVDT)
MAIN_ILM: R8.1, U2.9 (ILM)
MAIN_OVLO: R10.2, R11.1, U2.2 (OVLO)
MAIN_UVLO: R9.2, R10.1, U2.1 (EN/UVLO)
PI_5V: C7.1, D7.1, Q1.3, U2.5 (IN); also elsewhere on the board
PI_5V_SENSE: C27.1, Q1.2, R9.1, R24.1
SYS_5V: C8.1, C9.1, R12.1, U2.6 (OUT), U4.5 (SHDN), U4.8 (IN); also elsewhere on the board

Notes on the sheet:
Input protection and eFuse (D7, U2)
D7 clamps input transients; C7 is the U2 input capacitor. Q1 feeds the UV/OV divider and blocks reverse current into it; C27 filters PI_5V_SENSE and R24 bleeds it.
U2 switches PI_5V to SYS_5V with UV and OV cut-off. OV trip: 5.28-5.47 V; U2 re-enables only below 4.8-5.0 V, so after a trip on a normal supply it stays off until power is cycled. R8 sets the current limit, C6 the start-up slew rate. R9-R11 are 0.1%, 10 ppm/°C.
C8 is the U2 output capacitor. R12 bleeds SYS_5V (5 mA).
EXP_3V3 regulator (U4)
U4 makes EXP_3V3 for the expansion connectors on sheet 6 (Fixed expansion connectors), so accessories do not load the host 3.3 V rail. SHDN is tied to IN, so U4 runs whenever SYS_5V is up; SENSE is tied to OUT. C9 is the U4 input capacitor, C10 the output capacitor.
Notes
1. PI_5V: host 5 V from header pins 2 and 4 on sheet 1 (Host interface). 2. SYS_5V: eFuse-protected 5 V for U4, the motor supply and supervisor on sheet 3 (Motor isolation and current limits), the safety LDO and servo switch on sheet 4 (Independent safety supervisor), the LED driver and underlights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

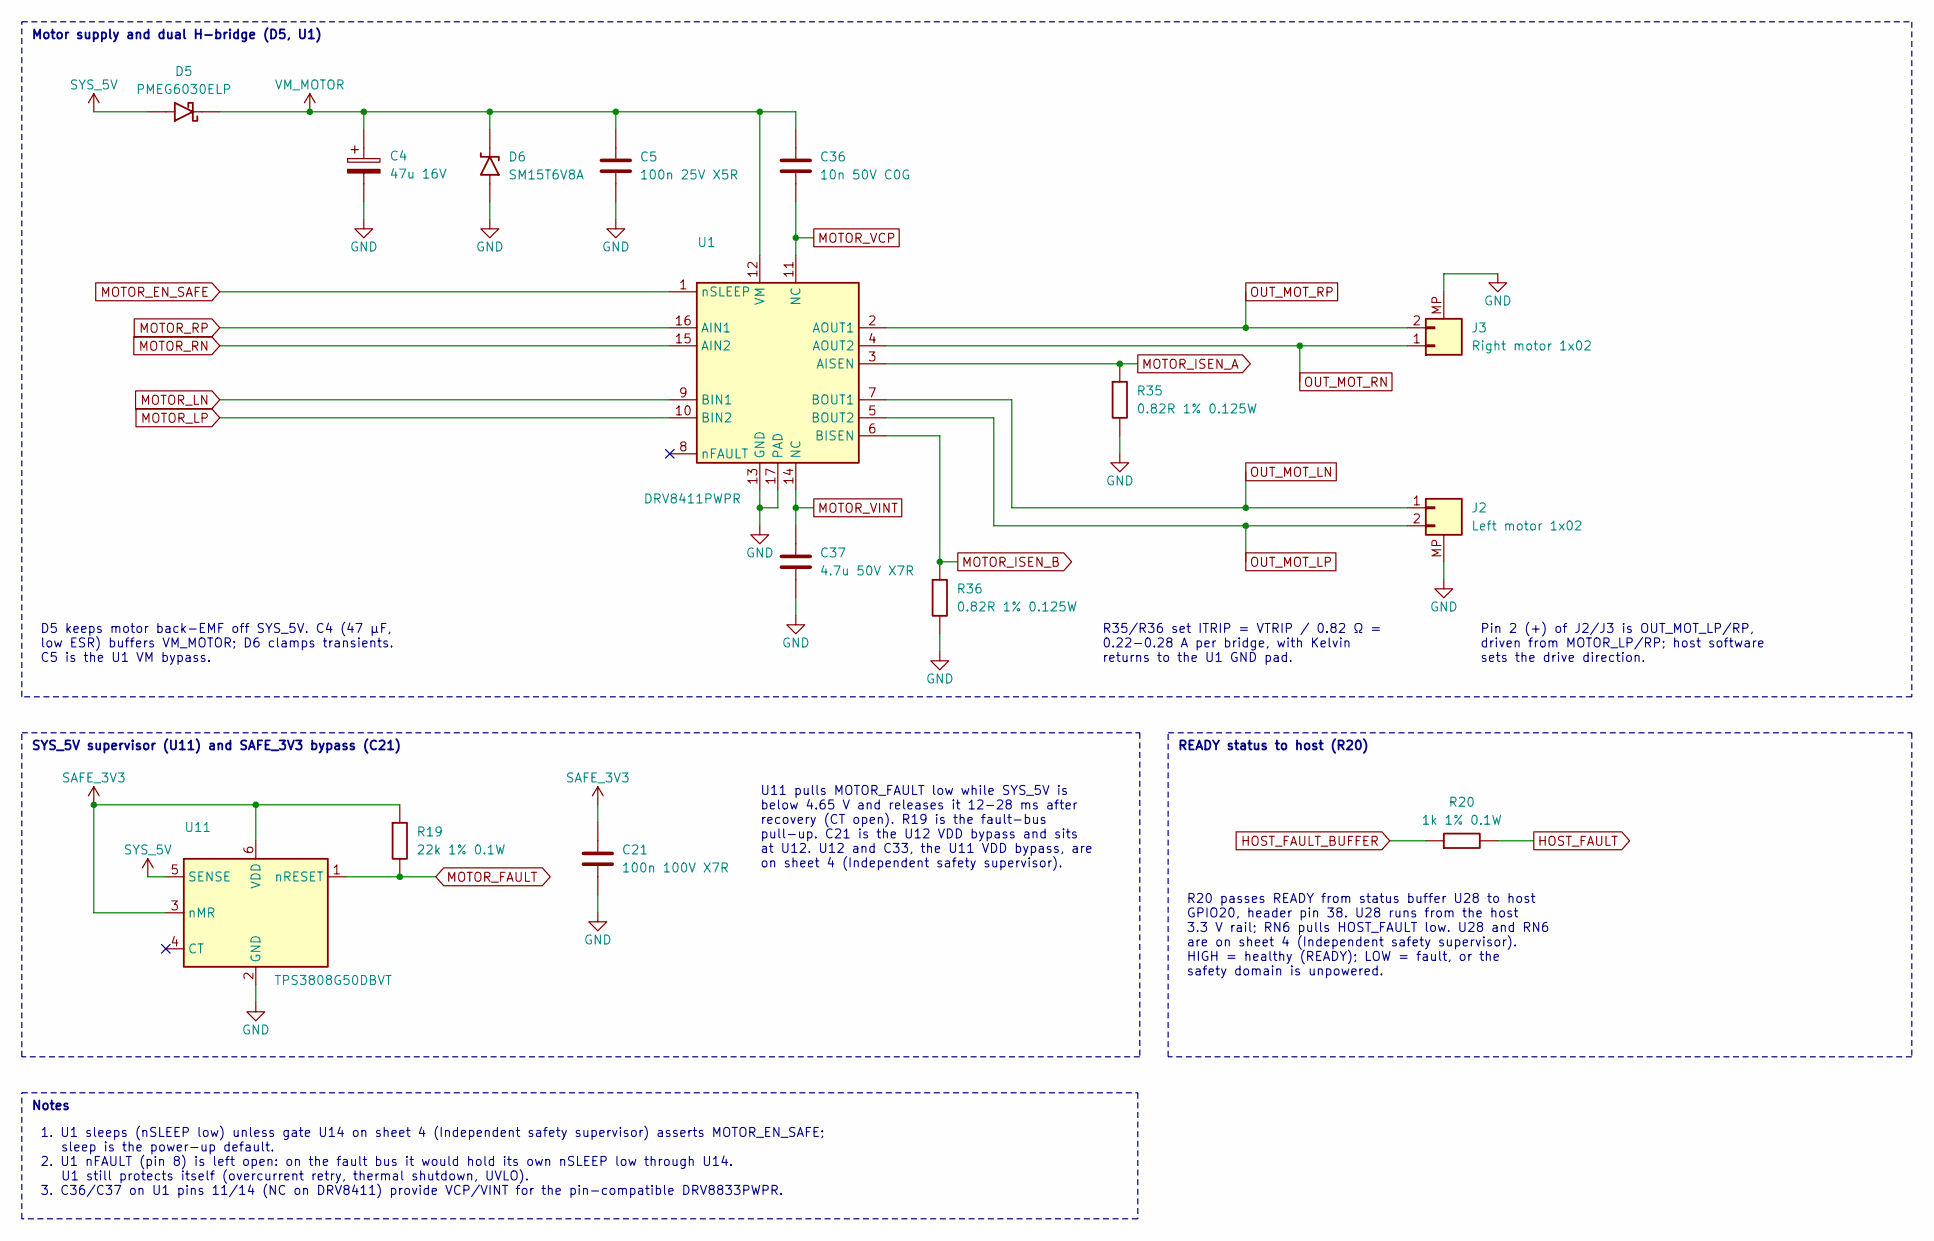
[picture p67: schematic motor.kicad_sch, Keel R3 / Motor isolation and current limits]

Parts:
C4: 47u 16V; CP_Elec_6.3x5.8; MPN EEE-FP1C470AP
C5: 100n 25V X5R; C_0201_0603Metric; MPN GRM033R61E104KE14D
C21: 100n 100V X7R; C_0603_1608Metric; MPN GRM188R72A104KA35D
C36: 10n 50V C0G; C_0603_1608Metric; MPN GRM1885C1H103JA01D
C37: 4.7u 50V X7R; C_1206_3216Metric; MPN GRM31CR71H475KA12L
D5: PMEG6030ELP; D_SOD-128; MPN PMEG6030ELP,115
D6: SM15T6V8A; D_SMC; MPN SM15T6V8A-TR
J2: Left motor 1x02; JST_ZH_S2B-ZR-SM4A-TF_1x02-1MP_P1.50mm_Horizontal; MPN S2B-ZR-SM4A-TF
J3: Right motor 1x02; JST_ZH_S2B-ZR-SM4A-TF_1x02-1MP_P1.50mm_Horizontal; MPN S2B-ZR-SM4A-TF
R19: 22k 1% 0.1W; R_0603_1608Metric; MPN RC0603FR-0722KL
R20: 1k 1% 0.1W; R_0603_1608Metric; MPN RC0603FR-071KL
R35, R36: 0.82R 1% 0.125W; R_0805_2012Metric; MPN RL0805FR-070R82L
U1: DRV8411PWPR; DRV8411A_PWP0016_C01_ExternalVias; MPN DRV8411PWPR
U11: TPS3808G50DBVT; SOT-23-6; MPN TPS3808G50DBVT

Connections:
GND: C4.2, C5.2, C21.2, C37.2, D6.2 (A), J2.MP (mounts), J3.MP (mounts), R35.2, R36.2, U1.13 (GND), U1.17 (THERMAL_PAD), U11.2 (GND); also elsewhere on the board
HOST_FAULT: R20.2; also elsewhere on the board
HOST_FAULT_BUFFER: R20.1; also elsewhere on the board
MOTOR_EN_SAFE: U1.1 (VREF); also elsewhere on the board
MOTOR_FAULT: R19.2, U11.1 (nRESET); also elsewhere on the board
MOTOR_ISEN_A: R35.1, U1.3 (PGNDA); also elsewhere on the board
MOTOR_ISEN_B: R36.1, U1.6 (PGNDB); also elsewhere on the board
MOTOR_LN: U1.9 (BIN1); also elsewhere on the board
MOTOR_LP: U1.10 (BIN2); also elsewhere on the board
MOTOR_RN: U1.15 (AIN2); also elsewhere on the board
MOTOR_RP: U1.16 (AIN1); also elsewhere on the board
MOTOR_VCP: C36.1, U1.11 (BIPROPI)
MOTOR_VINT: C37.1, U1.14 (AIPROPI)
OUT_MOT_LN: J2.1, U1.7 (BOUT1)
OUT_MOT_LP: J2.2, U1.5 (BOUT2)
OUT_MOT_RN: J3.1, U1.4 (AOUT2)
OUT_MOT_RP: J3.2, U1.2 (AOUT1)
SAFE_3V3: C21.1, R19.1, U11.3 (nMR), U11.6 (VDD); also elsewhere on the board
SYS_5V: D5.2 (A), U11.5 (SENSE); also elsewhere on the board
VM_MOTOR: C4.1, C5.1, C36.2, D5.1 (K), D6.1 (K), U1.12 (VM); also elsewhere on the board

Notes on the sheet:
Motor supply and dual H-bridge (D5, U1)
D5 keeps motor back-EMF off SYS_5V. C4 (47 µF, low ESR) buffers VM_MOTOR; D6 clamps transients. C5 is the U1 VM bypass.
R35/R36 set ITRIP = VTRIP / 0.82 Ω = 0.22-0.28 A per bridge, with Kelvin returns to the U1 GND pad.
Pin 2 (+) of J2/J3 is OUT_MOT_LP/RP, driven from MOTOR_LP/RP; host software sets the drive direction.
SYS_5V supervisor (U11) and SAFE_3V3 bypass (C21)
U11 pulls MOTOR_FAULT low while SYS_5V is below 4.65 V and releases it 12-28 ms after recovery (CT open). R19 is the fault-bus pull-up. C21 is the U12 VDD bypass and sits at U12. U12 and C33, the U11 VDD bypass, are on sheet 4 (Independent safety supervisor).
READY status to host (R20)
R20 passes READY from status buffer U28 to host GPIO20, header pin 38. U28 runs from the host 3.3 V rail; RN6 pulls HOST_FAULT low. U28 and RN6 are on sheet 4 (Independent safety supervisor). HIGH = healthy (READY); LOW = fault, or the safety domain is unpowered.
Notes
1. U1 sleeps (nSLEEP low) unless gate U14 on sheet 4 (Independent safety supervisor) asserts MOTOR_EN_SAFE; sleep is the power-up default. 2. U1 nFAULT (pin 8) is left open: on the fault bus it would hold its own nSLEEP low through U14. U1 still protects itself (overcurrent retry, thermal shutdown,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

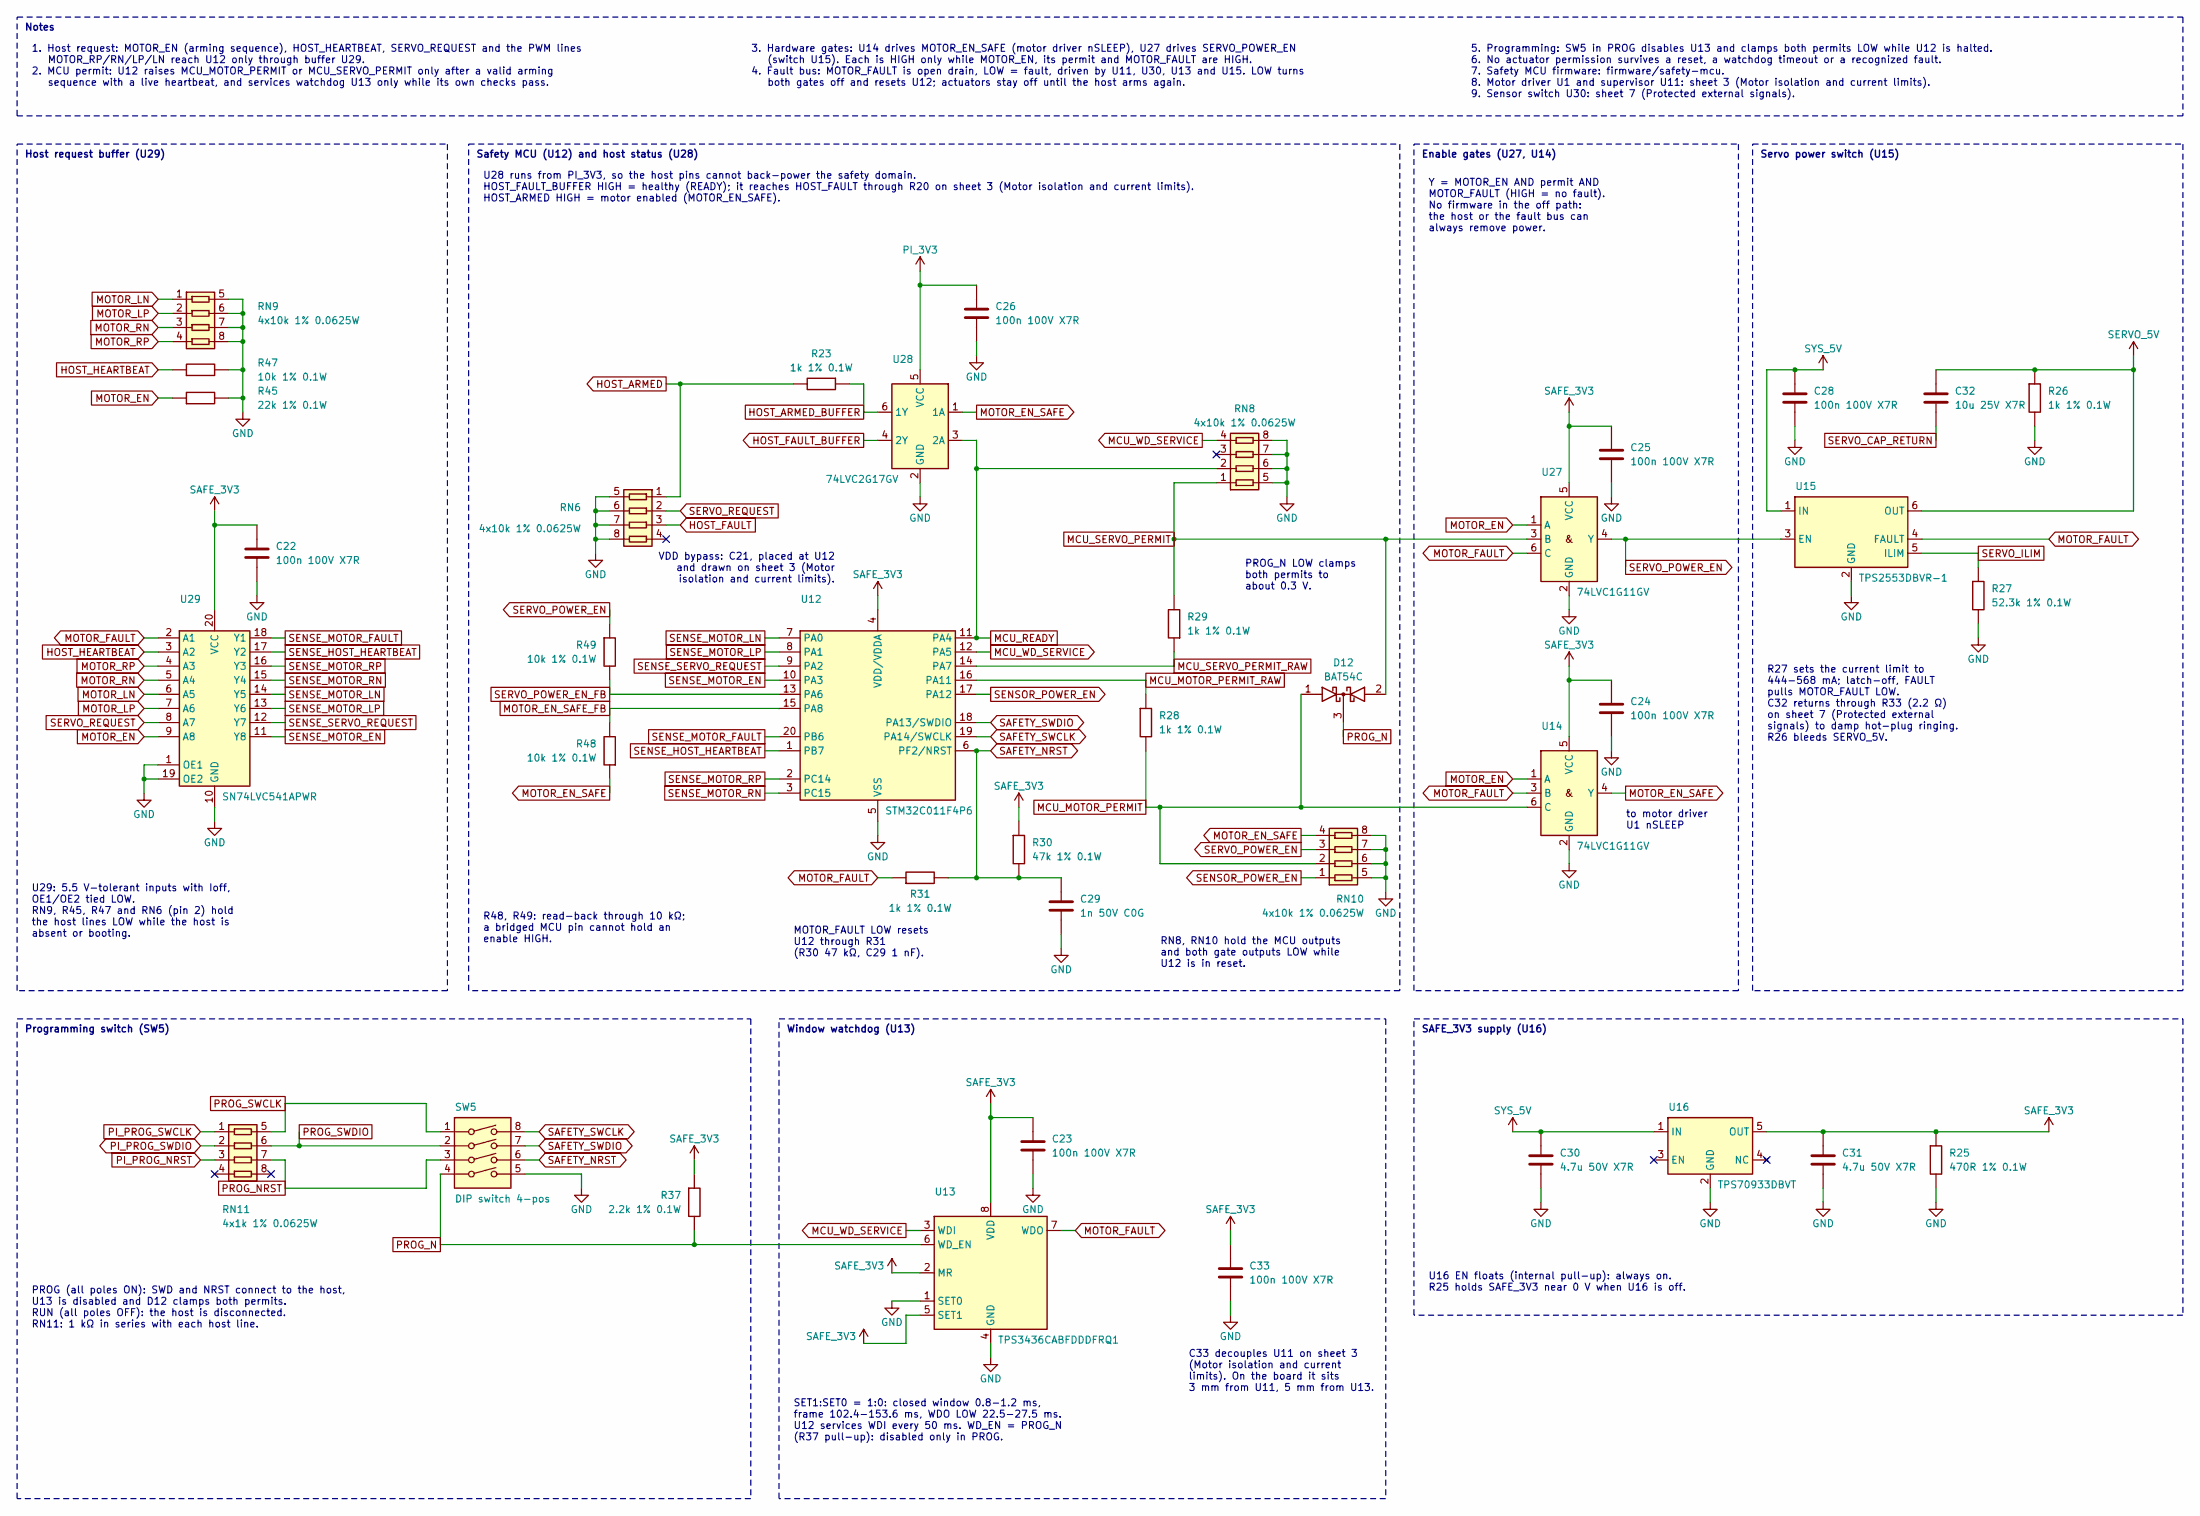
[picture p68: schematic motor_safety.kicad_sch, Keel R3 / Independent safety supervisor]

Parts:
C22, C23, C24, C25, C26, C28, C33: 100n 100V X7R; C_0603_1608Metric; MPN GRM188R72A104KA35D
C29: 1n 50V C0G; C_0603_1608Metric; MPN GRM1885C1H102JA01D
C30, C31: 4.7u 50V X7R; C_1206_3216Metric; MPN GRM31CR71H475KA12L
C32: 10u 25V X7R; C_1206_3216Metric; MPN GRM31CR71E106KA12L
D12: BAT54C; SOT-23; MPN BAT54C,215
R23, R26, R28, R29, R31: 1k 1% 0.1W; R_0603_1608Metric; MPN RC0603FR-071KL
R25: 470R 1% 0.1W; R_0603_1608Metric; MPN RC0603FR-07470RL
R27: 52.3k 1% 0.1W; R_0603_1608Metric; MPN RC0603FR-0752K3L
R30: 47k 1% 0.1W; R_0603_1608Metric; MPN RC0603FR-0747KL
R37: 2.2k 1% 0.1W; R_0603_1608Metric; MPN RC0603FR-072K2L
R45: 22k 1% 0.1W; R_0603_1608Metric; MPN RC0603FR-0722KL
R47, R48, R49: 10k 1% 0.1W; R_0603_1608Metric; MPN RC0603FR-0710KL
RN6, RN8, RN9, RN10: 4x10k 1% 0.0625W; YC164_4x0603; MPN YC164-FR-0710KL
RN11: 4x1k 1% 0.0625W; YC164_4x0603; MPN YC164-FR-071KL
SW5: DIP switch 4-pos; SW_DIP_SPSTx04_Slide_KingTek_DSHP04TS_W7.62mm_P1.27mm; MPN TDA04H0SB1R
U12: STM32C011F4P6; TSSOP-20_4.4x6.5mm_P0.65mm; MPN STM32C011F4P6
U13: TPS3436CABFDDDFRQ1; TI_DDF0008A_1.6x2.9mm_P0.65mm_CommonMask; MPN TPS3436CABFDDDFRQ1
U14, U27: 74LVC1G11GV; Nexperia_SOT457_SC74_1.5x2.9mm_P0.95mm; MPN 74LVC1G11GV,125
U15: TPS2553DBVR-1; SOT-23-6; MPN TPS2553DBVR-1
U16: TPS70933DBVT; SOT-23-5; MPN TPS70933DBVT
U28: 74LVC2G17GV; Nexperia_SOT457_SC74_1.5x2.9mm_P0.95mm; MPN 74LVC2G17GV,125
U29: SN74LVC541APWR; TSSOP-20_4.4x6.5mm_P0.65mm; MPN SN74LVC541APWR

Connections:
GND: C22.2, C23.2, C24.2, C25.2, C26.2, C28.2, C29.2, C30.2, C31.2, C33.2, R25.2, R26.2, R27.2, R45.2, R47.2, RN6.5, RN6.6, RN6.7, RN6.8, RN8.5, RN8.6, RN8.7, RN8.8, RN9.5, RN9.6, RN9.7, RN9.8, RN10.5, RN10.6, RN10.7, RN10.8, SW5.5 (S4), U12.5 (VSS), U13.1 (SET0), U13.4 (GND), U14.2 (GND), U15.2 (GND), U16.2 (GND), U27.2 (GND), U28.2 (GND), U29.1 (1OE), U29.10 (GND), U29.19 (2OE); also elsewhere on the board
HOST_ARMED: R23.2, RN6.1; also elsewhere on the board
HOST_ARMED_BUFFER: R23.1, U28.6 (1Y)
HOST_FAULT: RN6.3; also elsewhere on the board
HOST_FAULT_BUFFER: U28.4 (2Y); also elsewhere on the board
HOST_HEARTBEAT: R47.1, U29.3 (2Y4); also elsewhere on the board
MCU_MOTOR_PERMIT: D12.1 (A1), R28.2, RN10.2, U14.6 (C)
MCU_MOTOR_PERMIT_RAW: R28.1, U12.16 (PA11)
MCU_READY: RN8.2, U12.11 (PA4), U28.3 (2A)
MCU_SERVO_PERMIT: D12.2 (A2), R29.2, RN8.1, U27.3 (B)
MCU_SERVO_PERMIT_RAW: R29.1, U12.14 (PA7)
MCU_WD_SERVICE: RN8.4, U12.12 (PA5), U13.3 (WDI); also elsewhere on the board
MOTOR_EN: R45.1, U14.1 (A), U27.1 (A), U29.9 (2Y1); also elsewhere on the board
MOTOR_EN_SAFE: R48.1, RN10.4, U14.4 (Y), U28.1 (1A); also elsewhere on the board
MOTOR_EN_SAFE_FB: R48.2, U12.15 (PA8)
MOTOR_FAULT: R31.1, U13.7 (WDO), U14.3 (B), U15.4 (FAULT), U27.6 (C), U29.2 (1A1); also elsewhere on the board
MOTOR_LN: RN9.1, U29.6 (1A3); also elsewhere on the board
MOTOR_LP: RN9.2, U29.7 (2Y2); also elsewhere on the board
MOTOR_RN: RN9.3, U29.5 (2Y3); also elsewhere on the board
MOTOR_RP: RN9.4, U29.4 (1A2); also elsewhere on the board
PI_3V3: C26.1, U28.5 (VCC); also elsewhere on the board
PI_PROG_NRST: RN11.3; also elsewhere on the board
PI_PROG_SWCLK: RN11.1; also elsewhere on the board
PI_PROG_SWDIO: RN11.2; also elsewhere on the board
PROG_N: D12.3 (K), R37.2, SW5.4 (S4), U13.6 (WD_EN)
PROG_NRST: RN11.7, SW5.3 (S3)
PROG_SWCLK: RN11.5, SW5.1 (S1)
PROG_SWDIO: RN11.6, SW5.2 (S2)
SAFETY_NRST: C29.1, R30.2, R31.2, SW5.6 (S3), U12.6 (PF2/NRST); also elsewhere on the board
SAFETY_SWCLK: SW5.8 (S1), U12.19 (PA14/SWCLK); also elsewhere on the board
SAFETY_SWDIO: SW5.7 (S2), U12.18 (PA13/SWDIO); also elsewhere on the board
SAFE_3V3: C22.1, C23.1, C24.1, C25.1, C31.1, C33.1, R25.1, R30.1, R37.1, U12.4 (VDD/VDDA), U13.2 (MR), U13.5 (SET1), U13.8 (VDD), U14.5 (VCC), U16.5 (OUT), U27.5 (VCC), U29.20 (VCC); also elsewhere on the board
SENSE_HOST_HEARTBEAT: U12.1 (PB7), U29.17 (2A4)
SENSE_MOTOR_EN: U12.10 (PA3), U29.11 (2A1)
SENSE_MOTOR_FAULT: U12.20 (PB6), U29.18 (1Y1)
SENSE_MOTOR_LN: U12.7 (PA0), U29.14 (1Y3)
SENSE_MOTOR_LP: U12.8 (PA1), U29.13 (2A2)
SENSE_MOTOR_RN: U12.3 (PC15), U29.15 (2A3)
SENSE_MOTOR_RP: U12.2 (PC14), U29.16 (1Y2)
SENSE_SERVO_REQUEST: U12.9 (PA2), U29.12 (1Y4)
SENSOR_POWER_EN: RN10.1, U12.17 (PA12); also elsewhere on the board
SERVO_5V: C32.1, R26.1, U15.6 (OUT); also elsewhere on the board
SERVO_CAP_RETURN: C32.2; also elsewhere on the board
SERVO_ILIM: R27.1, U15.5 (ILIM)
SERVO_POWER_EN: R49.1, RN10.3, U15.3 (EN), U27.4 (Y); also elsewhere on the board
SERVO_POWER_EN_FB: R49.2, U12.13 (PA6)
SERVO_REQUEST: RN6.2, U29.8 (1A4); also elsewhere on the board
SYS_5V: C28.1, C30.1, U15.1 (IN), U16.1 (IN); also elsewhere on the board

Notes on the sheet:
VDD bypass: C21, placed at U12 and drawn on sheet 3 (Motor isolation and current limits).
to motor driver U1 nSLEEP
Host request buffer (U29)
Safety MCU (U12) and host status (U28)
Enable gates (U27, U14)
Servo power switch (U15)
Programming switch (SW5)
Window watchdog (U13)
SAFE_3V3 supply (U16)
Notes
1. Host request: MOTOR_EN (arming sequence), HOST_HEARTBEAT, SERVO_REQUEST and the PWM lines MOTOR_RP/RN/LP/LN reach U12 only through buffer U29. 2. MCU permit: U12 raises MCU_MOTOR_PERMIT or MCU_SERVO_PERMIT only after a valid arming sequence with a live heartbeat, and services watchdog U13 only w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
3. Hardware gates: U14 drives MOTOR_EN_SAFE (motor driver nSLEEP), U27 drives SERVO_POWER_EN (switch U15). Each is HIGH only while MOTOR_EN, its permit and MOTOR_FAULT are HIGH. 4. Fault bus: MOTOR_FAULT is open drain, LOW = fault, driven by U11, U30, U13 and U15. LOW turns both gates off and reset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
5. Programming: SW5 in PROG disables U13 and clamps both permits LOW while U12 is halted. 6. No actuator permission survives a reset, a watchdog timeout or a recognized fault. 7. Safety MCU firmware: firmware/safety-mcu. 8. Motor driver U1 and supervisor U11: sheet 3 (Motor isolation and current li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
U29: 5.5 V-tolerant inputs with Ioff, OE1/OE2 tied LOW. RN9, R45, R47 and RN6 (pin 2) hold the host lines LOW while the host is absent or booting.
U28 runs from PI_3V3, so the host pins cannot back-power the safety domain. HOST_FAULT_BUFFER HIGH = healthy (READY); it reaches HOST_FAULT through R20 on sheet 3 (Motor isolation and current limits). HOST_ARMED HIGH = motor enabled (MOTOR_EN_SAFE).
R48, R49: read-back through 10 kΩ; a bridged MCU pin cannot hold an enable HIGH.
MOTOR_FAULT LOW resets U12 through R31 (R30 47 kΩ, C29 1 nF).
PROG_N LOW clamps both permits to about 0.3 V.
RN8, RN10 hold the MCU outputs and both gate outputs LOW while U12 is in reset.
Y = MOTOR_EN AND permit AND MOTOR_FAULT (HIGH = no fault). No firmware in the off path: the host or the fault bus can always remove power.
R27 sets the current limit to 444-568 mA; latch-off, FAULT pulls MOTOR_FAULT LOW. C32 returns through R33 (2.2 Ω) on sheet 7 (Protected external signals) to damp hot-plug ringing. R26 bleeds SERVO_5V.
PROG (all poles ON): SWD and NRST connect to the host, U13 is disabled and D12 clamps both permits. RUN (all poles OFF): the host is disconnected. RN11: 1 kΩ in series with each host line.
SET1:SET0 = 1:0: closed window 0.8-1.2 ms, frame 102.4-153.6 ms, WDO LOW 22.5-27.5 ms. U12 services WDI every 50 ms. WD_EN = PROG_N (R37 pull-up): disabled only in PROG.
C33 decouples U11 on sheet 3 (Motor isolation and current limits). On the board it sits 3 mm from U11, 5 mm from U13.
U16 EN floats (internal pull-up): always on. R25 holds SAFE_3V3 near 0 V when U16 is off.
