BisocMOrg/Keel/hardware/kicad/Keel.kicad_pcb

## KiCad design hardware/kicad/Keel.kicad_pcb (continued)

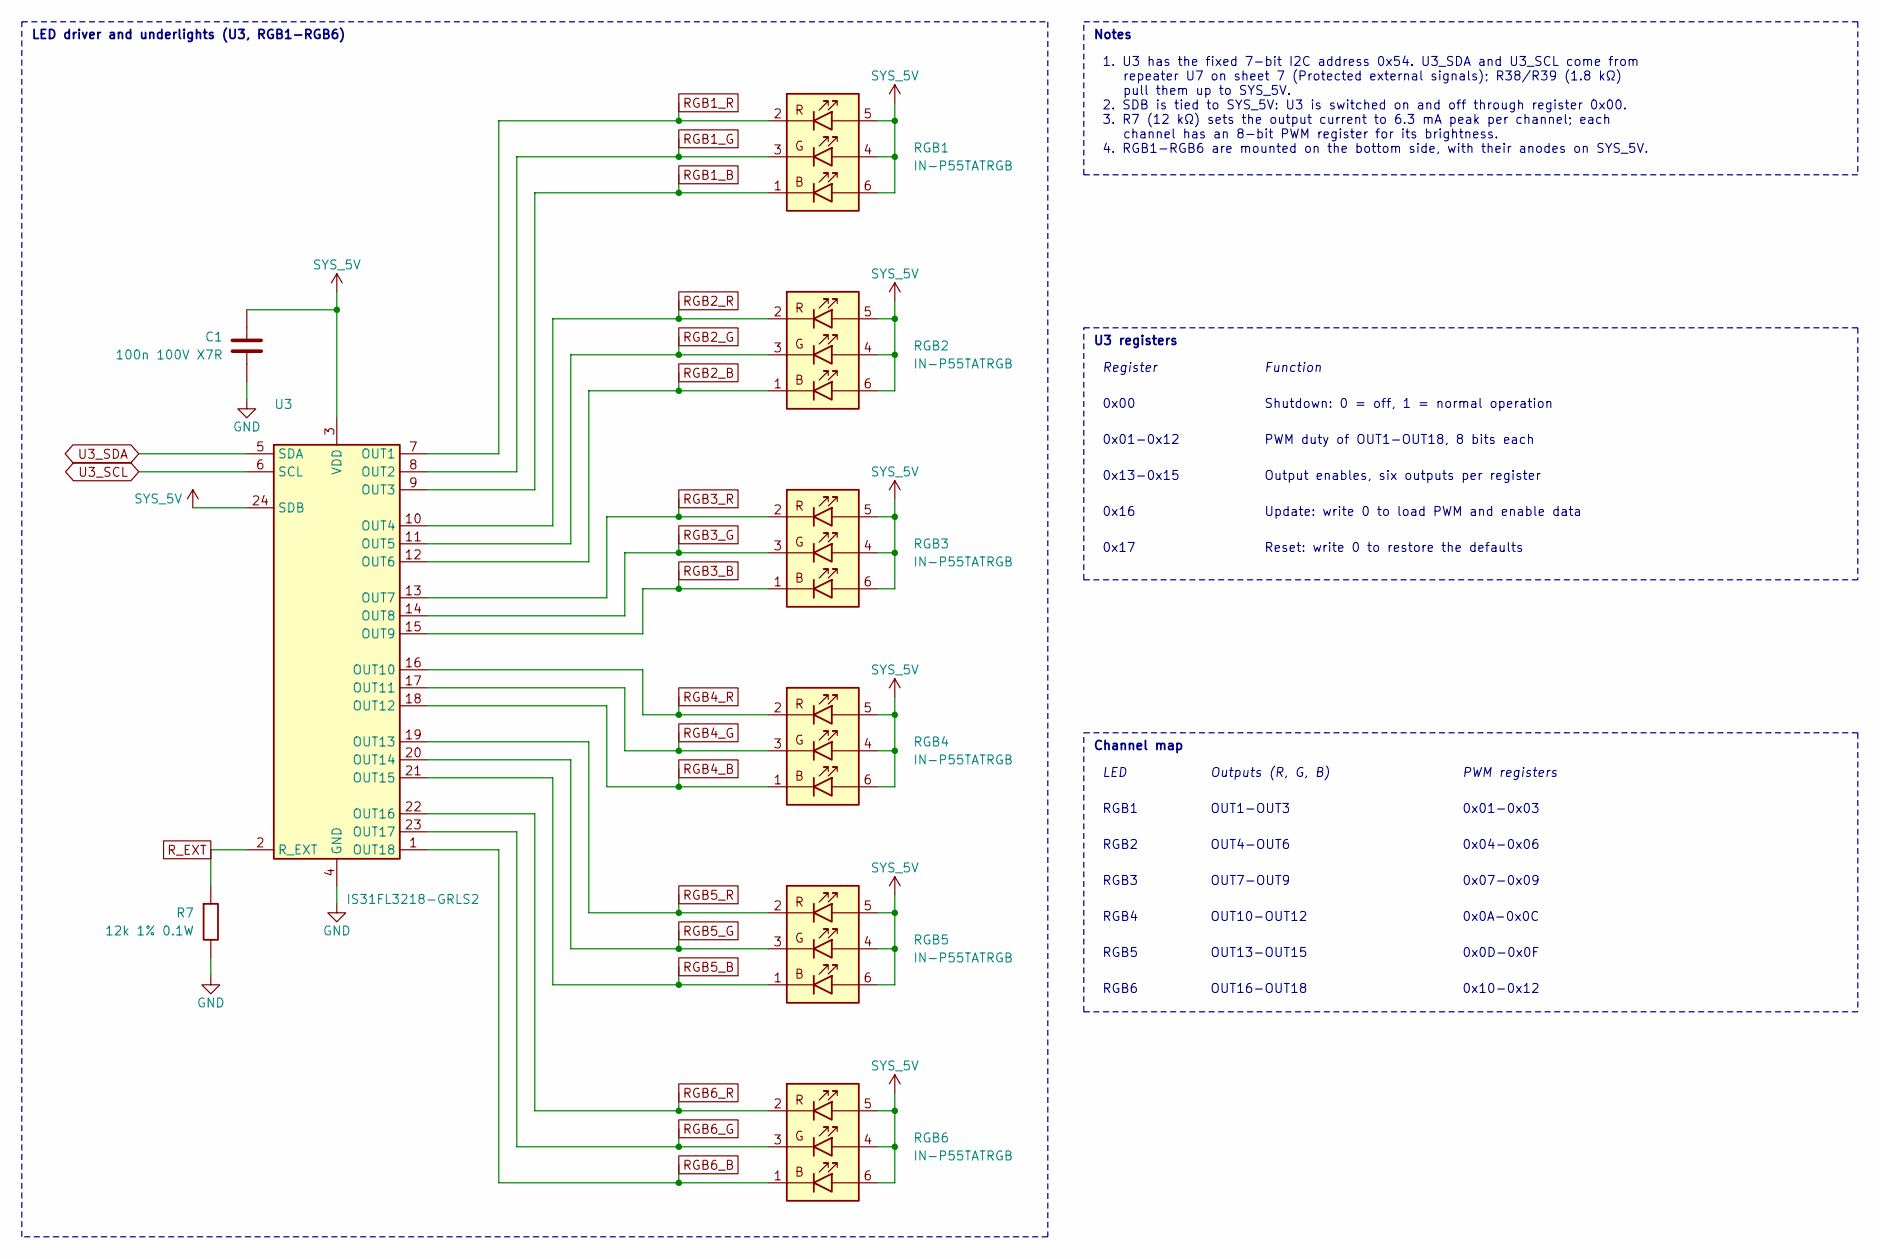
[picture p69: schematic lighting.kicad_sch, Keel R3 / Underlighting]

Parts:
C1: 100n 100V X7R; C_0603_1608Metric; MPN GRM188R72A104KA35D
R7: 12k 1% 0.1W; R_0603_1608Metric; MPN RC0603FR-0712KL
RGB1, RGB2, RGB3, RGB4, RGB5, RGB6: IN-P55TATRGB; LED_Inolux_IN-P55TATRGB_PLCC6_5.0x5.5mm_P1.8mm; MPN IN-P55TATRGB
U3: IS31FL3218-GRLS2; IS31FL3218_SOP24; MPN IS31FL3218-GRLS2

Connections:
GND: C1.2, R7.2, U3.4 (GND); also elsewhere on the board
RGB1_B: RGB1.1 (BC), U3.9 (OUT3)
RGB1_G: RGB1.3 (GC), U3.8 (OUT2)
RGB1_R: RGB1.2 (RC), U3.7 (OUT1)
RGB2_B: RGB2.1 (BC), U3.12 (OUT6)
RGB2_G: RGB2.3 (GC), U3.11 (OUT5)
RGB2_R: RGB2.2 (RC), U3.10 (OUT4)
RGB3_B: RGB3.1 (BC), U3.15 (OUT9)
RGB3_G: RGB3.3 (GC), U3.14 (OUT8)
RGB3_R: RGB3.2 (RC), U3.13 (OUT7)
RGB4_B: RGB4.1 (BC), U3.18 (OUT12)
RGB4_G: RGB4.3 (GC), U3.17 (OUT11)
RGB4_R: RGB4.2 (RC), U3.16 (OUT10)
RGB5_B: RGB5.1 (BC), U3.21 (OUT15)
RGB5_G: RGB5.3 (GC), U3.20 (OUT14)
RGB5_R: RGB5.2 (RC), U3.19 (OUT13)
RGB6_B: RGB6.1 (BC), U3.1 (OUT18)
RGB6_G: RGB6.3 (GC), U3.23 (OUT17)
RGB6_R: RGB6.2 (RC), U3.22 (OUT16)
R_EXT: R7.1, U3.2 (R_EXT)
SYS_5V: C1.1, RGB1.4 (GA), RGB1.5 (RA), RGB1.6 (BA), RGB2.4 (GA), RGB2.5 (RA), RGB2.6 (BA), RGB3.4 (GA), RGB3.5 (RA), RGB3.6 (BA), RGB4.4 (GA), RGB4.5 (RA), RGB4.6 (BA), RGB5.4 (GA), RGB5.5 (RA), RGB5.6 (BA), RGB6.4 (GA), RGB6.5 (RA), RGB6.6 (BA), U3.3 (VDD), U3.24 (SDB); also elsewhere on the board
U3_SCL: U3.6 (SCL); also elsewhere on the board
U3_SDA: U3.5 (SDA); also elsewhere on the board

Notes on the sheet:
LED driver and underlights (U3, RGB1-RGB6)
Notes
1. U3 has the fixed 7-bit I2C address 0x54. U3_SDA and U3_SCL come from repeater U7 on sheet 7 (Protected external signals); R38/R39 (1.8 kΩ) pull them up to SYS_5V. 2. SDB is tied to SYS_5V: U3 is switched on and off through register 0x00. 3. R7 (12 kΩ) sets the output current to 6.3 mA peak per c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
U3 registers
Register
Function
0x00
Shutdown: 0 = off, 1 = normal operation
0x01-0x12
PWM duty of OUT1-OUT18, 8 bits each
0x13-0x15
Output enables, six outputs per register
0x16
Update: write 0 to load PWM and enable data
0x17
Reset: write 0 to restore the defaults
Channel map
LED
Outputs (R, G, B)
PWM registers
RGB1
OUT1-OUT3
0x01-0x03
RGB2
OUT4-OUT6
0x04-0x06
RGB3
OUT7-OUT9
0x07-0x09
RGB4
OUT10-OUT12
0x0A-0x0C
RGB5
OUT13-OUT15
0x0D-0x0F
RGB6
OUT16-OUT18
0x10-0x12

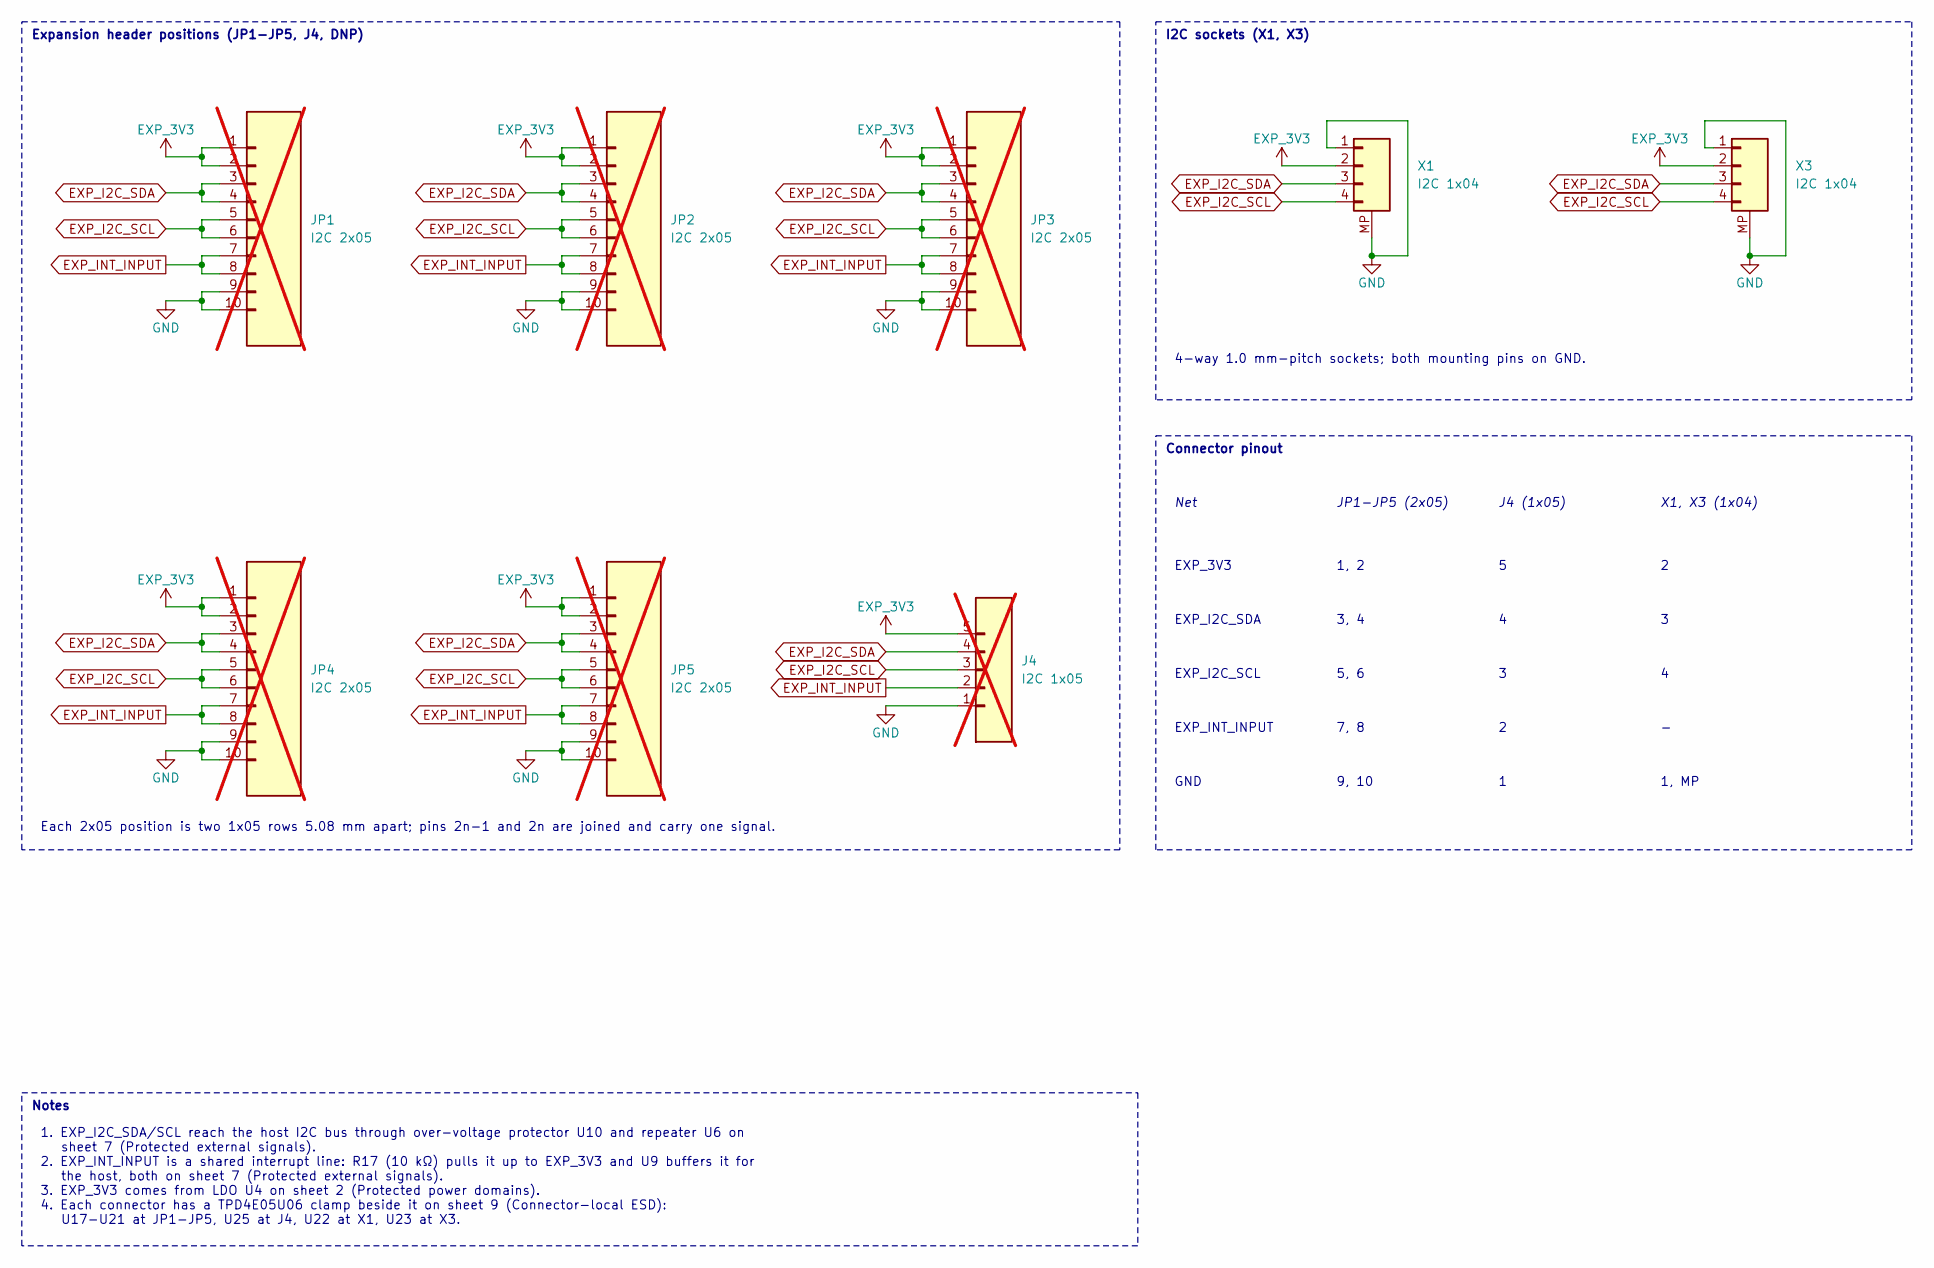
[picture p70: schematic expansion.kicad_sch, Keel R3 / Fixed expansion connectors]

Parts:
J4: I2C 1x05; PinHeader_1x05_P2.54mm_Vertical; not fitted
JP1, JP2, JP3, JP4, JP5: I2C 2x05; PinHeader_2x05_Row5.08_DNP; not fitted
X1, X3: I2C 1x04; JST_SH_BM04B-SRSS-TB_1x04-1MP_P1.00mm_Vertical; MPN BM04B-SRSS-TB

Connections:
EXP_3V3: J4.5, JP1.1, JP1.2, JP2.1, JP2.2, JP3.1, JP3.2, JP4.1, JP4.2, JP5.1, JP5.2, X1.2, X3.2; also elsewhere on the board
EXP_I2C_SCL: J4.3, JP1.5, JP1.6, JP2.5, JP2.6, JP3.5, JP3.6, JP4.5, JP4.6, JP5.5, JP5.6, X1.4, X3.4; also elsewhere on the board
EXP_I2C_SDA: J4.4, JP1.3, JP1.4, JP2.3, JP2.4, JP3.3, JP3.4, JP4.3, JP4.4, JP5.3, JP5.4, X1.3, X3.3; also elsewhere on the board
EXP_INT_INPUT: J4.2, JP1.7, JP1.8, JP2.7, JP2.8, JP3.7, JP3.8, JP4.7, JP4.8, JP5.7, JP5.8; also elsewhere on the board
GND: J4.1, JP1.9, JP1.10, JP2.9, JP2.10, JP3.9, JP3.10, JP4.9, JP4.10, JP5.9, JP5.10, X1.1, X1.MP (mounts), X3.1, X3.MP (mounts); also elsewhere on the board

Notes on the sheet:
Expansion header positions (JP1-JP5, J4, DNP)
Each 2x05 position is two 1x05 rows 5.08 mm apart; pins 2n-1 and 2n are joined and carry one signal.
I2C sockets (X1, X3)
4-way 1.0 mm-pitch sockets; both mounting pins on GND.
Connector pinout
Net
JP1-JP5 (2x05)
J4 (1x05)
X1, X3 (1x04)
EXP_3V3
1, 2
EXP_I2C_SDA
3, 4
EXP_I2C_SCL
5, 6
EXP_INT_INPUT
7, 8
GND
9, 10
1, MP
Notes
1. EXP_I2C_SDA/SCL reach the host I2C bus through over-voltage protector U10 and repeater U6 on sheet 7 (Protected external signals). 2. EXP_INT_INPUT is a shared interrupt line: R17 (10 kΩ) pulls it up to EXP_3V3 and U9 buffers it for the host, both on sheet 7 (Protected external signals). 3. EXP_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

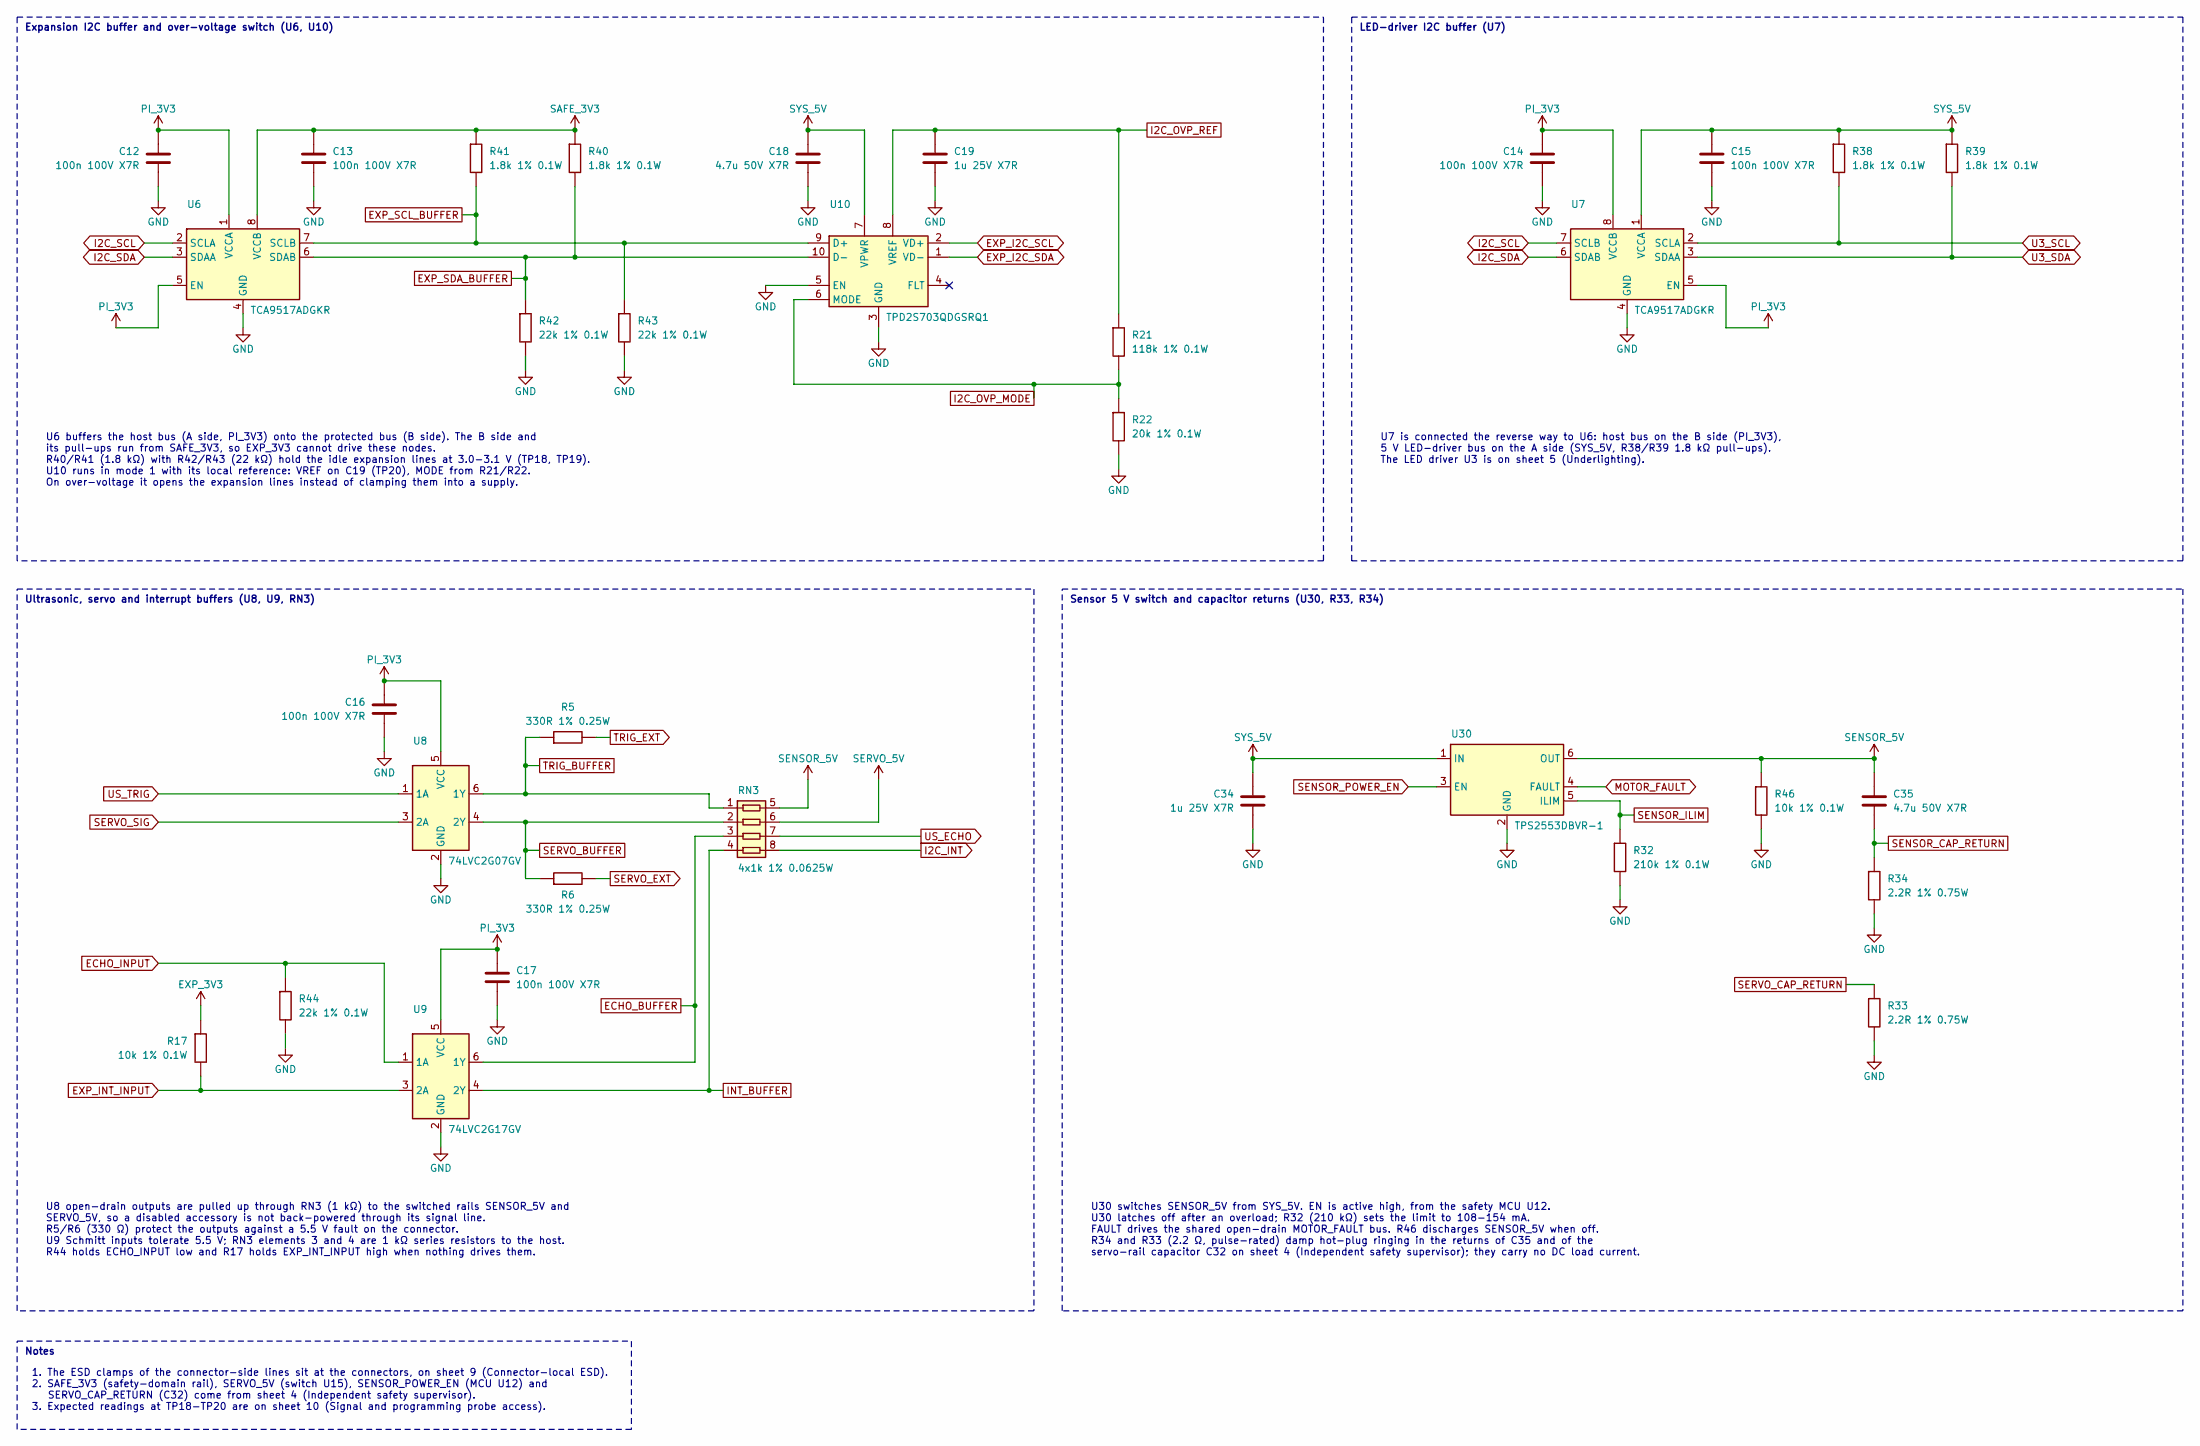
[picture p71: schematic interfaces.kicad_sch, Keel R3 / Protected external signals]

Parts:
C12, C13, C14, C15, C16, C17: 100n 100V X7R; C_0603_1608Metric; MPN GRM188R72A104KA35D
C18, C35: 4.7u 50V X7R; C_1206_3216Metric; MPN GRM31CR71H475KA12L
C19, C34: 1u 25V X7R; C_0805_2012Metric; MPN GRM219R71E105KA88D
R5, R6: 330R 1% 0.25W; R_1206_3216Metric; MPN RC1206FR-07330RL
R17, R46: 10k 1% 0.1W; R_0603_1608Metric; MPN RC0603FR-0710KL
R21: 118k 1% 0.1W; R_0603_1608Metric; MPN RC0603FR-07118KL
R22: 20k 1% 0.1W; R_0603_1608Metric; MPN RC0603FR-0720KL
R32: 210k 1% 0.1W; R_0603_1608Metric; MPN RC0603FR-07210KL
R33, R34: 2.2R 1% 0.75W; R_1206_3216Metric; MPN CRCW12062R20FKEAHP
R38, R39, R40, R41: 1.8k 1% 0.1W; R_0603_1608Metric; MPN RC0603FR-071K8L
R42, R43, R44: 22k 1% 0.1W; R_0603_1608Metric; MPN RC0603FR-0722KL
RN3: 4x1k 1% 0.0625W; YC164_4x0603; MPN YC164-FR-071KL
U6, U7: TCA9517ADGKR; VSSOP-8_3x3mm_P0.65mm; MPN TCA9517ADGKR
U8: 74LVC2G07GV; Nexperia_SOT457_SC74_1.5x2.9mm_P0.95mm; MPN 74LVC2G07GV,125
U9: 74LVC2G17GV; Nexperia_SOT457_SC74_1.5x2.9mm_P0.95mm; MPN 74LVC2G17GV,125
U10: TPD2S703QDGSRQ1; MSOP-10_3x3mm_P0.5mm; MPN TPD2S703QDGSRQ1
U30: TPS2553DBVR-1; SOT-23-6; MPN TPS2553DBVR-1

Connections:
ECHO_BUFFER: RN3.3, U9.6 (1Y)
ECHO_INPUT: R44.1, U9.1 (1A); also elsewhere on the board
EXP_3V3: R17.1; also elsewhere on the board
EXP_I2C_SCL: U10.2 (VD+); also elsewhere on the board
EXP_I2C_SDA: U10.1 (VD-); also elsewhere on the board
EXP_INT_INPUT: R17.2, U9.3 (2A); also elsewhere on the board
EXP_SCL_BUFFER: R41.2, R43.1, U6.7 (SCLB), U10.9 (D+)
EXP_SDA_BUFFER: R40.2, R42.1, U6.6 (SDAB), U10.10 (D-)
GND: C12.2, C13.2, C14.2, C15.2, C16.2, C17.2, C18.2, C19.2, C34.2, R22.2, R32.2, R33.2, R34.2, R42.2, R43.2, R44.2, R46.2, U6.4 (GND), U7.4 (GND), U8.2 (GND), U9.2 (GND), U10.3 (GND), U10.5 (EN), U30.2 (GND); also elsewhere on the board
I2C_INT: RN3.8; also elsewhere on the board
I2C_OVP_MODE: R21.2, R22.1, U10.6 (MODE)
I2C_OVP_REF: C19.1, R21.1, U10.8 (VREF); also elsewhere on the board
I2C_SCL: U6.2 (SCLA), U7.7 (SCLB); also elsewhere on the board
I2C_SDA: U6.3 (SDAA), U7.6 (SDAB); also elsewhere on the board
INT_BUFFER: RN3.4, U9.4 (2Y)
MOTOR_FAULT: U30.4 (FAULT); also elsewhere on the board
PI_3V3: C12.1, C14.1, C16.1, C17.1, U6.1 (VCCA), U6.5 (EN), U7.5 (EN), U7.8 (VCCB), U8.5 (VCC), U9.5 (VCC); also elsewhere on the board
SAFE_3V3: C13.1, R40.1, R41.1, U6.8 (VCCB); also elsewhere on the board
SENSOR_5V: C35.1, R46.1, RN3.5, U30.6 (OUT); also elsewhere on the board
SENSOR_CAP_RETURN: C35.2, R34.1
SENSOR_ILIM: R32.1, U30.5 (ILIM)
SENSOR_POWER_EN: U30.3 (EN); also elsewhere on the board
SERVO_5V: RN3.6; also elsewhere on the board
SERVO_BUFFER: R6.1, RN3.2, U8.4 (2Y)
SERVO_CAP_RETURN: R33.1; also elsewhere on the board
SERVO_EXT: R6.2; also elsewhere on the board
SERVO_SIG: U8.3 (2A); also elsewhere on the board
SYS_5V: C15.1, C18.1, C34.1, R38.1, R39.1, U7.1 (VCCA), U10.7 (VPWR), U30.1 (IN); also elsewhere on the board
TRIG_BUFFER: R5.1, RN3.1, U8.6 (1Y)
TRIG_EXT: R5.2; also elsewhere on the board
U3_SCL: R38.2, U7.2 (SCLA); also elsewhere on the board
U3_SDA: R39.2, U7.3 (SDAA); also elsewhere on the board
US_ECHO: RN3.7; also elsewhere on the board
US_TRIG: U8.1 (1A); also elsewhere on the board

Notes on the sheet:
U6 buffers the host bus (A side, PI_3V3) onto the protected bus (B side). The B side and its pull-ups run from SAFE_3V3, so EXP_3V3 cannot drive these nodes. R40/R41 (1.8 kΩ) with R42/R43 (22 kΩ) hold the idle expansion lines at 3.0-3.1 V (TP18, TP19). U10 runs in mode 1 with its local reference: V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
Expansion I2C buffer and over-voltage switch (U6, U10)
U7 is connected the reverse way to U6: host bus on the B side (PI_3V3), 5 V LED-driver bus on the A side (SYS_5V, R38/R39 1.8 kΩ pull-ups). The LED driver U3 is on sheet 5 (Underlighting).
LED-driver I2C buffer (U7)
U8 open-drain outputs are pulled up through RN3 (1 kΩ) to the switched rails SENSOR_5V and SERVO_5V, so a disabled accessory is not back-powered through its signal line. R5/R6 (330 Ω) protect the outputs against a 5.5 V fault on the connector. U9 Schmitt inputs tolerate 5.5 V; RN3 elements 3 and 4 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
Ultrasonic, servo and interrupt buffers (U8, U9, RN3)
U30 switches SENSOR_5V from SYS_5V. EN is active high, from the safety MCU U12. U30 latches off after an overload; R32 (210 kΩ) sets the limit to 108-154 mA. FAULT drives the shared open-drain MOTOR_FAULT bus. R46 discharges SENSOR_5V when off. R34 and R33 (2.2 Ω, pulse-rated) damp hot-plug ringing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
Sensor 5 V switch and capacitor returns (U30, R33, R34)
Notes
1. The ESD clamps of the connector-side lines sit at the connectors, on sheet 9 (Connector-local ESD). 2. SAFE_3V3 (safety-domain rail), SERVO_5V (switch U15), SENSOR_POWER_EN (MCU U12) and SERVO_CAP_RETURN (C32) come from sheet 4 (Independent safety supervisor). 3. Expected readings at TP18-TP20 a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

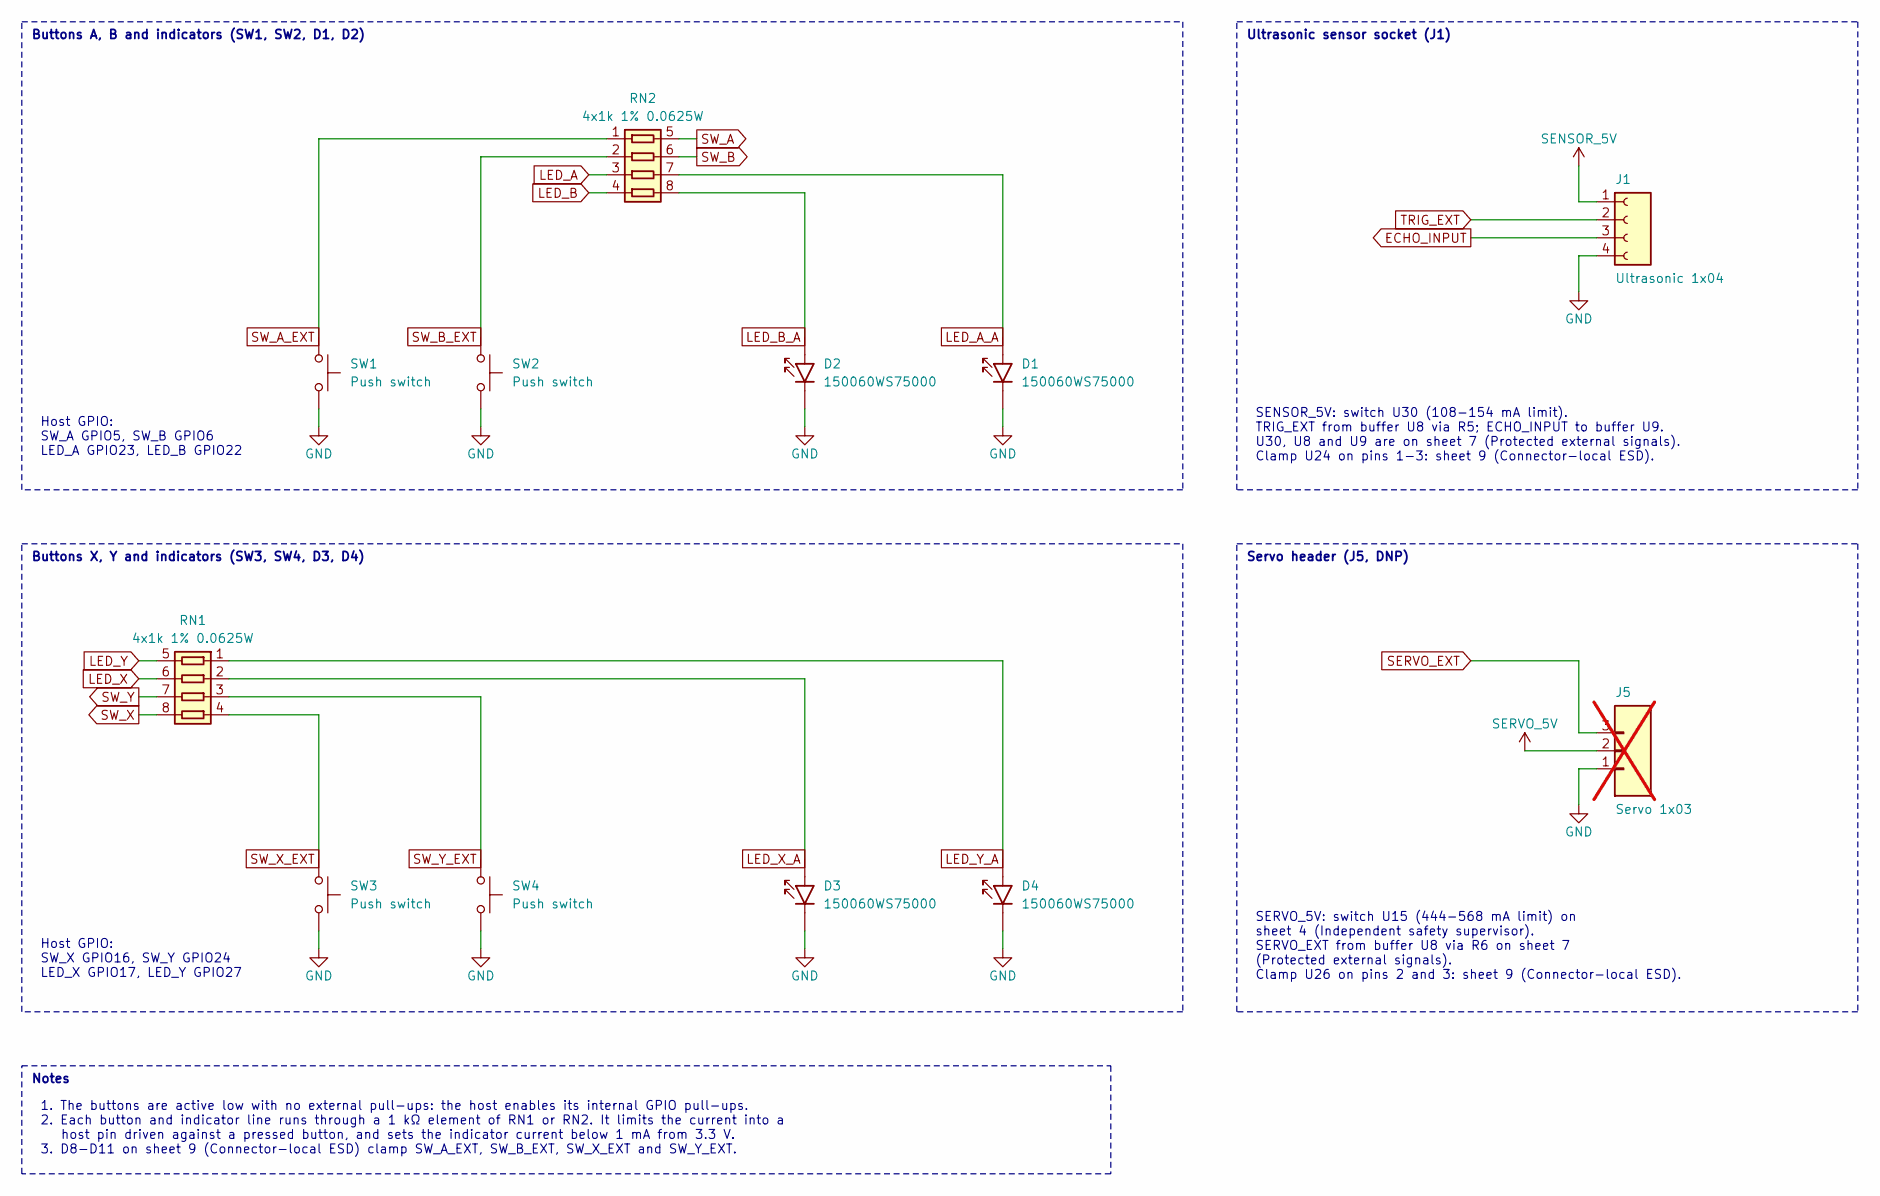
[picture p72: schematic user_io.kicad_sch, Keel R3 / Buttons and indicators]

Parts:
D1, D2, D3, D4: 150060WS75000; LED_0603_1608Metric; MPN 150060WS75000
J1: Ultrasonic 1x04; PinSocket_1x04_P2.54mm_Vertical; MPN SSW-104-01-G-S
J5: Servo 1x03; PinHeader_1x03_P2.54mm_Vertical; not fitted
RN1, RN2: 4x1k 1% 0.0625W; YC164_4x0603; MPN YC164-FR-071KL
SW1, SW2, SW3, SW4: Push switch; SW_SPST_PTS645Sx43SMTR92; MPN PTS645SM43SMTR92

Connections:
ECHO_INPUT: J1.3; also elsewhere on the board
GND: D1.1 (K), D2.1 (K), D3.1 (K), D4.1 (K), J1.4, J5.1, SW1.2 (ground), SW2.2 (ground), SW3.2 (ground), SW4.2 (ground); also elsewhere on the board
LED_A: RN2.3; also elsewhere on the board
LED_A_A: D1.2 (A), RN2.7
LED_B: RN2.4; also elsewhere on the board
LED_B_A: D2.2 (A), RN2.8
LED_X: RN1.6; also elsewhere on the board
LED_X_A: D3.2 (A), RN1.2
LED_Y: RN1.5; also elsewhere on the board
LED_Y_A: D4.2 (A), RN1.1
SENSOR_5V: J1.1; also elsewhere on the board
SERVO_5V: J5.2; also elsewhere on the board
SERVO_EXT: J5.3; also elsewhere on the board
SW_A: RN2.5; also elsewhere on the board
SW_A_EXT: RN2.1, SW1.1 (contact); also elsewhere on the board
SW_B: RN2.6; also elsewhere on the board
SW_B_EXT: RN2.2, SW2.1 (contact); also elsewhere on the board
SW_X: RN1.8; also elsewhere on the board
SW_X_EXT: RN1.4, SW3.1 (contact); also elsewhere on the board
SW_Y: RN1.7; also elsewhere on the board
SW_Y_EXT: RN1.3, SW4.1 (contact); also elsewhere on the board
TRIG_EXT: J1.2; also elsewhere on the board

Notes on the sheet:
Buttons A, B and indicators (SW1, SW2, D1, D2)
Buttons X, Y and indicators (SW3, SW4, D3, D4)
Ultrasonic sensor socket (J1)
Servo header (J5, DNP)
Host GPIO: SW_A GPIO5, SW_B GPIO6 LED_A GPIO23, LED_B GPIO22
Host GPIO: SW_X GPIO16, SW_Y GPIO24 LED_X GPIO17, LED_Y GPIO27
SENSOR_5V: switch U30 (108-154 mA limit). TRIG_EXT from buffer U8 via R5; ECHO_INPUT to buffer U9. U30, U8 and U9 are on sheet 7 (Protected external signals). Clamp U24 on pins 1-3: sheet 9 (Connector-local ESD).
SERVO_5V: switch U15 (444-568 mA limit) on sheet 4 (Independent safety supervisor). SERVO_EXT from buffer U8 via R6 on sheet 7 (Protected external signals). Clamp U26 on pins 2 and 3: sheet 9 (Connector-local ESD).
Notes
1. The buttons are active low with no external pull-ups: the host enables its internal GPIO pull-ups. 2. Each button and indicator line runs through a 1 kΩ element of RN1 or RN2. It limits the current into a host pin driven against a pressed button, and sets the indicator current below 1 mA from 3.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

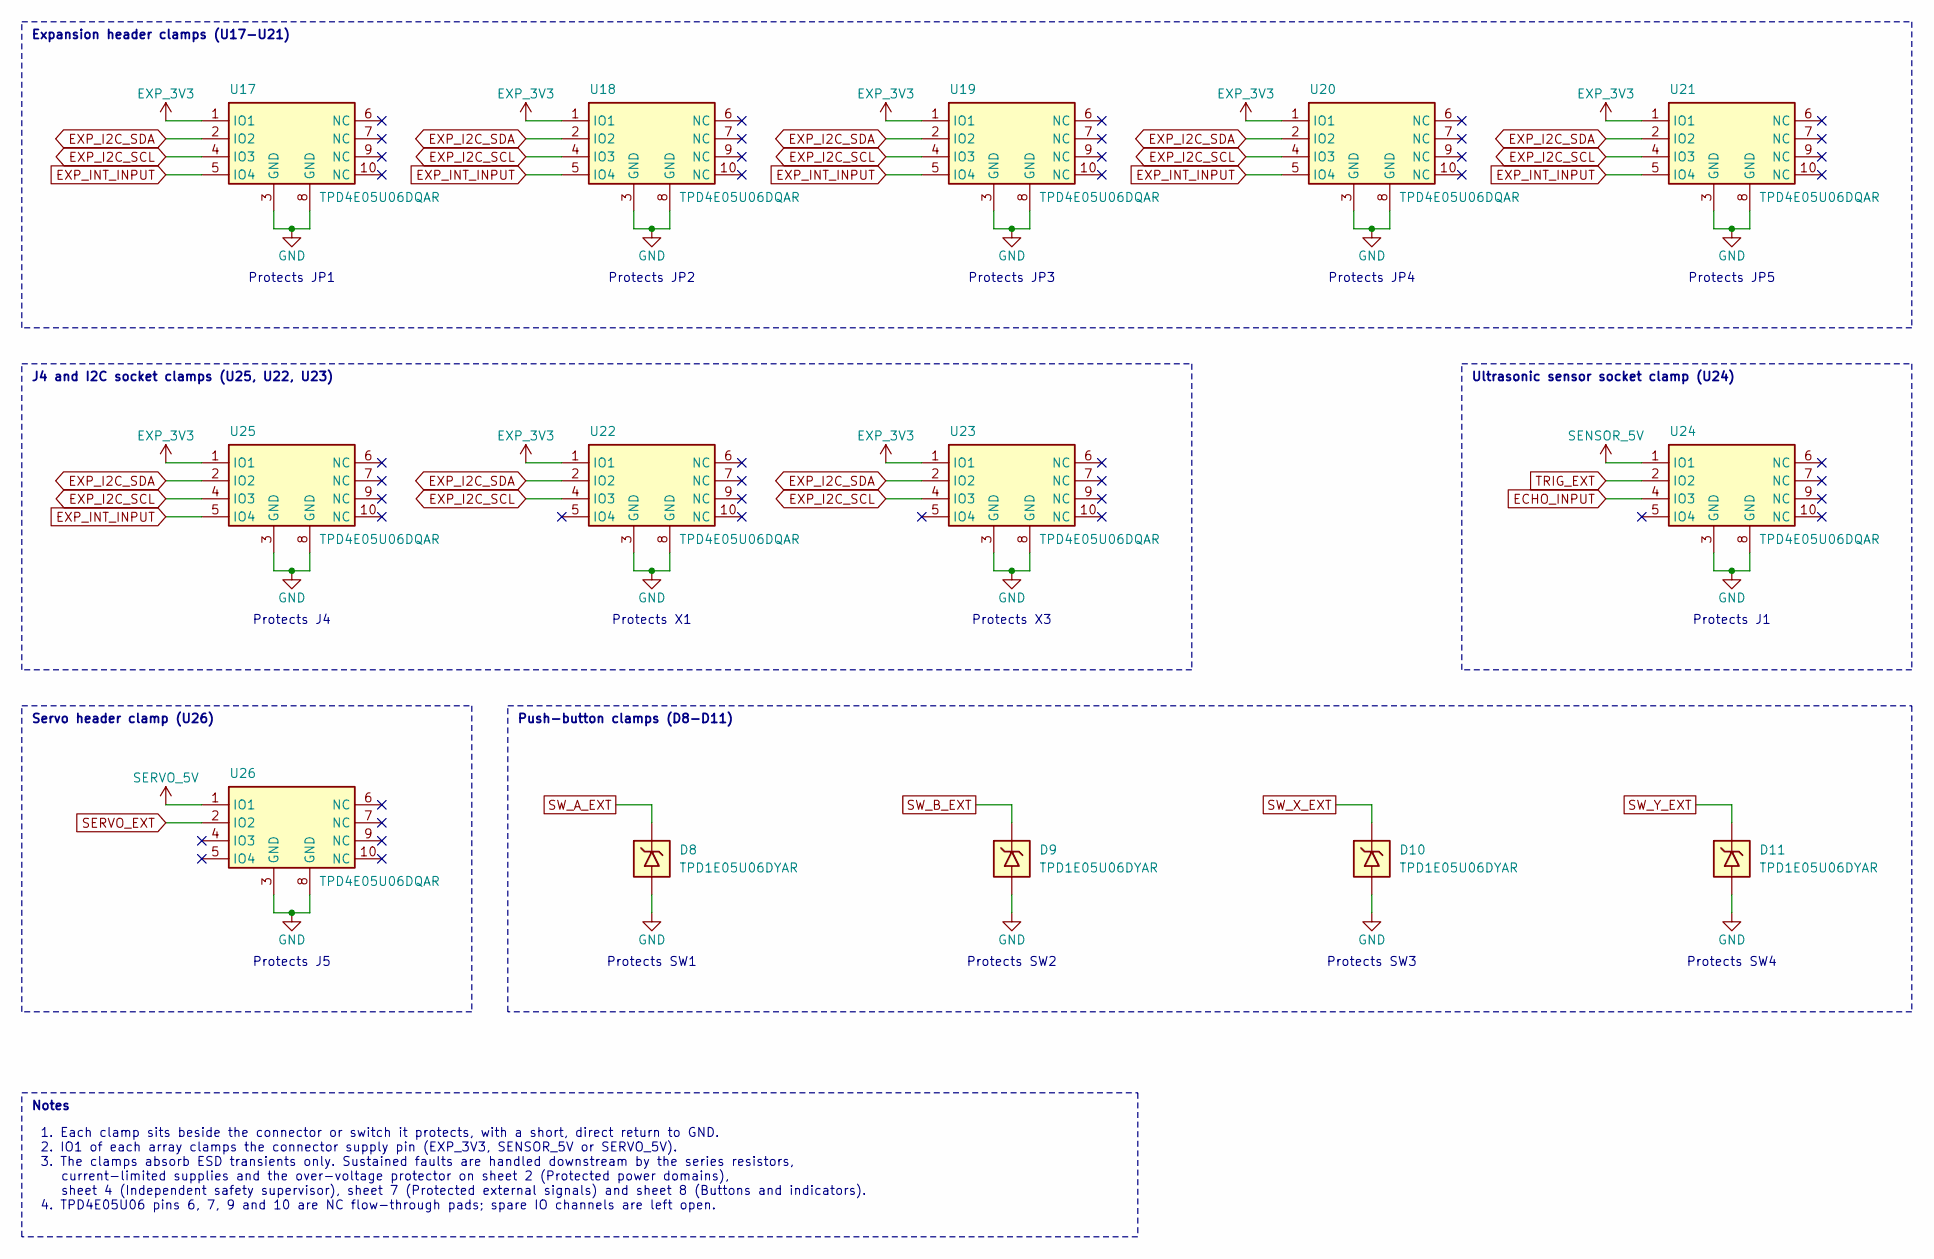
[picture p73: schematic esd.kicad_sch, Keel R3 / Connector-local ESD]

Parts:
D8, D9, D10, D11: TPD1E05U06DYAR; TI_DYA0002A_TPD1E05U06_SOD523; MPN TPD1E05U06DYAR
U17, U18, U19, U20, U21, U22, U23, U24, U25, U26: TPD4E05U06DQAR; TI_DQA0010A_TPD4E05U06_AB_Compatible_CommonMask; MPN TPD4E05U06DQAR

Connections:
ECHO_INPUT: U24.4 (IO4); also elsewhere on the board
EXP_3V3: U17.1 (IO1), U18.1 (IO1), U19.1 (IO1), U20.1 (IO1), U21.1 (IO1), U22.1 (IO1), U23.1 (IO1), U25.1 (IO1); also elsewhere on the board
EXP_I2C_SCL: U17.4 (IO4), U18.4 (IO4), U19.4 (IO4), U20.4 (IO4), U21.4 (IO4), U22.4 (IO4), U23.4 (IO4), U25.4 (IO4); also elsewhere on the board
EXP_I2C_SDA: U17.2 (IO2), U18.2 (IO2), U19.2 (IO2), U20.2 (IO2), U21.2 (IO2), U22.2 (IO2), U23.2 (IO2), U25.2 (IO2); also elsewhere on the board
EXP_INT_INPUT: U17.5 (IO5), U18.5 (IO5), U19.5 (IO5), U20.5 (IO5), U21.5 (IO5), U25.5 (IO5); also elsewhere on the board
GND: D8.2 (GND), D9.2 (GND), D10.2 (GND), D11.2 (GND), U17.3 (GND), U17.8 (GND), U18.3 (GND), U18.8 (GND), U19.3 (GND), U19.8 (GND), U20.3 (GND), U20.8 (GND), U21.3 (GND), U21.8 (GND), U22.3 (GND), U22.8 (GND), U23.3 (GND), U23.8 (GND), U24.3 (GND), U24.8 (GND), U25.3 (GND), U25.8 (GND), U26.3 (GND), U26.8 (GND); also elsewhere on the board
SENSOR_5V: U24.1 (IO1); also elsewhere on the board
SERVO_5V: U26.1 (IO1); also elsewhere on the board
SERVO_EXT: U26.2 (IO2); also elsewhere on the board
SW_A_EXT: D8.1 (IO1); also elsewhere on the board
SW_B_EXT: D9.1 (IO1); also elsewhere on the board
SW_X_EXT: D10.1 (IO1); also elsewhere on the board
SW_Y_EXT: D11.1 (IO1); also elsewhere on the board
TRIG_EXT: U24.2 (IO2); also elsewhere on the board

Notes on the sheet:
Protects JP1
Protects JP2
Protects JP3
Protects JP4
Protects JP5
Expansion header clamps (U17-U21)
Protects J4
Protects X1
Protects X3
J4 and I2C socket clamps (U25, U22, U23)
Protects J1
Ultrasonic sensor socket clamp (U24)
Protects J5
Servo header clamp (U26)
Protects SW1
Protects SW2
Protects SW3
Protects SW4
Push-button clamps (D8-D11)
Notes
1. Each clamp sits beside the connector or switch it protects, with a short, direct return to GND. 2. IO1 of each array clamps the connector supply pin (EXP_3V3, SENSOR_5V or SERVO_5V). 3. The clamps absorb ESD transients only. Sustained faults are handled downstream by the series resistors, curren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
