BisocMOrg/Keel/hardware/kicad/Keel.kicad_pcb

## KiCad design hardware/kicad/Keel.kicad_pcb (continued)

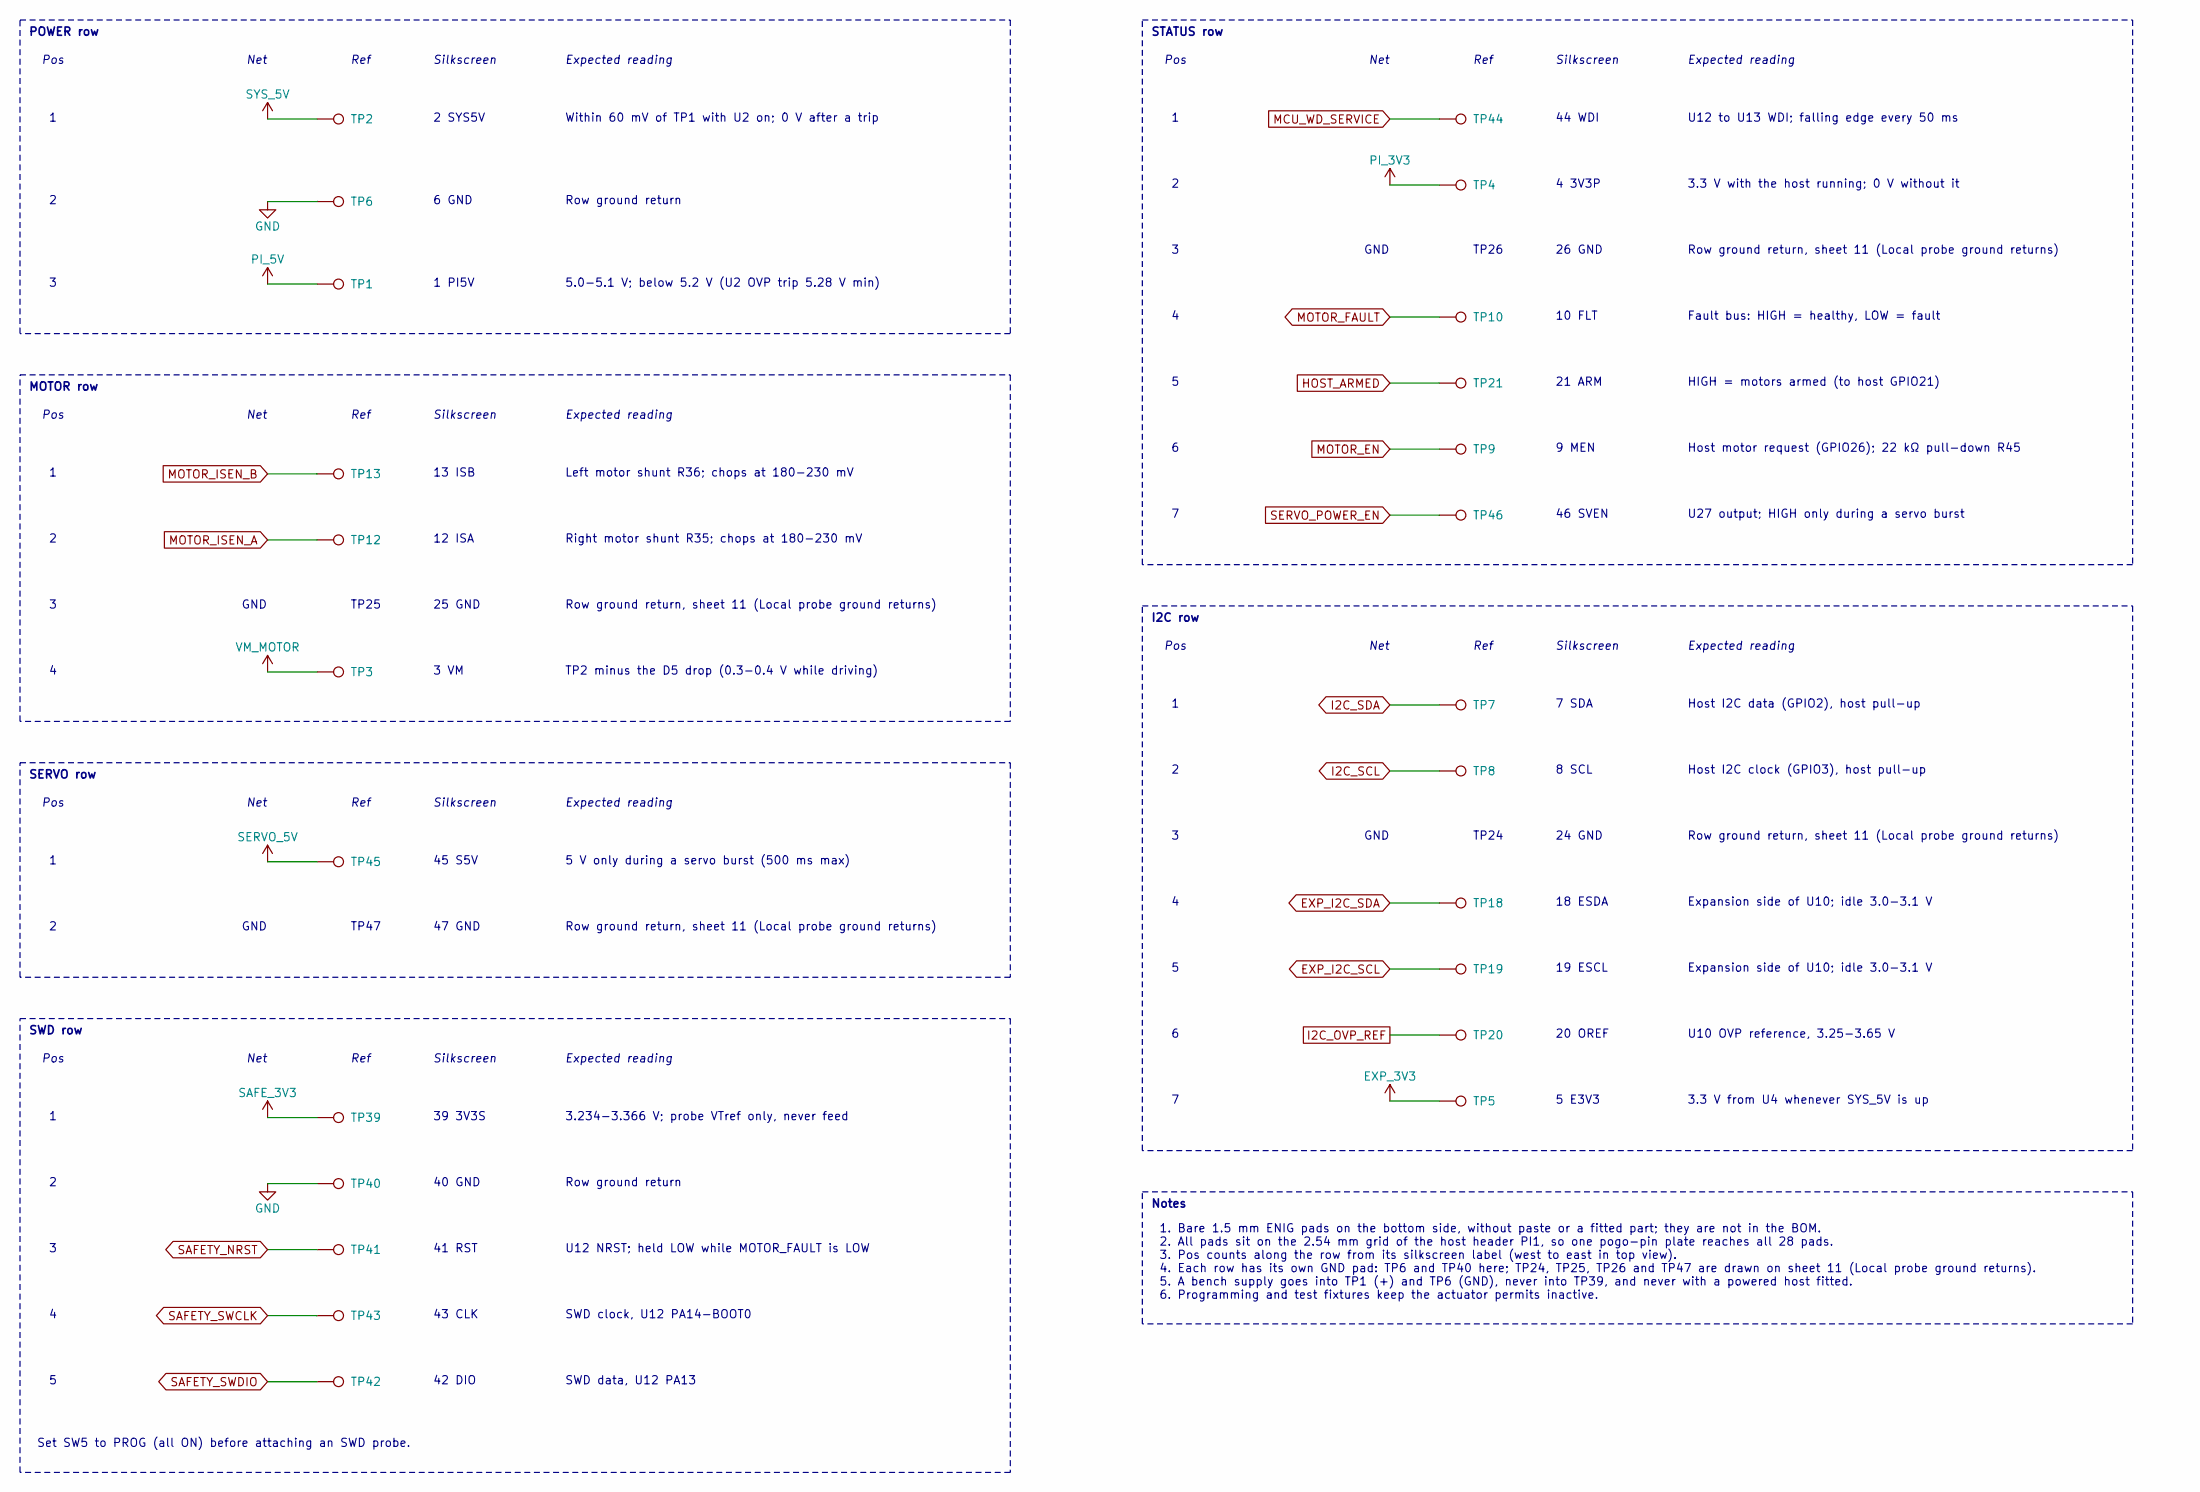
[picture p74: schematic testpoints.kicad_sch, Keel R3 / Signal and programming probe access]

Parts:
TP1: PI_5V; TestPoint_Pad_D1.5mm; MPN BARE PCB PAD - NO FITTED PART
TP2: SYS_5V; TestPoint_Pad_D1.5mm; MPN BARE PCB PAD - NO FITTED PART
TP3: VM_MOTOR; TestPoint_Pad_D1.5mm; MPN BARE PCB PAD - NO FITTED PART
TP4: PI_3V3; TestPoint_Pad_D1.5mm; MPN BARE PCB PAD - NO FITTED PART
TP5: EXP_3V3; TestPoint_Pad_D1.5mm; MPN BARE PCB PAD - NO FITTED PART
TP6, TP40: GND; TestPoint_Pad_D1.5mm; MPN BARE PCB PAD - NO FITTED PART
TP7: I2C_SDA; TestPoint_Pad_D1.5mm; MPN BARE PCB PAD - NO FITTED PART
TP8: I2C_SCL; TestPoint_Pad_D1.5mm; MPN BARE PCB PAD - NO FITTED PART
TP9: MOTOR_EN; TestPoint_Pad_D1.5mm; MPN BARE PCB PAD - NO FITTED PART
TP10: MOTOR_FAULT; TestPoint_Pad_D1.5mm; MPN BARE PCB PAD - NO FITTED PART
TP12: MOTOR_ISEN_A; TestPoint_Pad_D1.5mm; MPN BARE PCB PAD - NO FITTED PART
TP13: MOTOR_ISEN_B; TestPoint_Pad_D1.5mm; MPN BARE PCB PAD - NO FITTED PART
TP18: EXP_I2C_SDA; TestPoint_Pad_D1.5mm; MPN BARE PCB PAD - NO FITTED PART
TP19: EXP_I2C_SCL; TestPoint_Pad_D1.5mm; MPN BARE PCB PAD - NO FITTED PART
TP20: I2C_OVP_REF; TestPoint_Pad_D1.5mm; MPN BARE PCB PAD - NO FITTED PART
TP21: HOST_ARMED; TestPoint_Pad_D1.5mm; MPN BARE PCB PAD - NO FITTED PART
TP39: SAFE_3V3; TestPoint_Pad_D1.5mm; MPN BARE PCB PAD - NO FITTED PART
TP41: SAFETY_NRST; TestPoint_Pad_D1.5mm; MPN BARE PCB PAD - NO FITTED PART
TP42: SAFETY_SWDIO; TestPoint_Pad_D1.5mm; MPN BARE PCB PAD - NO FITTED PART
TP43: SAFETY_SWCLK; TestPoint_Pad_D1.5mm; MPN BARE PCB PAD - NO FITTED PART
TP44: MCU_WD_SERVICE; TestPoint_Pad_D1.5mm; MPN BARE PCB PAD - NO FITTED PART
TP45: SERVO_5V; TestPoint_Pad_D1.5mm; MPN BARE PCB PAD - NO FITTED PART
TP46: SERVO_POWER_EN; TestPoint_Pad_D1.5mm; MPN BARE PCB PAD - NO FITTED PART

Connections:
EXP_3V3: TP5.1 (1_1); also elsewhere on the board
EXP_I2C_SCL: TP19.1 (1_1); also elsewhere on the board
EXP_I2C_SDA: TP18.1 (1_1); also elsewhere on the board
GND: TP6.1 (1_1), TP40.1 (1_1); also elsewhere on the board
HOST_ARMED: TP21.1 (1_1); also elsewhere on the board
I2C_OVP_REF: TP20.1 (1_1); also elsewhere on the board
I2C_SCL: TP8.1 (1_1); also elsewhere on the board
I2C_SDA: TP7.1 (1_1); also elsewhere on the board
MCU_WD_SERVICE: TP44.1 (1_1); also elsewhere on the board
MOTOR_EN: TP9.1 (1_1); also elsewhere on the board
MOTOR_FAULT: TP10.1 (1_1); also elsewhere on the board
MOTOR_ISEN_A: TP12.1 (1_1); also elsewhere on the board
MOTOR_ISEN_B: TP13.1 (1_1); also elsewhere on the board
PI_3V3: TP4.1 (1_1); also elsewhere on the board
PI_5V: TP1.1 (1_1); also elsewhere on the board
SAFETY_NRST: TP41.1 (1_1); also elsewhere on the board
SAFETY_SWCLK: TP43.1 (1_1); also elsewhere on the board
SAFETY_SWDIO: TP42.1 (1_1); also elsewhere on the board
SAFE_3V3: TP39.1 (1_1); also elsewhere on the board
SERVO_5V: TP45.1 (1_1); also elsewhere on the board
SERVO_POWER_EN: TP46.1 (1_1); also elsewhere on the board
SYS_5V: TP2.1 (1_1); also elsewhere on the board
VM_MOTOR: TP3.1 (1_1); also elsewhere on the board

Notes on the sheet:
Pos
Net
Ref
Silkscreen
Expected reading
2 SYS5V
Within 60 mV of TP1 with U2 on; 0 V after a trip
6 GND
Row ground return
1 PI5V
5.0-5.1 V; below 5.2 V (U2 OVP trip 5.28 V min)
POWER row
13 ISB
Left motor shunt R36; chops at 180-230 mV
12 ISA
Right motor shunt R35; chops at 180-230 mV
GND
TP25
25 GND
Row ground return, sheet 11 (Local probe ground returns)
3 VM
TP2 minus the D5 drop (0.3-0.4 V while driving)
MOTOR row
45 S5V
5 V only during a servo burst (500 ms max)
TP47
47 GND
SERVO row
39 3V3S
3.234-3.366 V; probe VTref only, never feed
40 GND
41 RST
U12 NRST; held LOW while MOTOR_FAULT is LOW
43 CLK
SWD clock, U12 PA14-BOOT0
42 DIO
SWD data, U12 PA13
Set SW5 to PROG (all ON) before attaching an SWD probe.
SWD row
44 WDI
U12 to U13 WDI; falling edge every 50 ms
4 3V3P
3.3 V with the host running; 0 V without it
TP26
26 GND
10 FLT
Fault bus: HIGH = healthy, LOW = fault
21 ARM
HIGH = motors armed (to host GPIO21)
9 MEN
Host motor request (GPIO26); 22 kΩ pull-down R45
46 SVEN
U27 output; HIGH only during a servo burst
STATUS row
7 SDA
Host I2C data (GPIO2), host pull-up
8 SCL
Host I2C clock (GPIO3), host pull-up
TP24
24 GND
18 ESDA
Expansion side of U10; idle 3.0-3.1 V
19 ESCL
20 OREF
U10 OVP reference, 3.25-3.65 V
5 E3V3
3.3 V from U4 whenever SYS_5V is up
I2C row
Notes
1. Bare 1.5 mm ENIG pads on the bottom side, without paste or a fitted part; they are not in the BOM. 2. All pads sit on the 2.54 mm grid of the host header PI1, so one pogo-pin plate reaches all 28 pads. 3. Pos counts along the row from its silkscreen label (west to east in top view). 4. Each row 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

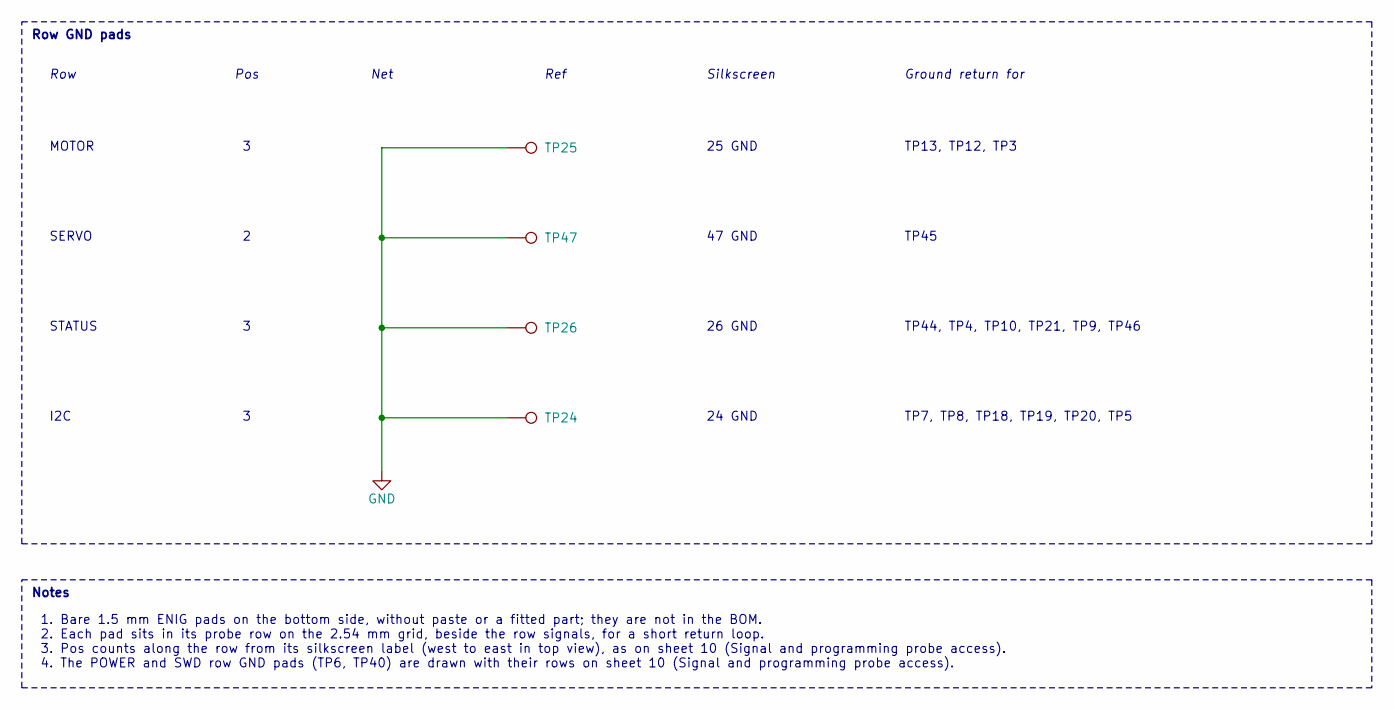
[picture p75: schematic ground_probes.kicad_sch, Keel R3 / Local probe ground returns]

Parts:
TP24, TP25, TP26, TP47: GND; TestPoint_Pad_D1.5mm; MPN BARE PCB PAD - NO FITTED PART

Connections:
GND: TP24.1 (1_1), TP25.1 (1_1), TP26.1 (1_1), TP47.1 (1_1); also elsewhere on the board

Notes on the sheet:
Row
Pos
Net
Ref
Silkscreen
Ground return for
MOTOR
25 GND
TP13, TP12, TP3
SERVO
47 GND
TP45
STATUS
26 GND
TP44, TP4, TP10, TP21, TP9, TP46
I2C
24 GND
TP7, TP8, TP18, TP19, TP20, TP5
Row GND pads
Notes
1. Bare 1.5 mm ENIG pads on the bottom side, without paste or a fitted part; they are not in the BOM. 2. Each pad sits in its probe row on the 2.54 mm grid, beside the row signals, for a short return loop. 3. Pos counts along the row from its silkscreen label (west to east in top view), as on sheet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

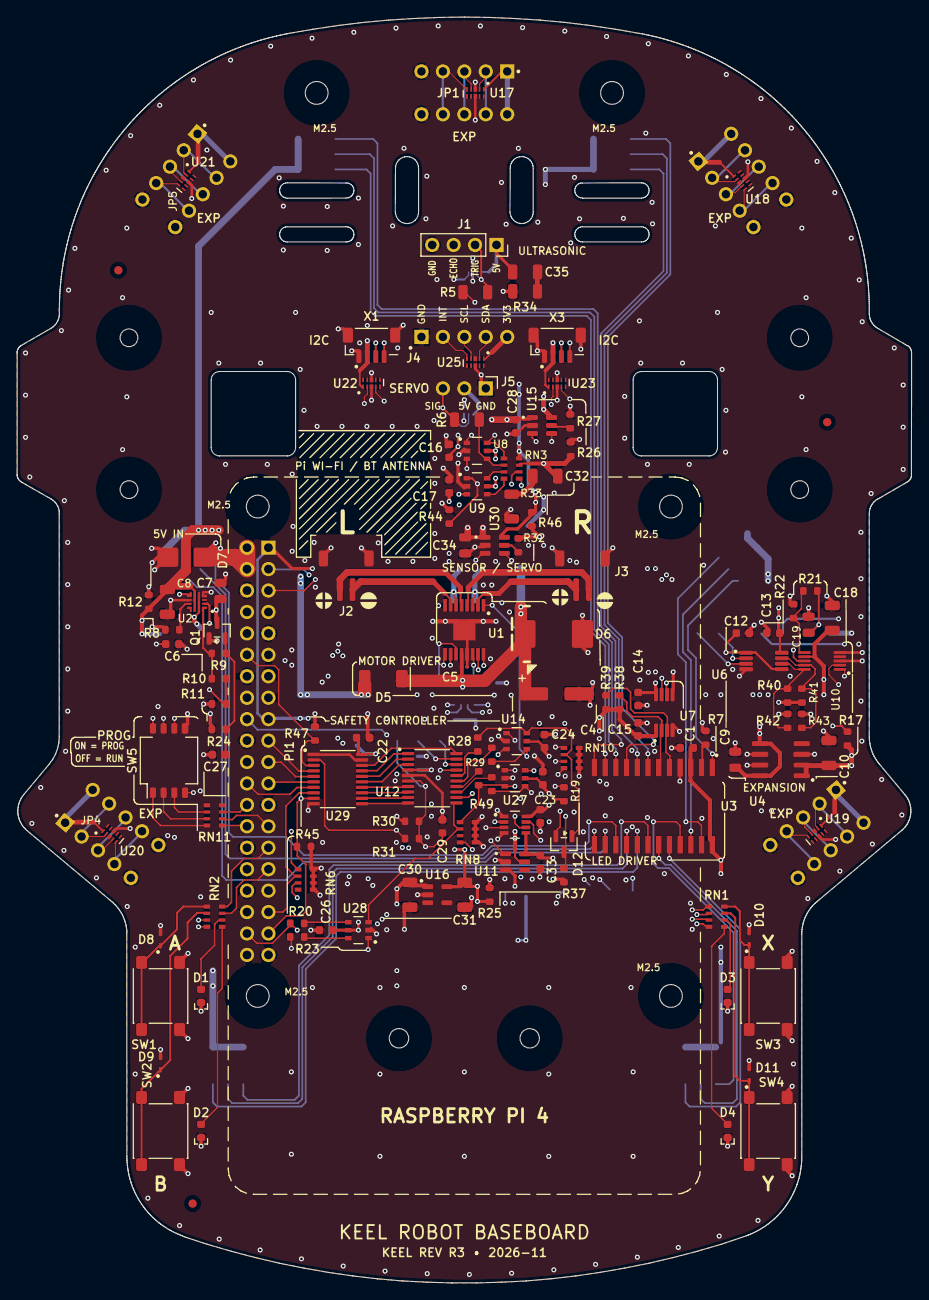
[picture p76: board Keel.kicad_pcb from above]

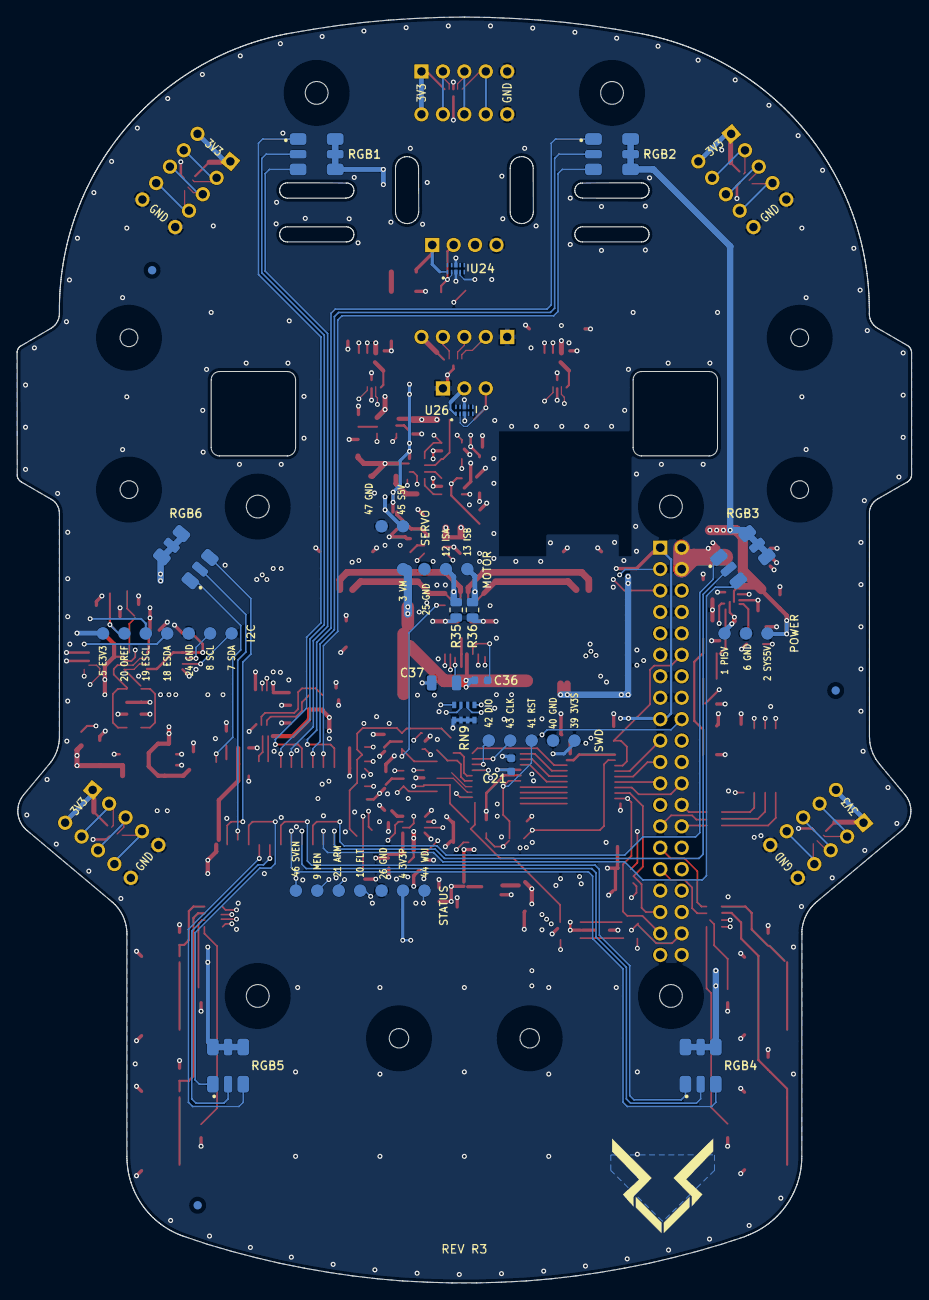
[picture p77: board Keel.kicad_pcb from below]

Board: 6 copper layers, 106.0 x 150.0 mm, 193 parts (45 on the bottom side), 124 nets.

Other parts of the board:
FID1, FID2, FID3, FID4, FID5, FID6: Fiducial; Fiducial_1mm_Mask2mm
H1, H2: MountingHole_2.3mm_NPTH
H3, H5: MountingHole_2.7mm_NPTH_PiHeaderClip
H4, H6, H11, H12: MountingHole_2.7mm_NPTH
H7, H8, H9, H10: MountingHole_2.1mm_NPTH
