BisocMOrg/Keel/software/libkeel/src/core/internal.h

/* SPDX-License-Identifier: MIT */
/* Copyright (c) 2026 BisocM */
/**
 * @file internal.h
 * @brief Private declarations shared by the portable core modules.
 *
 * The core is portable C11: it makes no system calls, allocates nothing and
 * creates no threads. Clocks, sleeps, locks and thread ids come from the
 * backend table (port.h); the handle registry's lock comes from src/os.
 *
 * Lock domains (SPEC section 8): fields marked CONTROL, LEDS or RANGE are
 * only touched with that domain held. No path holds two domains at once and
 * nothing sleeps while holding CONTROL; the few values one domain publishes
 * to another (READY drops, the latest echo rise) are atomics.
 *
 * SPEC refers to the libkeel specification, software/libkeel/docs/spec.md.
 */
#ifndef KEEL_CORE_INTERNAL_H
#define KEEL_CORE_INTERNAL_H

#include <stdatomic.h>
#include <stddef.h>
#include <stdint.h>

#include "keel/port.h"

/** @brief Converts milliseconds to microseconds as uint64_t. */
#define KEEL__MS(ms) ((uint64_t)(ms) * UINT64_C(1000))

/** @brief Internal timing and protocol constants not in the public header. */
enum keel__constant {
    /** PWM bytes in one LED driver frame (six LEDs, three channels each). */
    KEEL__RGB_BYTES = 3 * KEEL_LED_COUNT,
    /** The MCU's heartbeat window: no fall for this long means it stopped. */
    KEEL__MCU_HEARTBEAT_MS = 80,
    /** READY LOW for this long while the heartbeat runs: the MCU is latched. */
    KEEL__READY_LOW_OFF_MS = 150,
    /** ARMED HIGH this long into HIGH1 is a stale completion (MCU ACK level
     *  100 ms minus the MCU clock tolerance). */
    KEEL__STALE_ACK_MS = 90,
    /** A stored command whose expiry is closer than this is coasted. */
    KEEL__EXPIRY_MARGIN_US = 1000,
    /** A raw button level must hold this long to be accepted. */
    KEEL__DEBOUNCE_MS = 20,
    /** No echo rise within this time of the trigger: the sensor is unpowered,
     *  locked out or unplugged (UNAVAILABLE). */
    KEEL__ECHO_RISE_MS = 5,
    /** Shortest valid echo pulse (20 mm at 343 m/s). */
    KEEL__ECHO_MIN_US = 117,
    /** Longest valid echo pulse (4 m at 343 m/s); longer is NO_ECHO. */
    KEEL__ECHO_MAX_US = 23300,
    /** An echo rise this recent makes sensor power CONFIRMED. */
    KEEL__ECHO_CONFIRM_MS = 500,
    /** ECHO edges drained from the backend per hook call. */
    KEEL__RANGE_EDGE_BATCH = 8
};

/** @brief Stored motion command and per-wheel reversal bookkeeping (CONTROL). */
typedef struct keel__motion {
    /** ::keel_port_motor_mode of the stored command. */
    uint32_t mode;
    /** Stored duties while driving; zero for COAST and BRAKE. */
    int32_t command[2];
    /** Backend time at which the stored DRIVE or BRAKE ends. */
    uint64_t expiry_us;
    /** Non-zero while a reversal waits for its dwell. */
    int pending;
    /** Duties of the pending reversal. */
    int32_t pending_command[2];
    /** Expiry of the pending reversal, from its acceptance. */
    uint64_t pending_expiry_us;
    /** Last driven direction per wheel: -1, 0 (never driven) or +1. */
    int32_t direction[2];
    /** Non-zero while the wheel is idle (coasting or braking). */
    int idle[2];
    /** Completion time of the write that made the wheel idle. */
    uint64_t idle_since_us[2];
    /** KEEL_SNAP_COMMAND_EXPIRED: the last command outlived its timeout. */
    int expired;
    /** Non-zero while both bridges coast. A brake is idle time for a
     *  reversal but PWM activity for the MCU, so the servo uses this. */
    int coasting;
    /** Completion time of the write that started the current coast. */
    uint64_t coast_since_us;
} keel__motion;

/** @brief Servo burst bookkeeping (CONTROL); a burst is active in KEEL_STATE_SERVO. */
typedef struct keel__servo {
    /** Earliest start of the next burst: 2200 ms after open, after the last
     *  READY-LOW sample and after the completion of the last burst's OFF. */
    uint64_t cooldown_until_us;
    /** Completion time of the REQUEST write; the grant is due within 10 ms. */
    uint64_t requested_us;
    /** Lease end passed to the backend; never extended. */
    uint64_t lease_end_us;
    /** Pulse width driven once the grant is confirmed. */
    uint32_t pulse_us;
    /** ARMED = 0 was seen after the request and the pulse was started. */
    int granted;
    /** A REQUEST was written and no OFF since: the next OFF ends a burst. */
    int active;
} keel__servo;

/** @brief Ultrasonic measurement state (RANGE). */
typedef struct keel__range {
    /** Latest result, full size, as returned by keel_range_poll(). */
    keel_range result;
    /** A measurement is in progress (result.status is PENDING). */
    int pending;
    /** Backend time just before the trigger of the pending measurement. */
    uint64_t trigger_us;
    /** The pending measurement's echo has risen. */
    int risen;
    /** Time of that rise. */
    uint64_t rise_us;
    /** CONTROL's READY-drop count at the trigger. */
    uint32_t ready_drops;
    /** A trigger was issued since open (spacing applies). */
    int have_trigger;
    /** Time of the last trigger. */
    uint64_t last_trigger_us;
} keel__range;

/** @brief Debounce state (CONTROL). */
typedef struct keel__buttons {
    /** Time at which each button's raw level last changed. */
    uint64_t since_us[KEEL_BUTTON_COUNT];
    /** Debounced levels (::keel_button bits). */
    uint32_t held;
    /** Raw levels seen at the last sample. */
    uint32_t candidate;
    /** Press edges not yet taken. */
    uint32_t pressed;
    /** Release edges not yet taken. */
    uint32_t released;
} keel__buttons;

/** @brief One device: the caller's storage for a port, the backend's for a hosted backend. */
typedef struct keel__device {
    /* Immutable after attach. */
    keel_port_backend be;          /**< Copy of the backend table. */
    uint32_t backend_kind;         /**< ::keel_backend reported in the open report. */
    uint32_t caps;                 /**< ::keel_capability bits offered. */
    uint64_t command_timeout_us;   /**< Lifetime of an accepted drive or brake. */
    int single_threaded;           /**< ::KEEL_PORT_SINGLE_THREADED with a thread_id hook. */
    uint64_t attach_thread;        /**< Thread id of the attaching thread. */

    /* Shared across threads without a domain lock. */
    _Atomic uint32_t stop_epoch;   /**< Bumped by every stop call before it locks. */
    _Atomic int closing;           /**< Set when keel_close() starts. */
    _Atomic int32_t last_rejection; /**< Status of the most recent REJECTED call. */
    _Atomic uint32_t ready_drops;  /**< READY HIGH-to-LOW samples (CONTROL writes, RANGE reads). */
    _Atomic int echo_seen;         /**< An echo rose since open (RANGE writes, CONTROL reads). */
    _Atomic uint64_t echo_rise_us; /**< Time of the latest echo rise, valid once echo_seen. */

    /* CONTROL domain. */
    uint32_t handled_epoch;        /**< Newest stop epoch whose effect was applied. */
    uint32_t stopped_state;        /**< ::keel_state in which that epoch was applied. */
    uint32_t stopped_ack;          /**< ::keel_ack_phase in which that epoch was applied. */
    int in_stop_call;              /**< A stop call's own CONTROL section is running. */
    uint32_t state;                /**< ::keel_state. */
    uint32_t ack_phase;            /**< ::keel_ack_phase. */
    uint32_t outputs;              /**< Levels last written (KEEL_OUT_*). */
    uint32_t inputs;               /**< Last sample: KEEL_IN_READY, ARMED, buttons. */
    uint64_t inputs_sampled_us;    /**< Time of that sample. */
    uint64_t observed_us;          /**< Latest clock value, for the monotonicity check. */
    int have_tick;                 /**< A tick was accepted since open or clear. */
    uint64_t last_tick_us;         /**< Time of the last accepted tick. */
    int have_cycle;                /**< A cycle id was accepted since open. */
    uint64_t last_cycle_id;        /**< Last accepted cycle id. */
    int have_fall;                 /**< A heartbeat fall happened since the last (re)start. */
    uint64_t last_fall_us;         /**< Time of the last heartbeat fall. */
    uint64_t hb_not_before_us;     /**< Earliest first pulse after open or clear. */
    int hb_high;                   /**< The heartbeat line is HIGH (pulse in progress). */
    int hb_strict;                 /**< The previous tick ran while ARMING, ARMED or SERVO. */
    int hb_restarted;              /**< The most recent tick restarted the heartbeat. */
    uint32_t hb_falls;             /**< Falls since the heartbeat (re)started. */
    uint32_t heartbeat_restarts;   /**< Restarts after gaps while DISARMED, since open. */
    uint64_t ack_started_us;       /**< Start of the arming acknowledgement. */
    uint64_t phase_at_us;          /**< Completion of the current level's write. */
    int stale_used;                /**< The one stale-ACK restart of this arm was used. */
    uint32_t stale_ack_restarts;   /**< Stale-ACK restarts since open. */
    uint64_t enable_low_since_us;  /**< Completion of the last ENABLE LOW write. */
    int ready_low;                 /**< READY was LOW at the last sample. */
    uint64_t ready_low_since_us;   /**< First sample of the current READY LOW run. */
    int have_owner;                /**< A control owner is recorded. */
    uint64_t owner_thread;         /**< Its thread id. */
    keel_fault record;             /**< First fault since the last clear (or the final record). */
    uint32_t fault_count;          /**< Latches since open. */
    int have_latch;                /**< A fault latched since open (re-arm hold-off). */
    uint64_t latched_at_us;        /**< Time of the last latch. */
    keel__motion motion;           /**< Stored command and reversal state. */
    keel__servo servo;             /**< Servo burst state. */
    keel__buttons buttons;         /**< Debounce state. */
    uint32_t button_leds;          /**< Lit button LEDs (::keel_button bits). */

    /* LEDS domain. */
    uint8_t rgb[KEEL__RGB_BYTES];  /**< Frame last written successfully. */

    /* RANGE domain. */
    keel__range range;             /**< Ultrasonic measurement state. */
} keel__device;

/** @brief A counted reference to a registry entry, held for one call. */
typedef struct keel__ref {
    keel__device *device; /**< The device. */
    uint32_t slot;        /**< Registry slot. */
} keel__ref;

/* ---- registry.c: generation-checked handles ---------------------------- */

/** @brief Publishes @p device and returns its token; KEEL_E_NO_MEMORY when full. */
int32_t keel__registry_add(keel__device *device, keel_device **out_handle);
/** @brief Validates @p handle (owner pid first, without a lock) and takes a
 *  reference. With @p for_close the entry is marked closing, so new calls
 *  get KEEL_E_INVALID_HANDLE; a second close does too. */
int32_t keel__acquire(const keel_device *handle, keel__ref *ref, int for_close);
/** @brief Drops a reference taken by keel__acquire(). */
void keel__release(const keel__ref *ref);
/** @brief Close only: waits until no other call holds a reference, then
 *  frees the slot and bumps its generation. */
void keel__registry_retire(const keel__ref *ref);

/* ---- abi.c: struct versioning rules ------------------------------------ */

/** @brief Input struct rule: NULL, below @p known or above
 *  KEEL_STRUCT_SIZE_MAX is INVALID_ARGUMENT; a
 *  larger struct is accepted only with a zero tail, else UNSUPPORTED. */
int32_t keel__in_check(const void *in, size_t known);
/** @brief Output struct rule: non-NULL with struct_size from @p known to
 *  KEEL_STRUCT_SIZE_MAX. */
int keel__out_ok(const void *out, size_t known);
/** @brief Writes min(struct_size, @p known) bytes of @p src (never the
 *  struct_size field) and zeroes the rest of @p out. */
void keel__out_write(void *out, const void *src, size_t known);

/* ---- attach.c: options and open reports -------------------------------- */

/** @brief Zeroes a full-size report and sets its struct_size and line (-1). */
void keel__report_init(keel_open_report *report);
/** @brief Validates @p in (NULL means defaults) into the full-size @p out;
 *  KEEL_E_INVALID_ARGUMENT (with the report's resource and hint) on error. */
int32_t keel__options_check(const keel_open_options *in, keel_open_options *out,
                            keel_open_report *report);

/* ---- fault.c: status tables ------------------------------------------- */

/** @brief Non-zero for a cause that stays latched until close. */
int keel__cause_sticky(uint32_t cause);
/** @brief Non-zero for a defined FAULT-class status: the only non-OK values
 *  a safety-path hook may pass through (SPEC 12.2). */
int keel__is_fault_status(int32_t status);

/* ---- safety.c: locks, faults, heartbeat, arming, stops ---------------- */
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
